TKWTL/IH01A-Compact_Induction_Heater/Images/README.md

# 图片档案

本目录保存 IH01A PCB/界面照片和实验截图。**图片仅记录具体拍摄与测试状态，不表示产品通过可靠性、效率或安全认证。**

## Product

- [PCB 正面](Product/正面.jpg)
- [PCB 背面](Product/背面.jpg)
- [OLED 关于页面](Product/关于页面.jpg)

## Testing

- **#001 移相驱动**：300 kHz 60°、120° 的实验波形。
- **#002 短脉冲检锅**：无锅、利乐牛奶包装、锅具贴合、1.6 mm 间距的原始截图，与 [检锅报告](../Docs/Experiments/PAN_DETECTION_PULSE_RINGDOWN_STUDY_2026-11-10.md) 对照。
- **#003 模拟信号链路**：300 kHz 空载和标称 71 W 测试工况下，电容电压与 CT、零电流检测、精密整流输出。
- **#004 半桥开关沿**：300 kHz 空载时上升沿与下降沿。
- **pan_*.svg**：从 #002 采样记录整理的描述性统计图，不得将 CCR2 相位计数图解释成精确时域余振包络。

照片命名沿用原试验序号，以便与测量笔记对应。历史文件路径保留在 Git 中；详见 [实验目录](../Docs/README.md)。当前 `Assembly/` 未提供装配照片，因此不提供装配图解。
