TKWTL/IH01A-Compact_Induction_Heater/Docs/Experiments/SWEEP_12V_UNLOADED_REPORT.md

# IH01A 12V 空载扫频/移相实测报告

| 项 | 值 |
|---|---|
| 电源 | **12V**（PD Fixed 12V/3A 合同，`bus≈12.0–12.1 V`） |
| 负载 | **空载（仅线圈，无锅/工件）** |
| 频率 | 160–400 kHz，10 kHz 步进（25 点，降序扫） |
| 移相 | 10–180°，10° 步进（18 点，升角扫） |
| 稳定时间 | 设定命令后 1.0 s 再读数 |
| 采点数 | 450（25×18），链路 0 坏帧，0 次重发 |
| 统计 | `ct_rms_a` max 1.687 A，min 0.000 A |
| 数据 | `Tools/sweep_12V_unloaded.csv`（长表）、`Tools/pivot_{ct,ic2,lag}.csv`（透视） |

## 每频率摘要（IC2 / LAG_DEG / CT_RMS_A）

| kHz | IC2@10° | IC2@180° | LAG@10° | LAG@90° | LAG@180° | CT@10° | CT@90° | CT@180° |
|---|---|---|---|---|---|---|---|---|
| 400 | NA | 301 | NA | +171.3 | +159.5 | 0.000 | 0.000 | 0.007 |
| 390 | NA | 307 | NA | +168.2 | +157.8 | 0.002 | 0.005 | 0.012 |
| 380 | NA | 315 | NA | +165.6 | +157.0 | 0.002 | 0.002 | 0.010 |
| 370 | NA | 320 | NA | +163.1 | +153.7 | 0.002 | 0.007 | 0.024 |
| 360 | NA | 327 | NA | +153.5 | +151.4 | 0.005 | 0.010 | 0.031 |
| 350 | NA | 334 | NA | +150.7 | +149.3 | 0.002 | 0.012 | 0.036 |
| 340 | NA | 341 | NA | +148.6 | +147.2 | 0.002 | 0.012 | 0.044 |
| 330 | NA | 350 | NA | +146.4 | +145.4 | 0.002 | 0.022 | 0.053 |
| 320 | NA | 358 | NA | +145.1 | +142.9 | 0.005 | 0.031 | 0.068 |
| 310 | NA | 368 | NA | +142.5 | +141.2 | 0.002 | 0.034 | 0.075 |
| 300 | NA | 377 | NA | +140.0 | +138.3 | 0.002 | 0.046 | 0.097 |
| 290 | NA | 387 | NA | +138.8 | +136.3 | 0.002 | 0.053 | 0.106 |
| 280 | NA | 398 | NA | +136.3 | +133.9 | 0.005 | 0.073 | 0.123 |
| 270 | NA | 410 | NA | +133.5 | +132.0 | 0.002 | 0.077 | 0.138 |
| 260 | NA | 422 | NA | +130.8 | +129.3 | 0.005 | 0.097 | 0.162 |
| 250 | NA | 435 | NA | +128.1 | +126.4 | 0.002 | 0.111 | 0.181 |
| 240 | NA | 449 | NA | +126.0 | +123.6 | 0.002 | 0.135 | 0.208 |
| 230 | 40 | 465 | -68.8 | +123.8 | +120.9 | 0.005 | 0.160 | 0.244 |
| 220 | 480 | 480 | -157.9 | +120.2 | +117.4 | 0.002 | 0.191 | 0.293 |
| 210 | 456 | 497 | +174.2 | +117.3 | +113.8 | 0.007 | 0.227 | 0.341 |
| 200 | 450 | 515 | +158.2 | +113.8 | +110.1 | 0.005 | 0.273 | 0.409 |
| 190 | 452 | 534 | +146.5 | +109.4 | +105.6 | 0.017 | 0.353 | 0.505 |
| 180 | 459 | 553 | +137.5 | +104.6 | +100.3 | 0.031 | 0.445 | 0.629 |
| 170 | 465 | 571 | +127.4 | +97.5 | +93.2 | 0.058 | 0.621 | 0.909 |
| 160 | 470 | 578 | +116.7 | +85.2 | +80.4 | 0.118 | 0.984 | 1.687 |

## `IC2=NA` 的分布（过零捕获失效区）

共 24 点，全部集中在**高频 + 低相角**（电流最小的角落），重读 2 次仍为 NA：

| kHz | NA 的相角 |
|---|---|
| 400 | 10°, 20° |
| 390 | 10°, 20° |
| 380 | 10°, 20° |
| 370 | 10°, 20° |
| 360 | 10°, 20° |
| 350 | 10°, 20° |
| 340 | 10°, 20° |
| 330 | 10° |
| 320 | 10° |
| 310 | 10° |
| 300 | 10° |
| 290 | 10° |
| 280 | 10° |
| 270 | 10° |
| 260 | 10° |
| 250 | 10° |
| 240 | 10° |

判定边界：`IC2` 可用所需的最小槽路电流约在 **CT_RMS ≈ 0.005–0.01 A**；
240 kHz 时 20° 已可用、10° 不可用，即边界由 频率×相角（等价于电流） 决定，不是固定相角。

## 主要趋势

1. **CT_RMS 随频率下降整体上升**：400 kHz/180° 为 0.007 A，160 kHz/180° 为 1.687 A（约 241 倍），
   符合接近空载谐振（~148.6 kHz）电流抬升的预期。中间 390→380 kHz 有 0.002 A 级回落，属零点/量化噪声量级。
2. **CT_RMS 随移相角单调上升**（每个频率内 10°→180° 递增），12V 空载下最大仅 1.687 A，远低于 10 A 保护门限。
3. **IC2 原始捕获随移相角递增**（如 160 kHz：470→578），随频率下降整体上移（同一个相角下）——捕获窗口跟着 ARR 变大。
4. **LAG_DEG 低频端整体下移**：400 kHz/180° 为 +159.5°，160 kHz/180° 为 +80.4°；低相角端在高频出现负值（-150°～-180° 附近），相角越高越趋于收敛。
5. LAG_DEG 为**未应用补偿表的原始计算角**（`ARR/4+D/2` 模周期），未做空载补偿，不可直接当作 ZVS 判据。

## 复现方式

```powershell
python Tools/heater_sweep.py --port COM19 --on --freqs 400-160:-10 --phases 10-180:10 `
       --settle 1.0 --preflight 6 --abort-ct 10 --supply-v 12 \
       --out Tools/sweep_12V_unloaded.csv
python Tools/heater_sweep_fill.py --csv Tools/sweep_12V_unloaded.csv   # 补测 NA 点
```

安全措施：每个频点先回到 10° 再改频率（不在 180° 下调频）；`CT_RMS_A ≥ 10 A`、ADC 饱和、`FAULT`、
`HEATER` 掉落 任一触发即中止；结束时必发 `heater off`。本次全程未触发，`heater` 状态 450/450 为 ON。
