TKWTL/IH01A-Compact_Induction_Heater/Images/Testing/#003 300K 71W 电容电压与精密整流器输出.png

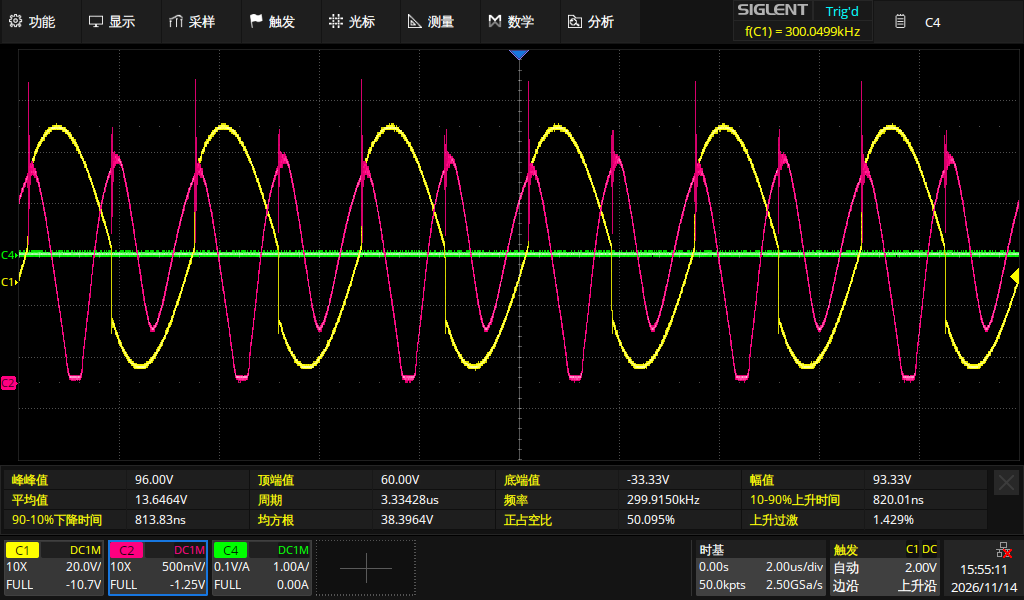
Images/Testing/#003 300K 71W 电容电压与精密整流器输出.png
