TKWTL/IH01A-Compact_Induction_Heater/Images/Testing/#003 300K空载电容电压与CT输出.png

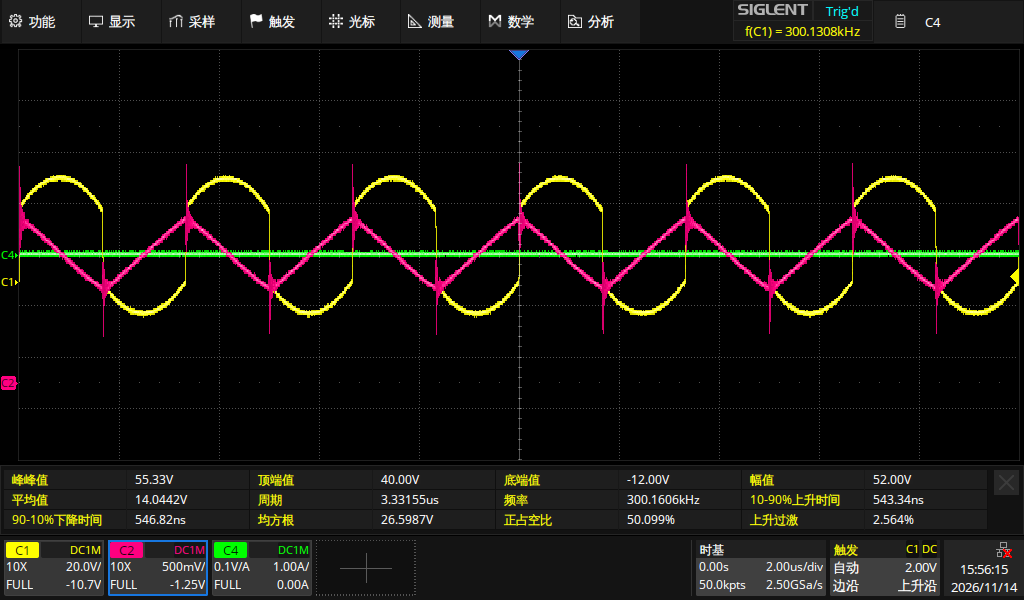
Images/Testing/#003 300K空载电容电压与CT输出.png
