TKWTL/IH01A-Compact_Induction_Heater/Images/Testing/#003 300K空载电容电压与电流过零检测.png

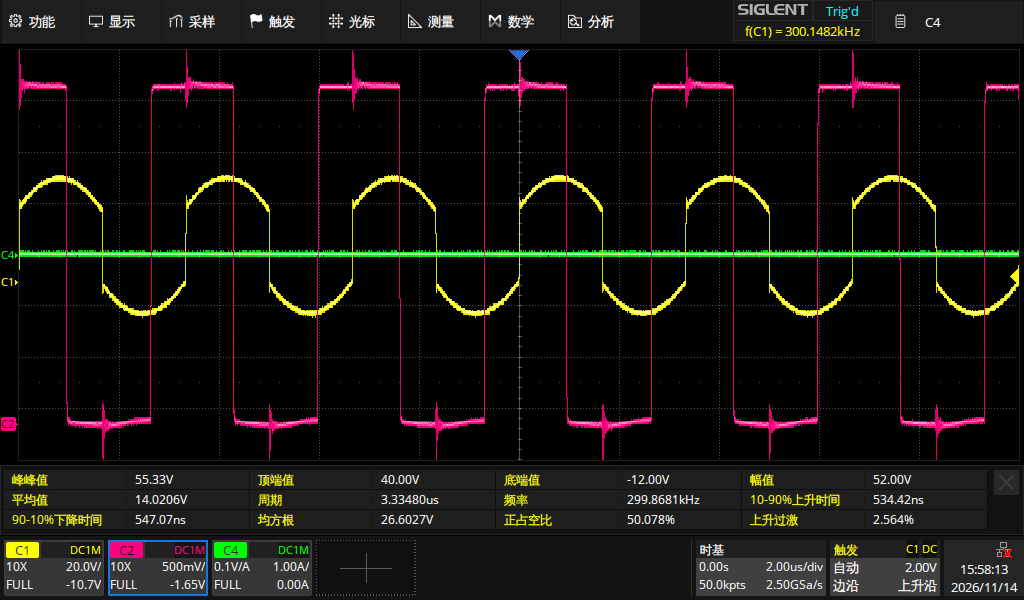
Images/Testing/#003 300K空载电容电压与电流过零检测.png
