TKWTL/IH01A-Compact_Induction_Heater/Images/Testing/#004 300K空载下半桥下降沿.png

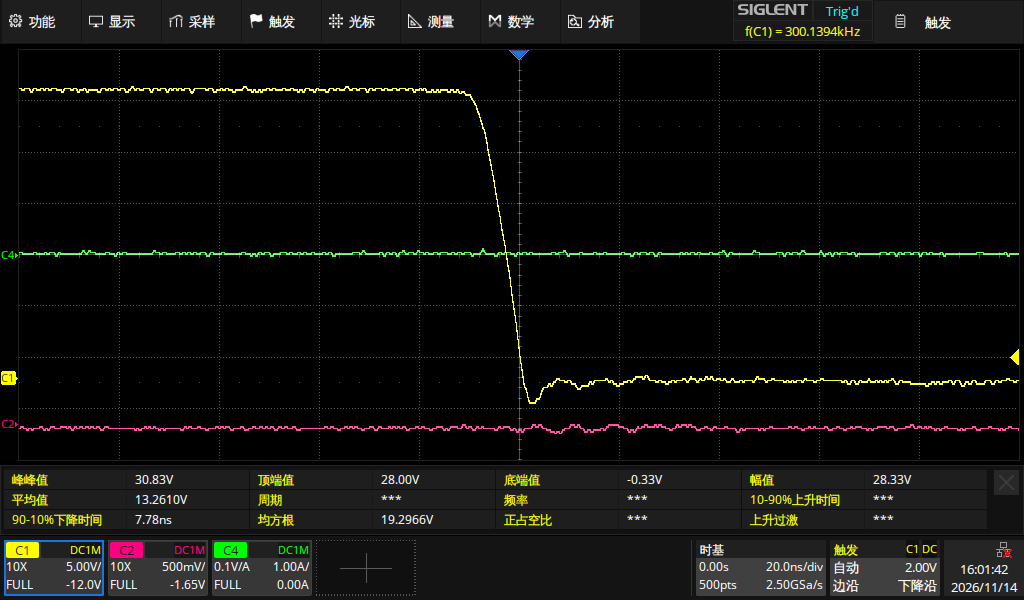
Images/Testing/#004 300K空载下半桥下降沿.png
