TKWTL/IH01A-Compact_Induction_Heater/Firmware/Core/Inc/main.h

#define EEP_WP_Pin LL_GPIO_PIN_13
#define EEP_WP_GPIO_Port GPIOC
#define BEEP_Pin LL_GPIO_PIN_0
#define BEEP_GPIO_Port GPIOF
#define ISR_TIME_Pin LL_GPIO_PIN_1
#define ISR_TIME_GPIO_Port GPIOF
#define ISR_LOAD_Pin LL_GPIO_PIN_0
#define ISR_LOAD_GPIO_Port GPIOA
#define NTC_POT_Pin LL_GPIO_PIN_1
#define NTC_POT_GPIO_Port GPIOA
#define NTC_SYS_Pin LL_GPIO_PIN_2
#define NTC_SYS_GPIO_Port GPIOA
#define CT_OCP_Pin LL_GPIO_PIN_3
#define CT_OCP_GPIO_Port GPIOA
#define VBIAS_Pin LL_GPIO_PIN_4
#define VBIAS_GPIO_Port GPIOA
#define IBUS_Pin LL_GPIO_PIN_5
#define IBUS_GPIO_Port GPIOA
#define VBUS_Pin LL_GPIO_PIN_2
#define VBUS_GPIO_Port GPIOB
#define CT_RMS_Pin LL_GPIO_PIN_10
#define CT_RMS_GPIO_Port GPIOB
#define CT_ZERO_Pin LL_GPIO_PIN_9
#define CT_ZERO_GPIO_Port GPIOA
#define PWM_EN_Pin LL_GPIO_PIN_6
#define PWM_EN_GPIO_Port GPIOC
#define ENTR_Pin LL_GPIO_PIN_7
#define ENTR_GPIO_Port GPIOC
#define R_Pin LL_GPIO_PIN_11
#define R_GPIO_Port GPIOA
#define L_Pin LL_GPIO_PIN_12
#define L_GPIO_Port GPIOA
#define EXIT_Pin LL_GPIO_PIN_3
#define EXIT_GPIO_Port GPIOD
#define D_C_Pin LL_GPIO_PIN_4
#define D_C_GPIO_Port GPIOB
