TKWTL/IH01A-Compact_Induction_Heater/Firmware/USBPD/App/usbpd_pdo_defs.h

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

#ifndef __USBPD_PDO_DEF_H_
#define __USBPD_PDO_DEF_H_

#ifdef __cplusplus
 extern "C" {
#endif

/* Includes ------------------------------------------------------------------*/
#include "usbpd_def.h"

/* Define   ------------------------------------------------------------------*/
#define PORT0_NB_SOURCEPDO         0U   /* Number of Source PDOs (applicable for port 0)   */
#define PORT0_NB_SINKPDO           5U   /* Number of Sink PDOs (applicable for port 0)     */
/* Exported typedef ----------------------------------------------------------*/
/* USER CODE BEGIN typedef */
/**
  * @brief  USBPD Port PDO Structure definition
  *
  */
/* USER CODE END typedef */

/* Exported define -----------------------------------------------------------*/
/* USER CODE BEGIN Exported_Define */

#define USBPD_CORE_PDO_SRC_FIXED_MAX_CURRENT 3
#define USBPD_CORE_PDO_SNK_FIXED_MAX_CURRENT 1500

/* USER CODE END Exported_Define */

/* Exported constants --------------------------------------------------------*/

/* Exported macro ------------------------------------------------------------*/

/* Exported variables --------------------------------------------------------*/
#ifndef __USBPD_PWR_IF_C
extern uint32_t PORT0_PDO_ListSRC[USBPD_MAX_NB_PDO];
extern uint32_t PORT0_PDO_ListSNK[USBPD_MAX_NB_PDO];
#else
/* Definition of Source PDO for Port 0 */
uint32_t PORT0_PDO_ListSRC[USBPD_MAX_NB_PDO] =
{
  /* PDO 1 */ (0x00000000U),
  /* PDO 2 */ (0x00000000U),
  /* PDO 3 */ (0x00000000U),
  /* PDO 4 */ (0x00000000U),
  /* PDO 5 */ (0x00000000U),
  /* PDO 6 */ (0x00000000U),
  /* PDO 7 */ (0x00000000U),
};

/* Definition of Sink PDO for Port 0 */
uint32_t PORT0_PDO_ListSNK[USBPD_MAX_NB_PDO] =
{
  /* PDO 1 */ ((100U << 10) | 300U), /* 5V 3A - SPR Fixed sink */
  /* PDO 2 */ ((180U << 10) | 300U), /* 9V 3A */
  /* PDO 3 */ ((240U << 10) | 300U), /* 12V 3A */
  /* PDO 4 */ ((300U << 10) | 300U), /* 15V 3A */
  /* PDO 5 */ ((400U << 10) | 500U), /* 20V 5A - EPR-capable baseline opening */
  /* PDO 6 */ (0x00000000U),
  /* PDO 7 */ (0x00000000U),
};

#endif

/* Exported functions --------------------------------------------------------*/

#ifdef __cplusplus
}
#endif

#endif /* __USBPD_PDO_DEF_H_ */
