TKWTL/IH01A-Compact_Induction_Heater/Firmware/APP/PowerControl/heater_budget.h

#ifndef IH01A_HEATER_BUDGET_H
#define IH01A_HEATER_BUDGET_H
#include <stdint.h>
#include "PowerControl/heater_control.h"
/* DPC27A-style source selection. Real PD contract outranks VBUS heuristics.
 * No power is available during PD negotiation, even at high VBUS.
 * Mode parameter maps to PD_InputKind without importing the ST PD stack. */
#define HEATER_DCIN_MIN_MV 8000u
#define HEATER_DCIN_CURRENT_MA 7000u
#define HEATER_BUDGET_MAX_MW 270000u
/* RDO current policy (mA): reserve a controller margin, then permit
 * an additional 150mA before the independent IBUS AWD2 watchdog trips.
 * Does not affect the separate CT/TIM1 Break peak-current protection. */
#define HEATER_RDO_HIGH_VOLTAGE_MV 20000u
#define HEATER_RDO_HIGH_MARGIN_MA 100u
#define HEATER_RDO_LOW_MARGIN_MA 200u
#define HEATER_IBUS_PROTECTION_HEADROOM_MA 150u
uint32_t Heater_InputControlLimitMa(uint32_t contract_mv,
                                    uint32_t contract_ma);
uint32_t Heater_InputProtectionLimitMa(uint32_t contract_mv,
                                       uint32_t contract_ma);
HeaterObservation Heater_BudgetClassify(uint32_t bus_mv,uint8_t pd_mode,
    uint8_t contract_valid,uint32_t contract_mv,uint32_t contract_ma);
#endif
