TKWTL/IH01A-Compact_Induction_Heater/Firmware/APP/PowerControl/conv_protection.c

/* IH01A protection bootstrap. Legacy G474 Protection_Init2 was empty;
 * its HRTIM FLT1 and ADC watchdog code are not binary-compatible with G071.
 *
 * CubeMX config: window comparator pair, COMP1 synthesized output to TIM1
 * BRK (active low), DAC1 CH1/CH2 as low/high thresholds.
 * The analog window is initialized AFTER zero capture and with PWM disabled.
 * TIM1 output enable is never granted by this module; real break response
 * and analog gain must still be validated with an oscilloscope.
 */
#include "conv_protection.h"
#include "conv_current.h"
#ifndef CONV_PROTECTION_HOST_TEST
#include "conv_controller.h"
#include "heater_control.h"
#include "main.h"
#include "tim.h"
#include "adc.h"
#include "dac.h"
#include "comp.h"
#include "framework/beep.h"
#include "framework/pm_api.h"
#include "display/dispDriver.h"
#include <stdio.h>
#define PROT_RAMFUNC __attribute__((section(".ih_ramfunc"),used,noinline))
#else
#define PROT_RAMFUNC
#endif
static volatile uint32_t s_fast_faults;
static volatile uint8_t s_zero_status;
static volatile uint16_t s_zero_samples,s_ct_zero,s_ibus_zero;
static volatile uint16_t s_ibus_trip_delta_raw;
static uint32_t s_ibus_limit_ma;
static uint16_t s_awd2_low,s_awd2_high;
/* Completed DMA samples BEFORE AWD2 IRQ: not the exact triggering sample. */
static volatile uint16_t s_ibus_run_last,s_ibus_run_min,s_ibus_run_max;
static volatile uint16_t s_awd2_pre_last,s_awd2_pre_min,s_awd2_pre_max;
static volatile uint8_t s_awd2_trip_valid;
static uint8_t s_comp_armed;
static uint8_t s_awd2_enabled;
static uint32_t s_ct_sum,s_ibus_sum;
static uint16_t s_settle,s_ct_min,s_ct_max,s_ib_min,s_ib_max;
static uint16_t s_dac1,s_dac2,s_low,s_high;
static uint8_t s_profile_ready,s_notified;
static uint32_t s_faults,s_fault_at;

void ConvProtection_Init(void)
{
    s_fast_faults=0u;
    s_zero_status=CONV_ZERO_WAIT;
    s_zero_samples=s_ct_zero=s_ibus_zero=0u;
    s_ibus_trip_delta_raw=0u;
    s_ibus_limit_ma=0u;
    s_awd2_low=0u;
    s_awd2_high=4095u;
    s_ibus_run_last=s_ibus_run_min=s_ibus_run_max=0u;
    s_awd2_pre_last=s_awd2_pre_min=s_awd2_pre_max=0u;
    s_awd2_trip_valid=0u;
    s_comp_armed=0u;
    s_awd2_enabled=0u;
    s_settle=0u;s_ct_sum=s_ibus_sum=0u;
    s_ct_min=s_ib_min=4095u;
    s_ct_max=s_ib_max=0u;
    s_dac1=s_dac2=0u;
    /* Nominal fixed hardware trip setting: +/-16 A peak at CT_OUT 75 mV/A.
     * Delta DAC code = round(16 A * 0.075 V/A * 4095 / 2.5 V) = 1966.
     * This configuration is NOT proof of safe current at any given VBUS,
     * resonance frequency or driver delay. Keep TIM1 hardware Break enabled;
     * verify comparator threshold and switching stress on real hardware.
     * No frequency-dependent capacitor-voltage limit is implemented. */
    s_low=s_high=(uint16_t)((CONV_CT_OUT_MV_PER_A*16u*4095u+1250u)/2500u);
    s_profile_ready=1u;
    s_notified=0u;
    s_faults=s_fault_at=0u;
}
static uint16_t clamp12(int32_t x)
{
    if(x<0)return 0u;
    if(x>4095)return 4095u;
    return (uint16_t)x;
}
void ConvProtection_CalcDacWindow(uint16_t vbias_raw,uint16_t arr,
                                  uint16_t low_delta,uint16_t high_delta,
                                  uint16_t *dac1,uint16_t *dac2)
{
    /* Revised CT_OCP amplifier is 0.075 V/A, independent of switching
     * frequency. ARR is retained only for source/API compatibility. */
    (void)arr;
    if(dac1)*dac1=clamp12((int32_t)vbias_raw-(int32_t)low_delta);
    if(dac2)*dac2=clamp12((int32_t)vbias_raw+(int32_t)high_delta);
}
void ConvProtection_SetDacProfile(uint16_t lo,uint16_t hi,uint8_t calibrated)
{
    s_low=lo;s_high=hi;
    s_profile_ready=(uint8_t)(calibrated && lo && hi);
}
/* Called from ADC1_COMP_IRQHandler before HAL_ADC_IRQHandler.
 * Latch the exact AWD source and make the interrupt one-shot; otherwise a
 * static overtemperature value would retrigger at the ADC scan rate. */
void ConvProtection_AnalogWatchdogISR(void)
{
#ifndef CONV_PROTECTION_HOST_TEST
    uint32_t pending=ADC1->ISR & ADC1->IER &
        (ADC_ISR_AWD1 | ADC_ISR_AWD2 | ADC_ISR_AWD3);
    if(!pending)return;
    if(pending&ADC_ISR_AWD1)s_fast_faults|=CONV_PROT_AWD_VBUS;
    if(pending&ADC_ISR_AWD2)
    {
        /* Source IRQ can precede completion of its DMA frame. */
        s_awd2_pre_last=s_ibus_run_last;
        s_awd2_pre_min=s_ibus_run_min;
        s_awd2_pre_max=s_ibus_run_max;
        s_awd2_trip_valid=1u;
        s_fast_faults|=CONV_PROT_AWD_IBUS;
    }
    if(pending&ADC_ISR_AWD3)s_fast_faults|=CONV_PROT_AWD_SYS;
    /* Disarm the asserted IRQ sources and clear their write-one flags;
     * the ADC scan and DMA remain active for diagnosis. */
    ADC1->IER &= ~pending;
    ADC1->ISR = pending;
    ConvController_TripISR();
#endif
}
PROT_RAMFUNC void ConvProtection_AutoFreqTripISR(void)
{
    s_fast_faults|=CONV_PROT_AUTO_FREQ;
#ifndef CONV_PROTECTION_HOST_TEST
    ConvController_TripISR();
#endif
}
PROT_RAMFUNC void ConvProtection_BreakISR(void)
{
#ifndef CONV_PROTECTION_HOST_TEST
    /* Do not clear BIF: it remains evidence of the first hardware trip.
     * Disable only the break interrupt to avoid a latched IRQ storm. */
    ConvController_TripISR();
    s_fast_faults|=CONV_PROT_TIM1_BREAK;
    TIM1->DIER &= ~TIM_DIER_BIE;
#endif
}
static void ibus_window_codes(uint16_t zero,uint32_t ma,
                              uint16_t *lower,uint16_t *upper)
{
    /* 0.2134 V/A; compute absolute current envelope around measured zero.
     * AWD2 checks only 8 MSBs: low rounds UP and high DOWN to avoid gaps
     * near nominal threshold; always retain 0..4095 legal bounds. */
    uint64_t raw=(uint64_t)ma*2134u*4095u+12500000u;
    uint32_t delta=(uint32_t)(raw/25000000u);
    uint32_t hi=(uint32_t)zero+delta;
    uint32_t lo=(delta>zero)?0u:(uint32_t)zero-delta;
    if(hi>4095u)hi=4095u;
    if(lower)*lower=(uint16_t)(((lo+15u)/16u)*16u);
    if(upper)*upper=(uint16_t)((hi/16u)*16u);
}
void ConvProtection_SetIbusLimitMa(uint32_t current_ma)
{
#ifndef CONV_PROTECTION_HOST_TEST
    uint16_t lower=0u,upper=4080u;
    uint8_t armed=(uint8_t)(ConvProtection_ZeroReady() && current_ma &&
                           !s_fast_faults && !s_faults);
    if(armed)ibus_window_codes(s_ibus_zero,current_ma,&lower,&upper);
    if(current_ma==s_ibus_limit_ma && lower==s_awd2_low &&
       upper==s_awd2_high && s_awd2_enabled==armed)return;
    if(armed && !s_awd2_enabled)
    {
        s_ibus_run_last=s_ibus_run_min=s_ibus_run_max=s_ibus_zero;
        s_awd2_trip_valid=0u;
    }
    s_awd2_enabled=armed;
    s_ibus_limit_ma=current_ma;
    s_awd2_low=lower;
    s_awd2_high=upper;
    ADC1->IER &= ~ADC_IER_AWD2IE;
    MODIFY_REG(ADC1->AWD2TR,ADC_AWD2TR_HT2|ADC_AWD2TR_LT2,
               ((uint32_t)upper<<ADC_AWD2TR_HT2_Pos) |
               ((uint32_t)lower<<ADC_AWD2TR_LT2_Pos));
    ADC1->ISR=ADC_ISR_AWD2;
    if(s_awd2_enabled)ADC1->IER |= ADC_IER_AWD2IE;
#else
    {
        uint8_t armed=(uint8_t)(ConvProtection_ZeroReady() && current_ma &&
                                !s_fast_faults && !s_faults);
        if(armed && !s_awd2_enabled)
        {
            s_ibus_run_last=s_ibus_run_min=s_ibus_run_max=s_ibus_zero;
            s_awd2_trip_valid=0u;
        }
        s_ibus_limit_ma=current_ma;
        s_awd2_low=0u;s_awd2_high=4080u;
        s_awd2_enabled=armed;
        if(s_awd2_enabled)
            ibus_window_codes(s_ibus_zero,current_ma,&s_awd2_low,&s_awd2_high);
    }
#endif
}

PROT_RAMFUNC void ConvProtection_FrameISR(const volatile uint16_t *frame)
{
    uint16_t ct,ibus;
    if(!frame)return;
    if(s_awd2_enabled && !s_awd2_trip_valid &&
       s_zero_status==CONV_ZERO_READY)
    {
        uint16_t sample=frame[CONV_ADC_IBUS];
        s_ibus_run_last=sample;
        if(sample<s_ibus_run_min)s_ibus_run_min=sample;
        if(sample>s_ibus_run_max)s_ibus_run_max=sample;
    }
    /* Raw watchdog equivalents run in the existing DMA IRQ; these detect
     * ADC rail/saturation, not accurately calibrated physical current. */
#ifndef CONV_PROTECTION_HOST_TEST
    /* Frame counter only; the old 10 s BENCH_TIMEOUT latch is gone, so a long
     * bench run no longer reports a spurious 0x00010000 fault. */
    (void)ConvController_BenchAdcFrameWatchdogISR();
#endif
    if(frame[CONV_ADC_VBUS]>=CONV_PROT_VBUS_RAIL_RAW)
    {
        s_fast_faults|=CONV_PROT_VBUS_RAIL;
#ifndef CONV_PROTECTION_HOST_TEST
        ConvController_TripISR();
#endif
    }
    if(frame[CONV_ADC_IBUS]>=CONV_PROT_IBUS_RAIL_RAW ||
       (s_zero_status==CONV_ZERO_READY && s_ibus_zero>=32u &&
        frame[CONV_ADC_IBUS]<=5u))
    {
        s_fast_faults|=CONV_PROT_IBUS_RAIL;
#ifndef CONV_PROTECTION_HOST_TEST
        ConvController_TripISR();
#endif
    }
    if(s_zero_status==CONV_ZERO_READY)
    {
        uint16_t current=frame[CONV_ADC_IBUS];
        uint16_t delta=(current>s_ibus_zero) ?
                       (uint16_t)(current-s_ibus_zero) :
                       (uint16_t)(s_ibus_zero-current);
        if(s_ibus_trip_delta_raw && delta>s_ibus_trip_delta_raw)
        {
            s_fast_faults|=CONV_PROT_IBUS_LIMIT;
#ifndef CONV_PROTECTION_HOST_TEST
            ConvController_TripISR();
#endif
        }
        return;
    }
    if(s_zero_status==CONV_ZERO_FAILED)return;
#ifndef CONV_PROTECTION_HOST_TEST
    /* Hard interlock: a zero window is invalid if the bridge was ever
     * enabled during settling or averaging. This check is independent
     * of the MiaoUI RUN request and scheduled start state. */
    if((TIM1->BDTR & TIM_BDTR_MOE)!=0u ||
       (PWM_EN_GPIO_Port->ODR & PWM_EN_Pin)!=0u)
    {
        s_zero_status=CONV_ZERO_FAILED;
        s_fast_faults|=CONV_PROT_ZERO_SWITCHING;
        ConvController_TripISR();
        return;
    }
#endif
    if(s_settle<CONV_ZERO_SETTLE_FRAMES){++s_settle;return;}
    s_zero_status=CONV_ZERO_COLLECT;
    ct=frame[CONV_ADC_CT_RMS];
    ibus=frame[CONV_ADC_IBUS];
    if(ct<s_ct_min)s_ct_min=ct;
    if(ct>s_ct_max)s_ct_max=ct;
    if(ibus<s_ib_min)s_ib_min=ibus;
    if(ibus>s_ib_max)s_ib_max=ibus;
    s_ct_sum+=ct;s_ibus_sum+=ibus;
    if(++s_zero_samples<CONV_ZERO_AVG_FRAMES)return;
    if((uint16_t)(s_ct_max-s_ct_min)>CONV_ZERO_MAX_SPAN_RAW ||
       (uint16_t)(s_ib_max-s_ib_min)>CONV_ZERO_MAX_SPAN_RAW ||
       s_ct_max>=4090u)
    {
        s_zero_status=CONV_ZERO_FAILED;
        s_fast_faults|=CONV_PROT_ZERO_UNSTABLE;
        return;
    }
    s_ct_zero=(uint16_t)((s_ct_sum+CONV_ZERO_AVG_FRAMES/2u)/
                          CONV_ZERO_AVG_FRAMES);
    s_ibus_zero=(uint16_t)((s_ibus_sum+CONV_ZERO_AVG_FRAMES/2u)/
                            CONV_ZERO_AVG_FRAMES);
    s_zero_status=CONV_ZERO_READY;
}
void ConvProtection_SetIbusTripDeltaRaw(uint16_t delta_raw)
{
    s_ibus_trip_delta_raw=delta_raw;
}
uint8_t ConvProtection_ZeroReady(void)
{
    return s_zero_status==CONV_ZERO_READY;
}
uint8_t ConvProtection_RequestZeroRecalibration(void)
{
#ifndef CONV_PROTECTION_HOST_TEST
    uint32_t irqmask=__get_PRIMASK();
    /* TIM6->ADC/DMA updates the zero averaging fields from its ISR; reset
     * all of them atomically while neither PC6 nor TIM1 MOE is enabled. */
    __disable_irq();
    if((PWM_EN_GPIO_Port->ODR&PWM_EN_Pin)!=0u ||
       (TIM1->BDTR&TIM_BDTR_MOE)!=0u ||
       s_zero_status!=CONV_ZERO_FAILED ||
       !ConvProtection_RearmableMask(ConvProtection_FaultMask()))
    {
        if((irqmask&1u)==0u)__enable_irq();
        return 0u;
    }
#else
    if(s_zero_status!=CONV_ZERO_FAILED ||
       !ConvProtection_RearmableMask(ConvProtection_FaultMask()))
        return 0u;
#endif
    /* This is a fresh calibration request only. Do NOT clear existing
     * evidence or turn on the bridge automatically after it completes. */
    s_zero_status=CONV_ZERO_WAIT;
    s_settle=0u;
    s_zero_samples=0u;
    s_ct_sum=s_ibus_sum=0u;
    s_ct_min=s_ib_min=4095u;
    s_ct_max=s_ib_max=0u;
    s_ct_zero=s_ibus_zero=0u;
#ifndef CONV_PROTECTION_HOST_TEST
    if((irqmask&1u)==0u)__enable_irq();
#endif
    return 1u;
}
uint32_t ConvProtection_FaultMask(void)
{
    return s_faults|s_fast_faults;
}

/* Only transient protection events are eligible for operator acknowledgment.
 * Failed zero calibration, comparator/DAC setup and auto-frequency validation
 * are NOT cleared by a manual start. */
#define CONV_REARMABLE_FAULTS ( \
    CONV_PROT_VBUS_RAIL | CONV_PROT_IBUS_RAIL | \
    CONV_PROT_ZERO_UNSTABLE | CONV_PROT_ZERO_SWITCHING | \
    CONV_PROT_NTC_POT | CONV_PROT_NTC_SYS | CONV_PROT_VBUS_LOW | \
    CONV_PROT_ADC_STALE | CONV_PROT_IBUS_LIMIT | \
    CONV_PROT_AWD_VBUS | CONV_PROT_AWD_IBUS | CONV_PROT_AWD_SYS | \
    CONV_PROT_TIM1_BREAK | CONV_PROT_BENCH_VBUS )
uint8_t ConvProtection_RearmableMask(uint32_t fault_mask)
{
    return (uint8_t)((fault_mask&~((uint32_t)CONV_REARMABLE_FAULTS))==0u);
}
uint8_t ConvProtection_AnalogInputsSafe(void)
{
#ifndef CONV_PROTECTION_HOST_TEST
    if(!s_comp_armed ||
       (COMP1->CSR&COMP_CSR_EN)==0u ||
       (COMP2->CSR&COMP_CSR_EN)==0u)
        return 0u;
    if(!ConvProtection_WithinWindow(
            (COMP1->CSR&COMP_CSR_VALUE)!=0u,
            (COMP2->CSR&COMP_CSR_VALUE)!=0u))
        return 0u;
    return (uint8_t)((GPIOA->IDR&LL_GPIO_PIN_6)!=0u);
#else
    return 0u;
#endif
}
/* Called only after a user RUN gesture with PC6 LOW.
 * Clearing the old diagnostic latch MUST also re-arm all one-shot
 * hardware ADC watchdog IRQs. Persistent electrical faults are rejected. */
uint8_t ConvProtection_VbusSamplesSafe(uint16_t raw,uint16_t filtered)
{
    /* Keep actual ~8V undervoltage and ADC rail monitoring; the previous
     * 1050..1400 ADC code range was 12V-only and rejected valid 20/28V.
     * The caller additionally verifies the active PD contract against VBUS. */
    return (uint8_t)(raw>=819u && filtered>=819u &&
                     raw<CONV_PROT_VBUS_RAIL_RAW &&
                     filtered<CONV_PROT_VBUS_RAIL_RAW);
}
uint8_t ConvProtection_ManualRearm(uint32_t now_ms)
{
#ifndef CONV_PROTECTION_HOST_TEST
    ConvADC_Snapshot adc;
    uint16_t lo,hi,raw,filtered,delta;
    uint32_t faults,primask;
    faults=ConvProtection_FaultMask();
    if(!faults)return 1u;
    if(!ConvProtection_RearmableMask(faults) ||
       s_zero_status!=CONV_ZERO_READY ||
       !s_profile_ready || !s_comp_armed ||
       s_ibus_limit_ma==0u ||
       (uint32_t)(now_ms-s_fault_at)<100u ||
       (PWM_EN_GPIO_Port->ODR&PWM_EN_Pin)!=0u ||
       !ConvProtection_AnalogInputsSafe())
        return 0u;
    ConvADC_CopySnapshot(&adc);
    if(!adc.frames ||
       adc.raw[CONV_ADC_IBUS]<=5u ||
       adc.raw[CONV_ADC_IBUS]>=CONV_PROT_IBUS_RAIL_RAW ||
       !ConvProtection_VbusSamplesSafe(
           adc.raw[CONV_ADC_VBUS],adc.filtered[CONV_ADC_VBUS]) ||
       adc.raw[CONV_ADC_NTC_SYS]<640u ||
       adc.filtered[CONV_ADC_NTC_SYS]<640u ||
       adc.raw[CONV_ADC_VBIAS]<s_low ||
       (uint32_t)adc.raw[CONV_ADC_VBIAS]+s_high>4095u)
        return 0u;
    ibus_window_codes(s_ibus_zero,s_ibus_limit_ma,&lo,&hi);
    raw=adc.raw[CONV_ADC_IBUS];
    filtered=adc.filtered[CONV_ADC_IBUS];
    /* AWD2 compares the 8 MSBs. Stay at least 16 ADC codes inside
     * its actual window to prevent immediate quantization-edge retrips. */
    if(hi<=lo+32u ||
       raw<=lo+16u || raw>=hi-16u ||
       filtered<=lo+16u || filtered>=hi-16u)
        return 0u;
    delta=(uint16_t)(raw>s_ibus_zero?raw-s_ibus_zero:s_ibus_zero-raw);
    if(s_ibus_trip_delta_raw && delta>=s_ibus_trip_delta_raw)
        return 0u;

    primask=__get_PRIMASK();
    __disable_irq();
    /* Do not clear an IRQ fault if any fresh interrupt appeared between
     * the ADC copy and this critical section. */
    if(ConvProtection_FaultMask()!=faults ||
       (PWM_EN_GPIO_Port->ODR&PWM_EN_Pin)!=0u ||
       !ConvProtection_AnalogInputsSafe())
    {
        if((primask&1u)==0u)__enable_irq();
        return 0u;
    }
    ADC1->IER &= ~(ADC_IER_AWD1IE|ADC_IER_AWD2IE|ADC_IER_AWD3IE);
    ADC1->ISR=ADC_ISR_AWD1|ADC_ISR_AWD2|ADC_ISR_AWD3;
    s_fast_faults=0u;
    s_faults=0u;
    s_notified=0u; /* allow a new alarm on a genuine second trip */
    s_fault_at=0u; /* remove the old fault overlay */
    s_awd2_enabled=0u;
    ConvProtection_SetIbusLimitMa(s_ibus_limit_ma);
    ADC1->IER |= ADC_IER_AWD1IE|ADC_IER_AWD3IE;
    if((primask&1u)==0u)__enable_irq();
    return (uint8_t)(ConvProtection_FaultMask()==0u && s_awd2_enabled);
#else
    (void)now_ms;
    return 0u;
#endif
}

uint8_t ConvProtection_WithinWindow(uint8_t above_low,uint8_t above_high)
{
    /* At positive comparator inputs shared from CT_OCP:
     * COMP1 compares signal > lower DAC, COMP2 compares signal > upper DAC.
     * Window synthesized on COMP1_OUT is (COMP1 xor COMP2).
     * HAL_COMP_GetOutputLevel() reads a comparator's individual CSR.VALUE
     * and therefore MUST NOT be used alone as the window output level. */
    return (uint8_t)((above_low!=0u) && (above_high==0u));
}
uint8_t ConvProtection_CompArmed(void)
{
#ifndef CONV_PROTECTION_HOST_TEST
    return (uint8_t)(s_comp_armed &&
                     (COMP1->CSR&COMP_CSR_EN)!=0u &&
                     (COMP2->CSR&COMP_CSR_EN)!=0u &&
                     ConvProtection_FaultMask()==0u);
#else
    return 0u;
#endif
}
uint8_t ConvProtection_WindowSafe(void)
{
#ifndef CONV_PROTECTION_HOST_TEST
    if(!ConvProtection_ZeroReady() ||
       ConvProtection_FaultMask()!=0u ||
       !ConvProtection_AnalogInputsSafe() ||
       (TIM1->SR&TIM_SR_BIF)!=0u)
        return 0u;
    return 1u;
#else
    return 0u; /* host has no COMP/GPIO hardware */
#endif
}
void ConvProtection_GetSnapshot(ConvProtectionSnapshot *out)
{
    if(!out)return;
    out->zero_status=(ConvZeroStatus)s_zero_status;
    out->ct_zero_raw=s_ct_zero;
    out->ibus_zero_raw=s_ibus_zero;
    out->zero_samples=s_zero_samples;
    out->dac1_code=s_dac1;out->dac2_code=s_dac2;
    out->dac_profile_ready=s_profile_ready;
    out->comp_armed=s_comp_armed;
    out->awd2_enabled=s_awd2_enabled;
    out->awd2_low_code=s_awd2_low;
    out->awd2_high_code=s_awd2_high;
    out->ibus_limit_ma=s_ibus_limit_ma;
    out->awd2_trip_valid=s_awd2_trip_valid;
    out->awd2_pre_last_raw=s_awd2_pre_last;
    out->awd2_pre_min_raw=s_awd2_pre_min;
    out->awd2_pre_max_raw=s_awd2_pre_max;
    out->ibus_run_last_raw=s_ibus_run_last;
    out->ibus_run_min_raw=s_ibus_run_min;
    out->ibus_run_max_raw=s_ibus_run_max;
    out->fault_mask=ConvProtection_FaultMask();
}
#ifndef CONV_PROTECTION_HOST_TEST
static uint8_t Protection_ApplyCompWindow(uint16_t lower,uint16_t upper)
{
    if(!s_comp_armed)
    {
        /* No switching while analog references and window mode initialize. */
        ConvController_TripISR();
        if(HAL_DAC_SetValue(&hdac1,DAC_CHANNEL_1,DAC_ALIGN_12B_R,lower)!=HAL_OK ||
           HAL_DAC_SetValue(&hdac1,DAC_CHANNEL_2,DAC_ALIGN_12B_R,upper)!=HAL_OK ||
           HAL_DAC_Start(&hdac1,DAC_CHANNEL_1)!=HAL_OK ||
           HAL_DAC_Start(&hdac1,DAC_CHANNEL_2)!=HAL_OK)
            return 0u;

        /* MX_COMP2_Init executes after MX_COMP1_Init and the HAL can clear
         * the shared WINMODE bits. Reapply the requested COMP1 window
         * configuration AFTER both handles are initialized. */
        if(HAL_COMP_Init(&hcomp1)!=HAL_OK)return 0u;
        if(HAL_COMP_Start(&hcomp1)!=HAL_OK ||
           HAL_COMP_Start(&hcomp2)!=HAL_OK)return 0u;
        /* COMP1 window output high=within thresholds, low=outside;
         * TIM1 Break polarity LOW. This must be oscilloscope-validated
         * before allowing a nonzero heater power target. */
        s_comp_armed=1u;
        return 1u;
    }
    if(lower!=s_dac1 || upper!=s_dac2)
    {
        if(HAL_DAC_SetValue(&hdac1,DAC_CHANNEL_1,DAC_ALIGN_12B_R,lower)!=HAL_OK ||
           HAL_DAC_SetValue(&hdac1,DAC_CHANNEL_2,DAC_ALIGN_12B_R,upper)!=HAL_OK)
            return 0u;
    }
    return 1u;
}
#endif

void ConvProtection_Service(uint32_t now,const ConvADC_Snapshot *adc,
                            const TempService_Snapshot *temp)
{
    uint32_t fresh=s_fast_faults;
    uint8_t heating=0u;
#ifndef CONV_PROTECTION_HOST_TEST
    HeaterSnapshot heater;
    Heater_GetSnapshot(&heater);
    heating=(uint8_t)(heater.state==HEATER_RUN_REQUESTED);
#endif
    if(adc && adc->frames)
    {
        /* For ±12A at revised 0.075V/A, both DAC codes must be legal.
         * An out-of-range VBIAS would invalidate the two-sided trip window. */
        if(s_profile_ready && ConvProtection_ZeroReady() &&
           (ConvProtection_FaultMask()==0u ||
            ConvProtection_RearmableMask(ConvProtection_FaultMask())))
        {
            uint16_t bias=adc->filtered[CONV_ADC_VBIAS];
            uint16_t lower,upper;
            if(bias<s_low || (uint32_t)bias+s_high>4095u)
                fresh|=CONV_PROT_DAC_RANGE;
            else
            {
                ConvProtection_CalcDacWindow(bias,0u,s_low,s_high,
                                              &lower,&upper);
#ifndef CONV_PROTECTION_HOST_TEST
                if(!Protection_ApplyCompWindow(lower,upper))
                    fresh|=CONV_PROT_COMP_SETUP;
                else
#endif
                {
                    s_dac1=lower;
                    s_dac2=upper;
                }
            }
        }
        /* VBUS ~8V lower bound: ADC 2.5V ref and external x16 divider. */
        if(heating && adc->filtered[CONV_ADC_VBUS]<819u)
            fresh|=CONV_PROT_VBUS_LOW;
    }
    if(heating && temp)
    {
        if(!(temp->valid&TEMP_VALID_POT) || temp->pot_deci_c>=1300)
            fresh|=CONV_PROT_NTC_POT;
        if(!(temp->valid&TEMP_VALID_SYS) || temp->sys_deci_c>=850)
            fresh|=CONV_PROT_NTC_SYS;
        if((uint32_t)(now-temp->updated_ms)>500u)
            fresh|=CONV_PROT_ADC_STALE;
    }
    fresh &= ~s_faults;
    if(!fresh)return;
#ifndef CONV_PROTECTION_HOST_TEST
    if(fresh&CONV_PROT_AWD_IBUS)
    {
        /* Logged once from foreground, NEVER from ADC IRQ.
         * PRE_* are prior completed DMA samples, not the tripping ADC DR. */
        printf("[AWD2_IBUS] TRIP_MA=%lu ZERO=%u LO=%u HI=%u "
               "PRE_LAST=%u PRE_MIN=%u PRE_MAX=%u VALID=%u\r\n",
               (unsigned long)s_ibus_limit_ma,(unsigned)s_ibus_zero,
               (unsigned)s_awd2_low,(unsigned)s_awd2_high,
               (unsigned)s_awd2_pre_last,(unsigned)s_awd2_pre_min,
               (unsigned)s_awd2_pre_max,(unsigned)s_awd2_trip_valid);
    }
#endif
    s_faults|=fresh;
    s_fault_at=now;
#ifndef CONV_PROTECTION_HOST_TEST
    ConvController_TripISR(); /* foreground faults also gate PWM immediately */
    Heater_LatchFault(s_faults);
    pm_api_refresh_idle();
    if(!s_notified)
    {
        static const beep_note_t alarm[]={
            {BEEP_A5,100u},{BEEP_REST,80u},{BEEP_A5,150u},BEEP_END
        };
        (void)beep_popup(alarm);
        s_notified=1u;
    }
#endif
}
#ifndef CONV_PROTECTION_HOST_TEST
void ConvProtection_DrawFaultOverlay(void)
{
    char line[25];
    uint32_t now=HAL_GetTick();
    if(!s_faults || (uint32_t)(now-s_fault_at)>=4000u)return;
    Disp_ClearBuffer();
    Disp_SetFont(UI_FONT);
    Disp_DrawFrame(0u,0u,128u,64u);
    Disp_DrawStr(8u,15u,"HEATER FAULT");
    (void)snprintf(line,sizeof(line),"CODE %08lX",(unsigned long)s_faults);
    Disp_DrawStr(8u,33u,line);
    Disp_DrawStr(8u,51u,"OUTPUT DISABLED");
    Disp_SendBuffer();
}
#endif
