TKWTL/IH01A-Compact_Induction_Heater/Firmware/APP/PowerControl/conv_current.c

#include "conv_current.h"
uint32_t ConvCurrent_CtRmsMilliAmp(uint16_t filtered_raw,uint16_t zero_raw)
{
    uint32_t delta,den;
    if(filtered_raw>4095u)filtered_raw=4095u;
    if(zero_raw>4095u)zero_raw=4095u;
    if(filtered_raw<=zero_raw)return 0u;
    delta=(uint32_t)(filtered_raw-zero_raw);
    /* CT_OUT 0.100 -> 0.075 V/A (3/4). Unchanged rectifier gain implies
     * CT_RMS 0.25253*3/4 = 0.1893975 V/A. Bench recalibration required.
     * I[mA] = delta * 1,000,000,000 / (4095 * 25253 * 3). */
    den=4095u*25253u*3u;
    return (uint32_t)(((uint64_t)delta*1000000000u+den/2u)/den);
}

int32_t ConvCurrent_IbusMilliAmp(uint16_t filtered_raw,uint16_t zero_raw)
{
    int32_t delta=(int32_t)filtered_raw-(int32_t)zero_raw;
    uint32_t magnitude,ma,den=4095u*2134u;
    if(filtered_raw>4095u || zero_raw>4095u)return 0;
    magnitude=(uint32_t)(delta<0?-delta:delta);
    /* 0.2134 V/A = 2134/10 mV/A; VREF 2500mV.
     * mA = |delta| * (2500*1000*10)/(4095*2134).
     * uint64_t prevents overflow with the full 12-bit ADC span. */
    ma=(uint32_t)(((uint64_t)magnitude*25000000u+den/2u)/den);
    return delta<0?-(int32_t)ma:(int32_t)ma;
}
