TKWTL/IH01A-Compact_Induction_Heater/Firmware/ST_USBPD_Library_v541/Devices/STM32G0XX/src/usbpd_phy_hw_if.c

/**
  ******************************************************************************
  * @file    usbpd_phy_hw_if.c
  * @author  MCD Application Team
  * @brief   This file contains phy interface control functions.
  ******************************************************************************
  * @attention
  *
  * Copyright (c) 2018 STMicroelectronics.
  * All rights reserved.
  *
  * This software is licensed under terms that can be found in the LICENSE file
  * in the root directory of this software component.
  * If no LICENSE file comes with this software, it is provided AS-IS.
  *
  ******************************************************************************
  */

/* Includes ------------------------------------------------------------------*/
#define USBPD_PHY_HW_IF_C

#include "usbpd_devices_conf.h"
#include "usbpd_hw.h"
#include "usbpd_core.h"
#include "usbpd_hw_if.h"
/* IH01A: EPR / hardware policy switches (IH01A_PD_FORCE_SINK_TXOK, ...).
 * Must be included before the IS_... helpers below use them. */
#include "algorithm/pd_epr_policy.h"
#if !defined(USBPDCORE_LIB_NO_PD)
#include "usbpd_timersserver.h"
#endif /* !USBPDCORE_LIB_NO_PD */
#if defined(_LOW_POWER)
#include "usbpd_lowpower.h"
#include "usbpd_cad_hw_if.h"
#endif /* _LOW_POWER */

/* Private typedef -----------------------------------------------------------*/
#define PHY_ENTER_CRITICAL_SECTION()  uint32_t primask = __get_PRIMASK(); \
  __disable_irq();

#define PHY_LEAVE_CRITICAL_SECTION()  __set_PRIMASK(primask);

/* Private function prototypes -----------------------------------------------*/
USBPD_PORT_HandleTypeDef Ports[USBPD_PORT_COUNT];


/* Private functions ---------------------------------------------------------*/


void USBPD_HW_IF_GlobalHwInit(void)
{
  /* PWR register access (for disabling dead battery feature) */
  LL_APB1_GRP1_EnableClock(LL_APB1_GRP1_PERIPH_PWR);
  LL_AHB1_GRP1_EnableClock(LL_AHB1_GRP1_PERIPH_CRC);

}

#if !defined(USBPDCORE_LIB_NO_PD)
void USBPD_HW_IF_StopBISTMode2(uint8_t PortNum)
{
  uint32_t  _cr = READ_REG(Ports[PortNum].husbpd->CR) & ~(UCPD_CR_TXMODE | UCPD_CR_TXSEND);

  LL_UCPD_Disable(Ports[PortNum].husbpd);
  LL_UCPD_Enable(Ports[PortNum].husbpd);

  Ports[PortNum].husbpd->CR = _cr;
}

USBPD_StatusTypeDef USBPD_HW_IF_SendBuffer(uint8_t PortNum, USBPD_SOPType_TypeDef Type, uint8_t *pBuffer, uint32_t Size)
{
  USBPD_StatusTypeDef _status = USBPD_OK;

  /* IH01A: record what actually reaches the wire (one record per message
   * type). App-level logs cannot tell "PE built nothing" from "PE built it
   * and the PHY dropped it"; this can. Queue only, no printing here. */
  if ((USBPD_SOPTYPE_HARD_RESET != Type) && (0U != Size))
  {
    extern void PD_TxTrace(uint32_t type, uint32_t hdr, uint32_t size,
                           uint32_t do1, uint32_t do2);
    {
      uint32_t _d1 = 0U, _d2 = 0U;
      if (Size >= 6U)
      {
        _d1 = (uint32_t)pBuffer[2] | ((uint32_t)pBuffer[3] << 8) |
              ((uint32_t)pBuffer[4] << 16) | ((uint32_t)pBuffer[5] << 24);
        if (Size >= 10U)
          _d2 = (uint32_t)pBuffer[6] | ((uint32_t)pBuffer[7] << 8) |
                ((uint32_t)pBuffer[8] << 16) | ((uint32_t)pBuffer[9] << 24);
      }
      PD_TxTrace((uint32_t)(pBuffer[0] & 0x1FU),
                 (uint32_t)pBuffer[0] | ((uint32_t)pBuffer[1] << 8), Size,
                 _d1, _d2);
    }
  }

  if (USBPD_SOPTYPE_HARD_RESET == Type)
  {
    LL_UCPD_SendHardReset(Ports[PortNum].husbpd);
  }
  else
  {
    PHY_ENTER_CRITICAL_SECTION()

    /* If RX is ongoing or if a DMA transfer is active then discard the buffer sending */
    if ((Ports[PortNum].RXStatus == USBPD_TRUE) || ((Ports[PortNum].hdmatx->CCR &  DMA_CCR_EN) == DMA_CCR_EN))
    {
      PHY_LEAVE_CRITICAL_SECTION()
      _status = USBPD_ERROR;
      /* IH01A: the PHY refused this message. A PE that does not retry would
       * look exactly like "request accepted, nothing ever happens". */
      if (0U != Size)
      {
        extern void PD_TxReject(uint32_t type, uint32_t status);
        PD_TxReject((uint32_t)(pBuffer[0] & 0x1FU), (uint32_t)_status);
      }
    }
    else
    {
      PHY_LEAVE_CRITICAL_SECTION()

      switch (Type)
      {
        case USBPD_SOPTYPE_SOP :
        {
          LL_UCPD_WriteTxOrderSet(Ports[PortNum].husbpd, LL_UCPD_ORDERED_SET_SOP);
          LL_UCPD_SetTxMode(Ports[PortNum].husbpd, LL_UCPD_TXMODE_NORMAL);
          break;
        }
        case USBPD_SOPTYPE_SOP1 :
        {
          LL_UCPD_WriteTxOrderSet(Ports[PortNum].husbpd, LL_UCPD_ORDERED_SET_SOP1);
          LL_UCPD_SetTxMode(Ports[PortNum].husbpd, LL_UCPD_TXMODE_NORMAL);
          break;
        }
        case USBPD_SOPTYPE_SOP2 :
        {
          LL_UCPD_WriteTxOrderSet(Ports[PortNum].husbpd, LL_UCPD_ORDERED_SET_SOP2);
          LL_UCPD_SetTxMode(Ports[PortNum].husbpd, LL_UCPD_TXMODE_NORMAL);
          break;
        }
        case USBPD_SOPTYPE_CABLE_RESET :
        {
          LL_UCPD_SetTxMode(Ports[PortNum].husbpd, LL_UCPD_TXMODE_CABLE_RESET);
          break;
        }
        case USBPD_SOPTYPE_BIST_MODE_2 :
        {
          LL_UCPD_SetTxMode(Ports[PortNum].husbpd, LL_UCPD_TXMODE_BIST_CARRIER2);
          break;
        }
        default :
          _status = USBPD_ERROR;
          break;
      }

      if (USBPD_OK == _status)
      {
#if defined(_LOW_POWER)
        UTIL_LPM_SetStopMode(0 == PortNum ? LPM_PE_0 : LPM_PE_1, UTIL_LPM_DISABLE);
#endif /* _LOW_POWER */
        CLEAR_BIT(Ports[PortNum].hdmatx->CCR, DMA_CCR_EN);
        while ((Ports[PortNum].hdmatx->CCR &  DMA_CCR_EN) == DMA_CCR_EN);

        WRITE_REG(Ports[PortNum].hdmatx->CMAR, (uint32_t)pBuffer);
        WRITE_REG(Ports[PortNum].hdmatx->CNDTR, Size);
        SET_BIT(Ports[PortNum].hdmatx->CCR, DMA_CCR_EN);

        LL_UCPD_WriteTxPaySize(Ports[PortNum].husbpd, Size);
        LL_UCPD_SendMessage(Ports[PortNum].husbpd);
      }
    }
  }
  return _status;
}

void USBPD_HW_IF_Send_BIST_Pattern(uint8_t PortNum)
{
  LL_UCPD_SetTxMode(Ports[PortNum].husbpd, LL_UCPD_TXMODE_BIST_CARRIER2);
  LL_UCPD_SendMessage(Ports[PortNum].husbpd);
}
#endif /* !USBPDCORE_LIB_NO_PD */

/**
  * @brief  Assert Rp resistors
  * @param  PortNum Port
  * @retval None
  */
void USBPDM1_AssertRp(uint8_t PortNum)
{
  LL_APB2_GRP1_EnableClock(LL_APB2_GRP1_PERIPH_SYSCFG);
  switch (Ports[PortNum].params->RpResistor)
  {
    case vRp_Default :
      LL_UCPD_SetRpResistor(Ports[PortNum].husbpd, LL_UCPD_RESISTOR_DEFAULT);
      break;
    case vRp_1_5A:
      LL_UCPD_SetRpResistor(Ports[PortNum].husbpd, LL_UCPD_RESISTOR_1_5A);
      break;
    case vRp_3_0A:
      LL_UCPD_SetRpResistor(Ports[PortNum].husbpd, LL_UCPD_RESISTOR_3_0A);
      break;
    default:
      break;
  }
  LL_UCPD_SetccEnable(Ports[PortNum].husbpd, LL_UCPD_CCENABLE_NONE);
  LL_UCPD_SetSRCRole(Ports[PortNum].husbpd);
  if (CCNONE == Ports[PortNum].CCx)
  {
    LL_UCPD_SetccEnable(Ports[PortNum].husbpd, LL_UCPD_CCENABLE_CC1CC2);
  }
  else
  {
    LL_UCPD_SetccEnable(Ports[PortNum].husbpd,
                        (Ports[PortNum].CCx == CC1) ? LL_UCPD_CCENABLE_CC1 : LL_UCPD_CCENABLE_CC2);
  }
  SET_BIT(SYSCFG->CFGR1, (Ports[PortNum].husbpd == UCPD1) ? SYSCFG_CFGR1_UCPD1_STROBE : SYSCFG_CFGR1_UCPD2_STROBE);

#if defined(TCPP0203_SUPPORT)
  BSP_USBPD_PWR_SetRole(PortNum, POWER_ROLE_SOURCE);
#endif /* TCPP0203_SUPPORT */
}
/**
  * @brief  De-assert Rp resistors
  * @param  PortNum Port
  * @retval None
  */
void USBPDM1_DeAssertRp(uint8_t PortNum)
{
  /* Not needed on STM32G0xx, so nothing to do, keep only for compatibility */
  UNUSED(PortNum);
}

/**
  * @brief  Assert Rd resistors
  * @param  PortNum Port
  * @retval None
  */
void USBPDM1_AssertRd(uint8_t PortNum)
{
  LL_UCPD_TypeCDetectionCC2Disable(Ports[PortNum].husbpd);
  LL_UCPD_TypeCDetectionCC1Disable(Ports[PortNum].husbpd);

  LL_APB2_GRP1_EnableClock(LL_APB2_GRP1_PERIPH_SYSCFG);
  LL_UCPD_SetccEnable(Ports[PortNum].husbpd, LL_UCPD_CCENABLE_NONE);
  LL_UCPD_SetSNKRole(Ports[PortNum].husbpd);
  if (CCNONE == Ports[PortNum].CCx)
  {
    LL_UCPD_SetccEnable(Ports[PortNum].husbpd, LL_UCPD_CCENABLE_CC1CC2);
  }
  else
  {
    LL_UCPD_SetccEnable(Ports[PortNum].husbpd,
                        (Ports[PortNum].CCx == CC1) ? LL_UCPD_CCENABLE_CC1 : LL_UCPD_CCENABLE_CC2);
  }

  SET_BIT(SYSCFG->CFGR1, (Ports[PortNum].husbpd == UCPD1) ? SYSCFG_CFGR1_UCPD1_STROBE : SYSCFG_CFGR1_UCPD2_STROBE);
  HAL_Delay(1);

#ifndef _LOW_POWER
  LL_UCPD_TypeCDetectionCC2Enable(Ports[PortNum].husbpd);
  LL_UCPD_TypeCDetectionCC1Enable(Ports[PortNum].husbpd);
#endif /* _LOW_POWER */

#if defined(TCPP0203_SUPPORT)
  BSP_USBPD_PWR_SetRole(PortNum, POWER_ROLE_SINK);
#endif /* TCPP0203_SUPPORT */
}

/**
  * @brief  Assert Rd resistors
  * @param  PortNum Port
  * @retval none
  */
void USBPDM1_DeAssertRd(uint8_t PortNum)
{
  /* Not needed on STM32G0xx, so nothing to do, keep only for compatibility */
  UNUSED(PortNum);
}

/**
  * @brief  Enter error recovery
  * @param  PortNum Port
  * @retval None
  */
void USBPDM1_EnterErrorRecovery(uint8_t PortNum)
{
  LL_APB2_GRP1_EnableClock(LL_APB2_GRP1_PERIPH_SYSCFG);
  LL_UCPD_SetSRCRole(Ports[PortNum].husbpd);
  LL_UCPD_SetRpResistor(Ports[PortNum].husbpd, LL_UCPD_RESISTOR_NONE);
  LL_UCPD_SetccEnable(Ports[PortNum].husbpd, LL_UCPD_CCENABLE_NONE);
  SET_BIT(SYSCFG->CFGR1, (Ports[PortNum].husbpd == UCPD1) ? SYSCFG_CFGR1_UCPD1_STROBE : SYSCFG_CFGR1_UCPD2_STROBE);
  LL_UCPD_RxDisable(Ports[PortNum].husbpd);

#if !defined(USBPDCORE_LIB_NO_PD)
  if (Ports[PortNum].settings->PE_PD3_Support.d.PE_FastRoleSwapSupport == USBPD_TRUE)
  {
    /* Set GPIO to disallow the FRS RX handling */
    LL_UCPD_FRSDetectionDisable(Ports[PortNum].husbpd);
  }
#endif /* USBPDCORE_LIB_NO_PD */
}

/**
  * @brief  Set the correct CC pin on the comparator
  * @param  PortNum Port
  * @param  cc CC pin based on @ref CCxPin_TypeDef
  * @retval None
  */
void USBPDM1_Set_CC(uint8_t PortNum, CCxPin_TypeDef cc)
{
  /* Set the correct pin on the comparator */
  Ports[PortNum].CCx = cc;
  LL_UCPD_SetCCPin(Ports[PortNum].husbpd, (cc == CC1) ? LL_UCPD_CCPIN_CC1 : LL_UCPD_CCPIN_CC2);
}

/**
  * @brief  Enable RX interrupt
  * @param  PortNum Port
  * @retval None
  */
void USBPDM1_RX_EnableInterrupt(uint8_t PortNum)
{
  /* Enable the RX interrupt process */
  MODIFY_REG(Ports[PortNum].husbpd->IMR,
             UCPD_IMR_RXORDDETIE | UCPD_IMR_RXHRSTDETIE | UCPD_IMR_RXOVRIE | UCPD_IMR_RXMSGENDIE,
             UCPD_IMR_RXORDDETIE | UCPD_IMR_RXHRSTDETIE | UCPD_IMR_RXOVRIE | UCPD_IMR_RXMSGENDIE);
  LL_UCPD_RxDMAEnable(Ports[PortNum].husbpd);
}

/**
  * @brief  Enable RX
  * @param  PortNum Port
  * @retval None
  */
void USBPD_HW_IF_EnableRX(uint8_t PortNum)
{
  LL_UCPD_RxEnable(Ports[PortNum].husbpd);
}

/**
  * @brief  Disable RX
  * @param  PortNum Port
  * @retval None
  */
void USBPD_HW_IF_DisableRX(uint8_t PortNum)
{
  LL_UCPD_RxDisable(Ports[PortNum].husbpd);
}

void HW_SignalAttachement(uint8_t PortNum, CCxPin_TypeDef cc)
{
#if !defined(USBPDCORE_LIB_NO_PD)
  uint32_t _temp;

  /* Init timer to detect the reception of goodCRC */
  USBPD_TIM_Init();

  /* Prepare ucpd to handle PD message
            RX message start listen
            TX prepare the DMA to be transfer ready
            Detection listen only the line corresponding CC=Rd for SRC/SNK */
  Ports[PortNum].hdmatx = USBPD_HW_Init_DMATxInstance(PortNum);
  Ports[PortNum].hdmarx = USBPD_HW_Init_DMARxInstance(PortNum);

  /* Set the RX dma to allow reception */
  _temp = (uint32_t)&Ports[PortNum].husbpd->RXDR;
  WRITE_REG(Ports[PortNum].hdmarx->CPAR, _temp);
  WRITE_REG(Ports[PortNum].hdmarx->CMAR, (uint32_t)Ports[PortNum].ptr_RxBuff);
  Ports[PortNum].hdmarx->CNDTR = SIZE_MAX_PD_TRANSACTION_UNCHUNK;
  Ports[PortNum].hdmarx->CCR |= DMA_CCR_EN;

  /* Set the TX dma only UCPD address */
  _temp = (uint32_t)&Ports[PortNum].husbpd->TXDR;
  Ports[PortNum].hdmatx->CPAR = _temp;

  /* Disabled non Rd line set CC line enable */
#define INTERRUPT_MASK  UCPD_IMR_TXMSGDISCIE | UCPD_IMR_TXMSGSENTIE | UCPD_IMR_HRSTDISCIE  | UCPD_IMR_HRSTSENTIE |  \
  UCPD_IMR_TXMSGABTIE  | UCPD_IMR_TXUNDIE     | UCPD_IMR_RXORDDETIE  | UCPD_IMR_RXHRSTDETIE | \
  UCPD_IMR_RXOVRIE     | UCPD_IMR_RXMSGENDIE

  MODIFY_REG(Ports[PortNum].husbpd->IMR, INTERRUPT_MASK, INTERRUPT_MASK);
#endif /* !USBPDCORE_LIB_NO_PD */

  /* Handle CC enable */
  Ports[PortNum].CCx = cc;

#if !defined(USBPDCORE_LIB_NO_PD)
  /* Set CC pin for PD message */
  LL_UCPD_SetCCPin(Ports[PortNum].husbpd, (Ports[PortNum].CCx == CC1) ? LL_UCPD_CCPIN_CC1 : LL_UCPD_CCPIN_CC2);


#if defined(_VCONN_SUPPORT)
  /* Initialize Vconn management */
  (void)BSP_USBPD_PWR_VCONNInit(PortNum, (Ports[PortNum].CCx == CC1) ? 1u : 2u);
#endif /* _VCONN_SUPPORT */

  if (Ports[PortNum].settings->PE_PD3_Support.d.PE_FastRoleSwapSupport == USBPD_TRUE)
  {
    /* Set GPIO to allow the FRS TX handling */
    USBPD_HW_SetFRSSignalling(PortNum, (Ports[PortNum].CCx == CC1) ? 1u : 2u);
    /* Enable FRS RX */
    LL_UCPD_FRSDetectionEnable(Ports[PortNum].husbpd);
    Ports[PortNum].husbpd->IMR |= UCPD_IMR_FRSEVTIE;
  }

  /* Disable the Resistor on Vconn PIN */
  if (Ports[PortNum].CCx == CC1)
  {
    LL_UCPD_SetccEnable(Ports[PortNum].husbpd, LL_UCPD_CCENABLE_CC1);
  }
  else
  {
    LL_UCPD_SetccEnable(Ports[PortNum].husbpd, LL_UCPD_CCENABLE_CC2);
  }

  /* Prepare the rx processing */
  LL_UCPD_SetRxMode(Ports[PortNum].husbpd, LL_UCPD_RXMODE_NORMAL);
  LL_UCPD_RxDMAEnable(Ports[PortNum].husbpd);
  LL_UCPD_TxDMAEnable(Ports[PortNum].husbpd);
#endif /* !USBPDCORE_LIB_NO_PD */
}


void HW_SignalDetachment(uint8_t PortNum)
{
#if !defined(USBPDCORE_LIB_NO_PD)
  /* Stop DMA RX/TX */
  LL_UCPD_RxDMADisable(Ports[PortNum].husbpd);
  LL_UCPD_TxDMADisable(Ports[PortNum].husbpd);
  LL_UCPD_RxDisable(Ports[PortNum].husbpd);

#if !defined(_LOW_POWER) && !defined(USBPDM1_VCC_FEATURE_ENABLED)
  /* Enable only detection interrupt */
  WRITE_REG(Ports[PortNum].husbpd->IMR, UCPD_IMR_TYPECEVT1IE | UCPD_IMR_TYPECEVT2IE);
#elif defined(_LOW_POWER)
#if !defined(_DRP)
  if (USBPD_PORTPOWERROLE_SRC == Ports[PortNum].params->PE_PowerRole)
  {
    /* Enable detection interrupt */
    WRITE_REG(Ports[PortNum].husbpd->IMR, UCPD_IMR_TYPECEVT1IE | UCPD_IMR_TYPECEVT2IE);
  }
#endif /* !_DRP */
#endif /* !_LOW_POWER && !USBPDM1_VCC_FEATURE_ENABLED */

  USBPD_HW_DeInit_DMATxInstance(PortNum);
  USBPD_HW_DeInit_DMARxInstance(PortNum);

  LL_UCPD_SetccEnable(Ports[PortNum].husbpd, LL_UCPD_CCENABLE_CC1CC2);

  if (USBPD_PORTPOWERROLE_SNK == Ports[PortNum].params->PE_PowerRole)
  {
#if defined(_VCONN_SUPPORT)
    /* DeInitialize Vconn management */
    (void)BSP_USBPD_PWR_VCONNDeInit(PortNum, (Ports[PortNum].CCx == CC1) ? 1u : 2u);
#endif /* _VCONN_SUPPORT */
    /* DeInitialise VBUS power */
    (void)BSP_USBPD_PWR_VBUSDeInit(PortNum);
  }

  if (Ports[PortNum].settings->PE_PD3_Support.d.PE_FastRoleSwapSupport == USBPD_TRUE)
  {
    /* Set GPIO to disallow the FRS RX handling */
    LL_UCPD_FRSDetectionDisable(Ports[PortNum].husbpd);
  }

#endif /* !USBPDCORE_LIB_NO_PD */
  Ports[PortNum].CCx = CCNONE;
#if !defined(USBPDCORE_LIB_NO_PD)
  /* DeInit timer to detect the reception of goodCRC */
  USBPD_TIM_DeInit();
#endif /* !USBPDCORE_LIB_NO_PD */
}

/**
  * @brief  Set resistors to SinkTxNG
  * @param  PortNum Port
  * @retval None
  */
void USBPD_HW_IF_SetResistor_SinkTxNG(uint8_t PortNum)
{
  /* Set the resistor SinkTxNG 1.5A5V */
  LL_UCPD_SetRpResistor(Ports[PortNum].husbpd, LL_UCPD_RESISTOR_1_5A);
}

/**
  * @brief  Set resistors to SinkTxOk
  * @param  PortNum Port
  * @retval None
  */
void USBPD_HW_IF_SetResistor_SinkTxOK(uint8_t PortNum)
{
  /* Set the resistor SinkTxNG 3.0A5V */
  LL_UCPD_SetRpResistor(Ports[PortNum].husbpd, LL_UCPD_RESISTOR_3_0A);
}

/**
  * @brief  Check if resistors are set to SinkTxOk
  * @param  PortNum Port
  * @retval USBPD_TRUE if resistor is set to SinkTxOk, else USBPD_FALSE
  */
uint8_t USBPD_HW_IF_IsResistor_SinkTxOk(uint8_t PortNum)
{
#if IH01A_PD_FORCE_SINK_TXOK
  /* IH01A: this board presents an external Rd and the UCPD CC detector does
   * not report the Rp-3.0 A vstate the stock test looks for, so the predicate
   * stays FALSE. ST's policy engine gates every DPM-initiated transmission
   * (Get_Source_Capability, EPR_Mode, re-Request) on this check and therefore
   * accepts the request and never transmits it, which is exactly what the
   * bench shows. Reactive messages (GoodCRC, Request inside the response
   * window) are unaffected, so SPR keeps working.
   * Returning TRUE keeps the original behaviour available through the macro. */
  extern void PD_SinkTxOkProbe(uint32_t ccx, uint32_t vstate);
  PD_SinkTxOkProbe((uint32_t)Ports[PortNum].CCx,
                   (uint32_t)(Ports[PortNum].husbpd->SR & UCPD_SR_TYPEC_VSTATE_CC1));
  (void)PortNum;
  return USBPD_TRUE;
#else
#if defined(_LOW_POWER)
  /* When in low power mode, the type C state machine is turned off.
     To retrieve any potential updates of the SR register, the state machine needs to be re-enabled briefly. */

  /* Enable type C state machine */
  CLEAR_BIT(Ports[PortNum].husbpd->CR, (UCPD_CR_CC1TCDIS | UCPD_CR_CC2TCDIS));

  /* Let time for internal state machine to refresh his state */
  for (uint32_t index = 0; index < CAD_DELAY_READ_CC_STATUS; index++)
  {
    __DSB();
  }

  /* Disable type C state machine */
  SET_BIT(Ports[PortNum].husbpd->CR, (UCPD_CR_CC1TCDIS | UCPD_CR_CC2TCDIS));
#endif /* _LOW_POWER */

  switch (Ports[PortNum].CCx)
  {
    case CC1 :
      if ((Ports[PortNum].husbpd->SR & UCPD_SR_TYPEC_VSTATE_CC1) == LL_UCPD_SNK_CC1_VRP30A)
      {
        return USBPD_TRUE;
      }
      break;
    case CC2 :
      if ((Ports[PortNum].husbpd->SR & UCPD_SR_TYPEC_VSTATE_CC2) == LL_UCPD_SNK_CC2_VRP30A)
      {
        return USBPD_TRUE;
      }
      break;
    default:
      break;
  }

  return USBPD_FALSE;
#endif /* IH01A_PD_FORCE_SINK_TXOK */
}

/**
  * @brief  Signal a Fast Role Swap
  * @param  PortNum Port
  * @retval None
  */
void USBPD_HW_IF_FastRoleSwapSignalling(uint8_t PortNum)
{
  LL_UCPD_SignalFRSTX(Ports[PortNum].husbpd);
}
