TKWTL/IH01A-Compact_Induction_Heater/Firmware/APP/algorithm/pd_epr_policy.h

#ifndef IH01A_PD_EPR_POLICY_H
#define IH01A_PD_EPR_POLICY_H
/* IMPORTANT: Enable ONLY after verifying complete 28V/5A input path,
 * independent OVP and a certified 240W EPR e-marked cable.
 * Setting this to 1 authorizes an actual 28V request; leave OFF until then.
 */
/* The hardware owner approved the 28V input path on 2026-11-02.
 * At boot: negotiate the highest legal SPR Fixed contract first, then enter
 * EPR once per attach if Source/cable eligibility permits. This power policy
 * NEVER starts the heater; power-stage safeguards remain independent.
 */
#define IH01A_EPR_28V5A_HARDWARE_APPROVED 1
/* Auto-enter EPR after an explicit SPR contract when Source and cable permit.
 * On unavailable/rejected EPR, retain the highest legal SPR Fixed contract
 * (typically <=20V). 'pd auto' may disable it for diagnostics. */
#define IH01A_EPR_28V5A_AUTO_ENTER 1
#define IH01A_PD_DEFAULT_FIXED_MAX_V 28u

/* 2026-11-02 analyzer: ST FULL v5.4.1 sends EPR KeepAlive at 500 ms.
 * A foreground AMS registered with USBPD_PE_Send_ExtendeControlMessage()
 * was accepted/rejected but did not add a frame on CC. Keep the stable
 * library-managed cadence. Set to 1 ONLY for a bounded diagnostic probe;
 * it never provides a production 375 ms KeepAlive pacer. */
#define IH01A_EPR_APP_KEEPALIVE_PROBE 0

/* EPR policy numbers. The three values must stay consistent: the Sink
 * advertises PDP = 28V x current and asks for exactly that current, so a
 * 84W PDP together with a 5A Sink PDO / 5A request would be a spec
 * mismatch that a Source is entitled to reject.
 *
 *   28 V x 5 A = 140 W  (current branch policy, 240W e-marked cable)
 *   28 V x 3 A =  84 W  (fallback policy if the cable/input path cannot
 *                        be certified for 5 A: also set the Sink PDO
 *                        current and the 28V/5A acceptance in pd_input.c)
 */
#define IH01A_EPR_SINK_PDP_W       140u
#define IH01A_EPR_SINK_CURRENT_MA  5000u

/* SPR hardware current ceiling. The request follows the Source Fixed PDO
 * up to 7 A; a 20V/7A capability is handled like any other Fixed object,
 * with no special identification or extra application approval steps. */
/* Board power path reviewed for 7 A SPR use. Source Fixed PDO provides the
 * offered current limit (including SW3538's 20V/7A non-standard PDO).
 * Clamp at the hardware ceiling; there is NO hardcoded 20V/7A profile and
 * no additional cable-confirmation application step. */
#define IH01A_PD_SPR_MAX_MA        7000u

/* USBPD_PE_Request_EPRModeEnter() only registers a generic machine and wakes
 * the PE (see its disassembly: it validates the last Request header, writes
 * 0xA8 into the PE "machine state" byte and calls the wake-up callback).
 * The machine itself is only executed from the PE_STATE_GENERIC branch of
 * USBPD_PE_StateMachine_SNK, so a request posted while the sink sits idle in
 * PE_SNK_Ready can stay pending for ever (second call then returns BUSY).
 * With this switch the app tries two fallbacks once the request has been
 * pending for 1 s:
 *   A) USBPD_PE_Request_DataMessage(USBPD_DATAMSG_EPR_MODE) directly;
 *   B) re-issue the current SPR Request so the PE processes a Request
 *      context, then register EPR entry from the POWER_EXPLICIT_CONTRACT
 *      notification (i.e. from PE callback context).
 */
#define IH01A_EPR_STALL_FALLBACK   1

/* Register the EPR entry only from PE callback context: re-issue the current
 * SPR Request first, then call USBPD_PE_Request_EPRModeEnter() from the
 * POWER_EXPLICIT_CONTRACT notification. Calling it from the idle main loop
 * leaves the library's EPR machine pending for ever (bench-proved: BUSY on
 * every later request, no PD_TX at all). */
#define IH01A_EPR_REENTER_ON_CONTRACT 1

/* ST's PE gates every DPM-initiated transmission on USBPD_PE_...SinkTxOK,
 * which is derived from the UCPD CC vstate (Rp 3.0 A). This board presents an
 * external Rd, so that predicate reads FALSE and every app-driven message
 * (Get_Source_Capability, EPR_Mode, re-Request) is accepted and then silently
 * dropped, while reactive messages still work (SPR is fine). Force the
 * predicate TRUE so the PE actually transmits. */
#define IH01A_PD_FORCE_SINK_TXOK   1

/* The verified CH32X035 sink delays EPR_Get_Source_Cap by 120 ms after
 * EPRMODE_SUCCEEDED; their notes record that sending it immediately caused
 * 'Enter Succeeded followed by Source Hard Reset'. ST's PE sends it after
 * 7 ms, so decline that early capability set and fetch it ourselves later. */
#define IH01A_EPR_DELAY_GETCAP     0
#define IH01A_EPR_GETCAP_DELAY_MS  120u

/* Requested current for the EPR contract. The source hard-resets our EPR_Request
 * even with a bit-exact RDO/CopyPDO, so 5 A is the next suspect: a Source that
 * cannot grant 5 A (cable e-marker rating) may answer with a Hard Reset. Drop to
 * 3 A to find out whether current is the discriminator. */
#define IH01A_EPR_REQUEST_MA       5000u

/* Object position convention proven on the bench with this source: the EPR
 * request must use the ABSOLUTE position (8..13, continuing the SPR list).
 * The 1-based index inside EPR_Source_Capabilities (1..6) is rejected with a
 * Hard Reset. 'pd epr1' still selects the local convention for experiments. */
#define IH01A_EPR_OPOS_ABSOLUTE_DEFAULT 1

/* Explicit EPR_Mode Exit (USBPD_PE_Request_EPRModeExit). OFF by default.
 * Bench (Lenovo C140, 28 V/5 A -> 'pd off'): the EPR_Mode Action=Exit message
 * reached the wire and was GoodCRC'd, then the whole cooperative superloop
 * stopped - no further diary line, no capability answer to the source's ~20
 * Source_Capabilities retransmissions, OLED frozen at its last frame, no
 * reboot. The PE API registers an AMS machine that wants to be completed from
 * the same loop that called it, so it must not be used from the idle main
 * loop (same failure class as calling EPRModeEnter from there).
 * With 0, 'pd off' from an EPR contract instead refreshes the SPR capability
 * set and requests the highest legal Fixed SPR PDO through the proven
 * Evaluate -> Request -> PS_RDY pipeline (implicit EPR exit). */
#define IH01A_EPR_EXIT_API_FALLBACK 0
#endif
