TKWTL/IH01A-Compact_Induction_Heater/Firmware/APP/PowerControl/conv_pwm.c

#include "conv_pwm.h"
#include <math.h>
#include <armdsp.h>

#define HRTIM_CMP_FLOOR_LIMIT   0x30U                                           //根据手册RM0440来确定指定倍频/分频数下的值

void Timer_Init(ui_t *ui){
    SetFrequency(ui);

    LL_HRTIM_TIM_SetCompare1(HRTIM1, LL_HRTIM_TIMER_MASTER, INITIAL_HRTIM_PERIOD/2);
    LL_HRTIM_TIM_SetCompare2(HRTIM1, LL_HRTIM_TIMER_MASTER, INITIAL_HRTIM_PERIOD/2);

    // ADC 采样延迟配置：使采样时刻精确配合三角波中点，需实测
    // Master CMP1 → 复位同步 ABC 从定时器
    LL_HRTIM_TIM_SetCompare4(HRTIM1, LL_HRTIM_TIMER_A, 3000);//A CMP4→ADC4: IA/VBC/VZS
    LL_HRTIM_TIM_SetCompare3(HRTIM1, LL_HRTIM_TIMER_B, 2000);//B CMP3→ADC3: IB/VAB
    LL_HRTIM_TIM_SetCompare4(HRTIM1, LL_HRTIM_TIMER_C, 3000);//C CMP4→ADC2: IC/VCM
    LL_HRTIM_TIM_SetCompare3(HRTIM1, LL_HRTIM_TIMER_D, 3000);//D CMP3→ADC1(触发MainLoop)
    LL_HRTIM_TIM_SetCompare3(HRTIM1, LL_HRTIM_TIMER_E, INITIAL_HRTIM_PERIOD - 3000);//E CMP3→ADC1(与D共同触发MainLoop)

	LL_HRTIM_TIM_CounterEnable(HRTIM1,  LL_HRTIM_TIMER_MASTER|
                                        LL_HRTIM_TIMER_A|
                                        LL_HRTIM_TIMER_B|
                                        LL_HRTIM_TIMER_C|
                                        LL_HRTIM_TIMER_D|
                                        LL_HRTIM_TIMER_E
    );
    // MainLoop 由 ADC1 EOS 中断触发，不需要 HRTIM 中断
}

//重装载值96~65503
//比较值0~65503
RAMVAR uint32_t g_Timer_Period;//周期值（未减去1）
RAMVAR uint32_t g_Timer_CompareMax;//比较器限幅值，由HRTIM的缺陷而产生

int SwitchingFrequency = DEFAULT_FSW_KHZ;

//设置开关频率，只保证两个很近频率间切换的稳定性
void SetFrequency(ui_t *ui){
    g_Timer_Period = 120000UL* 8UL/ SwitchingFrequency;
    if(g_Timer_Period > 65536U- HRTIM_CMP_FLOOR_LIMIT) g_Timer_Period = 65536U- HRTIM_CMP_FLOOR_LIMIT;
    else if(g_Timer_Period < HRTIM_CMP_FLOOR_LIMIT) g_Timer_Period = HRTIM_CMP_FLOOR_LIMIT;
    //更改重装载值
    LL_HRTIM_TIM_SetPeriod(HRTIM1, LL_HRTIM_TIMER_A, g_Timer_Period);
    LL_HRTIM_TIM_SetPeriod(HRTIM1, LL_HRTIM_TIMER_B, g_Timer_Period);
    LL_HRTIM_TIM_SetPeriod(HRTIM1, LL_HRTIM_TIMER_C, g_Timer_Period);
    LL_HRTIM_TIM_SetPeriod(HRTIM1, LL_HRTIM_TIMER_D, g_Timer_Period);
    LL_HRTIM_TIM_SetPeriod(HRTIM1, LL_HRTIM_TIMER_E, g_Timer_Period);
    //更改同步触发
    LL_HRTIM_TIM_SetPeriod(HRTIM1, LL_HRTIM_TIMER_MASTER, g_Timer_Period);
    LL_HRTIM_TIM_SetCompare1(HRTIM1, LL_HRTIM_TIMER_MASTER, g_Timer_Period / 2);//Master CMP1 复位同步 ABC（三相逆变载波同步）
    LL_HRTIM_TIM_SetCompare2(HRTIM1, LL_HRTIM_TIMER_MASTER, g_Timer_Period / 2);//Master CMP2 复位同步 DE（全桥PFC单极性倍频载波同步）
    //更改比较器限幅值
    g_Timer_CompareMax = g_Timer_Period - HRTIM_CMP_FLOOR_LIMIT;
}

//设置全桥占空比（Timer D+E），单极性倍频调制
// 输入 Dr = D_eff ∈ [-0.5, 0.5]，返回 1=钳位(二极管续流) 0=正常
inline int SetDuty_Rec(float Dr){
    uint32_t compare_a, compare_max = g_Timer_CompareMax;
    float Period = g_Timer_Period;
    float Da = 0.5f + Dr;
    
    compare_a = (uint32_t)(Period * Da);
    
    // 占空比饱和 → 关闭输出，二极管续流
    if(compare_a < HRTIM_CMP_FLOOR_LIMIT || Da < 0.0f ||
        compare_a > compare_max) {
        LL_HRTIM_DisableOutput(HRTIM1, LL_HRTIM_OUTPUT_TD1 | LL_HRTIM_OUTPUT_TD2 |
                                        LL_HRTIM_OUTPUT_TE1 | LL_HRTIM_OUTPUT_TE2);
        return 1;  // diode_clamp
    }
    
    uint32_t compare_b = g_Timer_Period - compare_a;
    LL_HRTIM_TIM_SetCompare1(HRTIM1, LL_HRTIM_TIMER_D, compare_a);
    LL_HRTIM_TIM_SetCompare1(HRTIM1, LL_HRTIM_TIMER_E, compare_b);
    return 0;
}
//设置三相逆变占空比（Timer A/B/C）
inline void SetDuty_Inv(float Du, float Dv, float Dw){
    uint32_t compare_u, compare_v, compare_w, compare_max = g_Timer_CompareMax;
    float Period = g_Timer_Period;
    
    compare_u = (uint32_t)(Period* Du);
    compare_v = (uint32_t)(Period* Dv);
    compare_w = (uint32_t)(Period* Dw);
    //由于HRTIM的缺陷，需要进行限幅
    if(compare_u < HRTIM_CMP_FLOOR_LIMIT || Du < 0) compare_u = 0;
    else if(compare_u > compare_max) compare_u = g_Timer_Period+ 1;
    if(compare_v < HRTIM_CMP_FLOOR_LIMIT || Dv < 0) compare_v = 0;
    else if(compare_v > compare_max) compare_v = g_Timer_Period+ 1;
    if(compare_w < HRTIM_CMP_FLOOR_LIMIT || Dw < 0) compare_w = 0;
    else if(compare_w > compare_max) compare_w = g_Timer_Period+ 1;
    //更改比较值	
    LL_HRTIM_TIM_SetCompare1(HRTIM1, LL_HRTIM_TIMER_A, compare_u);
    LL_HRTIM_TIM_SetCompare1(HRTIM1, LL_HRTIM_TIMER_B, compare_v);
    LL_HRTIM_TIM_SetCompare1(HRTIM1, LL_HRTIM_TIMER_C, compare_w);
}


//打开全桥 PFC PWM（Timer D/E）
inline void PWM_Start_Rec(void){
    LL_HRTIM_EnableOutput(HRTIM1, LL_HRTIM_OUTPUT_TD1 | LL_HRTIM_OUTPUT_TD2 |
                                  LL_HRTIM_OUTPUT_TE1 | LL_HRTIM_OUTPUT_TE2);
}
//打开三相逆变 PWM（Timer A/B/C）
inline void PWM_Start_Inv(void){
    LL_HRTIM_EnableOutput(HRTIM1, LL_HRTIM_OUTPUT_TA1 | LL_HRTIM_OUTPUT_TA2 |
                                  LL_HRTIM_OUTPUT_TB1 | LL_HRTIM_OUTPUT_TB2 |
                                  LL_HRTIM_OUTPUT_TC1 | LL_HRTIM_OUTPUT_TC2);
}
//关闭PWM
inline void PWM_Stop(void){
    LL_HRTIM_DisableOutput(HRTIM1, LL_HRTIM_OUTPUT_TA1 | LL_HRTIM_OUTPUT_TA2 |
                                   LL_HRTIM_OUTPUT_TB1 | LL_HRTIM_OUTPUT_TB2 |
                                   LL_HRTIM_OUTPUT_TC1 | LL_HRTIM_OUTPUT_TC2 |
                                   LL_HRTIM_OUTPUT_TD1 | LL_HRTIM_OUTPUT_TD2 |
                                   LL_HRTIM_OUTPUT_TE1 | LL_HRTIM_OUTPUT_TE2 |
                                   LL_HRTIM_OUTPUT_TF1 | LL_HRTIM_OUTPUT_TF2);
}
    
/***********************以下函数须在ui_conf.c中调用****************************/
ui_item_t Frequency_Item;
//创建PWM设置模块所需的参数
void Create_PWM_Parameters(ui_t *ui){
    static ui_data_t Frequency_data;
    Frequency_data.name = "Switch Frequency";
    Frequency_data.ptr = &SwitchingFrequency;
    Frequency_data.function = SetFrequency;
    Frequency_data.functionType = UI_DATA_FUNCTION_STEP_EXECUTE;
    Frequency_data.dataType = UI_DATA_INT;
    Frequency_data.actionType = UI_DATA_ACTION_RW;
    Frequency_data.max = 150;
    Frequency_data.min = 20;
    Frequency_data.step = 5;
    static ui_element_t Frequency_element;
    Frequency_element.data = &Frequency_data;
    Create_element(&Frequency_Item, &Frequency_element);
}
//将PWM设置模块的对象添加到菜单中
void Add_PWM_Items(ui_page_t *ParentPage){
    AddItem(" Switch Frequency", UI_ITEM_DATA, NULL, &Frequency_Item, ParentPage, NULL, NULL);
}
