TKWTL/IH01A-Compact_Induction_Heater/Firmware/APP/PowerControl/conv_phase.h

#ifndef IH01A_CONV_PHASE_H
#define IH01A_CONV_PHASE_H
#include <stdint.h>
/* Manual bench range; low-end 150kHz is near the unloaded tank resonance.
 * This is NOT a safety/ZVS permission by itself. TIM1 kernel clock must
 * remain 128MHz with PSC=0; 1kHz commands round to the nearest ARR tick.
 * Settings continues using 10kHz increments. */
#define CONV_TIM1_CLOCK_KHZ 128000u
#define CONV_FREQ_MIN_KHZ 150u
#define CONV_FREQ_MAX_KHZ 400u
#define CONV_FREQ_STEP_KHZ 10u
/* Pure mapping from user phase angle to TIM1 up-counting PWM registers.
 * CH1 PWM1: CCR1=ARR/2. CH3 Combined PWM2 AND CH4 PWM1:
 * logical CH3 pulse lies between CCR3=D and CCR4=D+ARR/2.
 * PA8(CH1) / PA10(CH3) are the two bridge-leg logic waveforms.
 * Current power-stage gate PC6 is NEVER manipulated by this math.
 */
typedef struct {
    uint16_t arr,ccr1,ccr3,ccr4;
    uint16_t angle_deg;
} ConvPhaseConfig;
/* 0<=angle<=180; clamps larger requests. Returns 0 only if invalid ARR. */
uint8_t ConvPhase_Calculate(uint16_t arr,uint16_t angle_deg,
                             ConvPhaseConfig *out);
/* Division-free exact fast path for ISR automatic ARR=426..752. */
uint8_t ConvPhase_CalculateAuto(uint16_t arr,uint16_t angle_deg,
                                ConvPhaseConfig *out);
uint8_t ConvPhase_ArrFromKHz(uint16_t requested_khz,uint16_t *arr);
uint16_t ConvPhase_KHzFromArr(uint16_t arr);
#endif
