TKWTL/IH01A-Compact_Induction_Heater/Firmware/Tests/host/test_heater_cli_commands.c

#include <assert.h>
#include <stdarg.h>
#include <stdio.h>
#include <string.h>
#include "heater_cli.h"
#include "heater_cli_mock.h"

static char s_reply[256];
static uint32_t s_now=1000u;
static uint16_t s_phase=90u;
static HeaterSnapshot s_heater;
static ConvADC_Snapshot s_adc;
static ConvProtectionSnapshot s_protection;
static ConvZcdSnapshot s_zcd;
static ConvAutoFreqSnapshot s_af;
static ConvState s_state=CONV_STATE_ADC_MONITOR;
static uint8_t s_enabled,s_on_allowed,s_block;
static uint8_t s_pan_step;
static uint32_t s_pan_seq;
static HeaterCliMockTim s_timer={639u};
HeaterCliMockTim *TIM1=&s_timer;

int HeaterCLI_MockPrintf(const char *fmt,...)
{
    va_list ap;
    int size;
    va_start(ap,fmt);
    size=vsnprintf(s_reply,sizeof(s_reply),fmt,ap);
    va_end(ap);
    return size;
}
uint32_t HAL_GetTick(void){return s_now;}
void pm_api_refresh_idle(void){}
void Heater_GetSnapshot(HeaterSnapshot *out){*out=s_heater;}
void Heater_SetPhaseDegrees(uint16_t value)
{
    s_heater.target_phase_deg=value;
}
void Heater_Stop(void)
{
    s_heater.state=HEATER_OFF;
}
void ConvADC_CopySnapshot(ConvADC_Snapshot *out){*out=s_adc;}
void ConvProtection_GetSnapshot(ConvProtectionSnapshot *out){*out=s_protection;}
void ConvZcd_Poll(uint32_t now){(void)now;}
void ConvZcd_GetSnapshot(ConvZcdSnapshot *out){*out=s_zcd;}
void ConvAutoFreq_GetSnapshot(ConvAutoFreqSnapshot *out){*out=s_af;}
const char *ConvAutoFreq_StateName(ConvAutoFreqState state)
{
    return state==CONV_AF_TRACK?"TRACK":
           state==CONV_AF_SAFE?"SAFE":"OFF";
}
uint8_t ConvAutoFreq_Enabled(void){return s_af.enabled;}
uint8_t ConvAutoFreq_SetEnabled(uint8_t enabled)
{
    s_af.enabled=(uint8_t)(enabled!=0u);
    s_af.state=s_af.enabled?CONV_AF_SAFE:CONV_AF_OFF;
    if(s_af.enabled)TIM1->ARR=CONV_AF_START_ARR;
    return 1u;
}
ConvZcdCalStatus ConvZcd_CorrectionStatus(const ConvZcdSnapshot *v,
                                           uint32_t ct_ma,uint8_t valid)
{
    if(!v || !v->valid)return CONV_ZCD_CAL_NO_CAPTURE;
    if(!v->correction_valid)return CONV_ZCD_CAL_FREQ_RANGE;
    if(v->phase_deg<120u || v->phase_deg>180u)
        return CONV_ZCD_CAL_PHASE_RANGE;
    if(!valid)return CONV_ZCD_CAL_ADC_INVALID;
    if(ct_ma<50u)return CONV_ZCD_CAL_LOW_CURRENT;
    return CONV_ZCD_CAL_RECAL_REQUIRED; /* revised CT not yet refitted */
}
uint8_t ConvController_OutputEnabled(void){return s_enabled;}
uint8_t ConvController_PanProbeState(void){return s_pan_step;}
uint32_t ConvController_PanProbeSequence(void){return s_pan_seq;}
uint8_t ConvController_OutputPinLevel(void){return s_enabled;}
uint16_t ConvController_GetPhaseDegrees(void){return s_phase;}
uint16_t ConvController_GetFrequencyKhz(void)
{
    return ConvPhase_KHzFromArr((uint16_t)TIM1->ARR);
}
void ConvController_SetPhaseDegrees(uint16_t value)
{
    s_phase=value;
}
uint8_t ConvController_SetFrequencyKhz(uint16_t khz)
{
    uint16_t arr;
    if(!ConvPhase_ArrFromKHz(khz,&arr))return 0u;
    TIM1->ARR=arr;
    return 1u;
}
uint8_t ConvController_RequestBenchRunNow(uint32_t now)
{
    (void)now;
    s_enabled=s_on_allowed;
    s_block=s_on_allowed?CONV_BENCH_OK:
            s_heater.pan_detect_enabled?CONV_BENCH_COUNTDOWN:
            CONV_BENCH_NOPD;
    if(s_enabled)s_heater.state=HEATER_RUN_REQUESTED;
    return s_enabled;
}
void ConvController_BenchPowerOff(void)
{
    s_enabled=0u;
}
uint8_t ConvController_BenchBlockReason(void){return s_block;}
ConvState ConvController_GetState(void){return s_state;}

static void send(const char *cmd,const char *expected)
{
    s_reply[0]='\0';
    assert(HeaterCLI_Dispatch(cmd)==1u);
    assert(strcmp(s_reply,expected)==0);
}

int main(void)
{
    s_heater.state=HEATER_OFF;
    s_heater.target_phase_deg=90u;
    s_protection.zero_status=CONV_ZERO_WAIT;
    s_adc.frames=0u;
    s_on_allowed=0u;
    assert(HeaterCLI_Dispatch("ping")==0u);
    send("heater phase 180","HCLI OK PHASE_DEG=180\r\n");
    send("heater phase 181","HCLI ERR RANGE\r\n");
    send("heater auto on","HCLI ERR CT_ZCD_RECAL_REQUIRED\r\n");
    send("heater auto off","HCLI OK AUTO_FREQ=OFF\r\n");
    send("heater freq 150","HCLI OK FREQ_KHZ=150\r\n");
    send("heater freq 400","HCLI OK FREQ_KHZ=400\r\n");
    send("heater freq 149","HCLI ERR RANGE\r\n");
    send("heater freq xyz","HCLI ERR SYNTAX\r\n");
    s_af.enabled=1u; /* simulate auto mode: manual tuning is prohibited */
    send("heater freq 200","HCLI ERR AUTO_FREQ_ENABLED\r\n");
    s_af.enabled=0u;
    send("heater auto 1","HCLI ERR SYNTAX\r\n");
    send("heater on","HCLI ERR HEATER_BLOCK=NO_PD\r\n");
    s_heater.pan_detect_enabled=1u; /* verify the previously hidden reason */
    send("heater on","HCLI ERR HEATER_BLOCK=COUNTDOWN\r\n");
    s_heater.pan_detect_enabled=0u;

    s_now=1100u;
    s_on_allowed=1u;
    send("heater on","HCLI OK HEATER=ON\r\n");
    send("heater freq 200","HCLI OK FREQ_KHZ=200\r\n");
    assert(TIM1->ARR==639u);
    s_af.state=CONV_AF_OFF;
    s_af.ibus_delta_raw=0u;
    s_zcd.valid=1u;
    s_zcd.last_ms=1090u;
    s_zcd.capture_raw=444u;
    s_zcd.lag_deci_deg=1149; /* raw */
    s_zcd.lag_corr_deci_deg=950; /* 95.0deg host-injected correction */
    s_zcd.correction_valid=1u;
    s_zcd.phase_deg=180u;
    s_adc.frames=1u;
    s_adc.raw[CONV_ADC_CT_RMS]=1389u;
    s_adc.filtered[CONV_ADC_CT_RMS]=1389u;
    s_protection.zero_status=CONV_ZERO_READY;
    s_protection.ct_zero_raw=1100u;
    s_reply[0]='\0';
    assert(HeaterCLI_Dispatch("heater get"));
    assert(strstr(s_reply,"HCLI OK HEATER=ON PHASE_DEG=180 FREQ_KHZ=200 FREQ_HZ=200000 ")==s_reply);
    assert(strstr(s_reply," AUTO_FREQ=OFF AF_STATE=OFF IBUS_DELTA=0 PAN=OFF OFF_MIN=0 LEFT_S=0 PAN_STEP=IDLE PAN_SEQ=0\r\n")!=0);
    assert(strstr(s_reply,"IC2=444 LAG_DEG=NA LAG_RAW_DEG=+114.9 LAG_QUAL=RECAL CT_RMS_A=0.932")!=0);
    s_zcd.last_ms=0u;
    s_reply[0]='\0';
    assert(HeaterCLI_Dispatch("heater get"));
    assert(strstr(s_reply,"IC2=NA LAG_DEG=NA LAG_RAW_DEG=NA LAG_QUAL=NO_IC2")!=0);
    s_adc.raw[CONV_ADC_CT_RMS]=4095u;
    s_zcd.last_ms=1090u; /* valid capture, but CT ADC is saturated */
    s_reply[0]='\0';
    assert(HeaterCLI_Dispatch("heater get"));
    assert(strstr(s_reply,"LAG_QUAL=ADC")!=0);
    assert(strstr(s_reply,"LAG_DEG=NA LAG_RAW_DEG=+114.9") != 0);
    assert(strstr(s_reply,"CT_RMS_A=SAT")!=0);
    /* With a valid capture, low CT level suppresses correction only.
     * Raw capture and raw phase must remain observable to the agent. */
    s_adc.raw[CONV_ADC_CT_RMS]=1110u;
    s_adc.filtered[CONV_ADC_CT_RMS]=1110u;
    s_reply[0]='\0';
    assert(HeaterCLI_Dispatch("heater get"));
    assert(strstr(s_reply,"LAG_DEG=NA LAG_RAW_DEG=+114.9 LAG_QUAL=LOW_CT")!=0);
    s_adc.raw[CONV_ADC_CT_RMS]=1389u;
    s_adc.filtered[CONV_ADC_CT_RMS]=1389u;
    s_zcd.correction_valid=0u; /* outside calibrated frequency band */
    s_reply[0]='\0';
    assert(HeaterCLI_Dispatch("heater get"));
    assert(strstr(s_reply,"LAG_QUAL=FREQ")!=0);
    send("heater off","HCLI OK HEATER=OFF\r\n");
    s_heater.pan_detect_enabled=1u;
    s_heater.off_minutes=5u;
    s_heater.off_remaining_s=280u;
    s_pan_step=2u;s_pan_seq=3u;
    s_enabled=0u;
    s_reply[0]='\0';
    assert(HeaterCLI_Dispatch("heater get"));
    assert(strstr(s_reply,
        " PAN=ON OFF_MIN=5 LEFT_S=280 PAN_STEP=ACTIVE PAN_SEQ=3\r\n")!=0);
    send("heater on","HCLI OK HEATER=PAN_REQUESTED\r\n");
    puts("heater CLI command: PASS");
    return 0;
}
