TKWTL/IH01A-Compact_Induction_Heater/(commit log)

2026-10-31 CubeMX update: ADC1 rank remap, add TIM14, drop TIM15 DMA
    - ADC1: regular ranks -> CH11/5/1/10/2/4/0, rank7 sampling time -> COMMON_1
    - DMA: remove TIM15_CH1 request (RequestsNb 7 -> 6)
    - main: add MX_TIM14_Init()
    - regenerate Core/Inc + Core/Src, refresh .ioc
    - Keil: re-saved uvprojx/uvoptx (empty per-file control blocks normalized)
    - remove Firmware/Project/{Core,Debug,obj}/.gitkeep placeholders
2026-10-31 feat(ih01a): basic coroOS MiaoUI SSD1315 framework and four-item menu
    Port PB02B/DPC27A UI_OFF PM, Q10 MiaoUI/u8g2 and cooperative scheduler to STM32G071. SSD1315 uses SPI, external VCC and disabled internal charge pump. Assume RES# shared with MCU PF2/NRST (reset input/output mode). Four top-level items: Main, Settings, Data, About; no heater control. Keil and board validation still pending.
    [app_tasks.c, buttons.c, buttons.h]
2026-10-31 fix(ih01a): omit unlinked u8g2 capture exporters and relocate coroOS
    Guard optional PBM/XBM buffer export functions and declarations behind
    U8G2_ENABLE_BUFFER_CAPTURE, keeping the SSD1315 rendering subset free of
    unlinked u8x8_capture_* references. Move coroOS.c/.h unchanged to
    Firmware/MDK-ARM/Scheduler and update the Keil project include/source paths.
    Document build issue and pending full Keil re-link verification.
2026-10-31 chore(ignore): untrack Keil build outputs and local state
    规则提取自 PB02B-Pocket_PowerBank 的 Keil Clean 段,去掉其中工程私有项(hardware/ docs/ Templates/ 等):
    - 构建产物: *.axf *.htm *.lnp *.dep *.crf *.iex *.scvd *.bak *.ini *.dbg* 及输出目录 /Firmware/MDK-ARM/Compact_Induction_Heater/
    - 随机器变化的本地状态: *.uvguix *.uvguix.* *.mxproject *.code-workspace
    - 补 !*.uvprojx !*.uvoptx !*.ioc !*.sct !*.c !*.h !*.s 防误伤
    - 删除指向已移除 Firmware/Project 的死规则
    取消跟踪 10 个文件(仅从索引移除,磁盘文件保留):
    .mxproject、uvguix、axf/htm/build_log.htm/lnp/dep、DebugConfig 与 RTE 下的 dbgconf
2026-10-31 fix(ih01a): retarget Armclang runtime away from semihosting and isolate PM Keil group
    Prevent ARM C runtime BKPT 0xAB by providing no-argv/no-semihosting markers, nonblocking debugger-readable tty output and safe fatal exit trap. Move seven PM sources to a dedicated IH01A/APP/framework Keil group without moving physical paths; document new debugging checks.
    [retarget.c]
2026-10-31 feat(ih01a): port PB02B mini_format printf and enable u8g2 Unicode BMP
    Copy PB02B integer formatter unmodified to BSP/Console; add printf/snprintf family adapters to the nonblocking RAM diagnostic ring; enable u8g2 BMP glyph lookup and route MiaoUI strings through UTF-8. Register sources in Keil, add host formatting tests and explain local CubeMX heap 0x1000 recommendation without editing .ioc.
2026-10-31 fix(ih01a): avoid ArmClang putchar macro expansion in mini_stdio
    Undefine stdio.h's putchar macro before providing the retarget function, add putc as an alias to the same RAM diagnostics sink for macro-based callers, and remove a null check on puts's nonnull argument.
    [mini_stdio.c]
2026-10-31 fix(ih01a): run coroOS from USBPD user callback in non-RTOS PD main loop
    ST USBPD_DPM_Run never returns in the no-RTOS configuration, so main's APP_Tasks_RunOnce was unreachable. Hook coroOS into CubeMX-preserved USBPD_DPM_UserExecute after each CAD/PE pass instead of changing the PD core; add Keil Watch probes for PD callbacks, scheduler steps, OLED init and UI frames. Document timing and bring-up checks.
    [app_tasks.c, main.c]
2026-10-31 chore(ih01a): remove temporary PD/UI debug probes and record bring-up baseline
    Drop temporary scheduling/watch counters while preserving CubeMX USB-PD user hook, coroOS, display/PM logic and printf runtime diagnostics. Document user-confirmed OLED/button/UI_OFF validation, keep user-corrected U8G2_R2 and 0x400 heap/stack unchanged, and add a prioritized next-stage plan covering resource/PD timing, measurements, hardware protection, heating state machine and i18n.
    [app_tasks.c]
2026-10-31 feat(ih01a): use SPI1 DMA for OLED runtime refresh and add display burn-in test
    Replace blocking OLED page/command transfer with cooperative DMA completion state machine, while keeping u8g2 init synchronous. Adapt DPC27A burn-in page to Settings/Display before Screen Flip with any-key exit. Double button debounce/typematic timing, fix long-hold counter rollover and map L/UP to decrement MiaoUI parameters. Document verification requirements and protect current orientation/heap settings.
    [buttons.c, ssd1315_display.c]
2026-11-01 feat(ih01a-ui): split Settings into Display/System, restore img_statistics
    - image: drop the three img_type_* port labels, keep img_statistics (30x30 XBM from Collar Radio pack, 120B)
    - ui: Settings -> -Display (contrast/background/burn-in/flip) + -System (sleep options)
    - ui: -Statistics keeps its PD in / System placeholder sub-pages
    - editorconfig: 4-space indent, Keil project files left as tab/8
    [ui_conf.c]
2026-11-01 chore(port): import PowerControl core from NUEDC_2026A for porting reference
    来源: NUEDC_PowerElectronics/Legacy_V2/NUEDC_2026A/Firmware_0/APP/PowerControl
    17 个源文件逐字节复制 + BACKGROUND.md(源项目背景/目标差异/移植顺序)
    未加入 .uvprojx, 不参与编译, 仅供移植参考
    源项目标注内部资料, 勿二次分发
2026-11-01 feat(ih01a): unify SSD1315 transfers on SPI DMA and display live PD Source PDOs
    Use HAL_SPI_Transmit_DMA for both u8g2 startup commands (bounded wait) and cooperative runtime refresh (nonblocking); remove HAL_SPI_Transmit from OLED. Capture received Source_Capabilities in a static seven-PDO snapshot via CubeMX USER CODE, clear on detach/reset, and format informational rows for Statistics/PD in PAGE_TEXT using fixed buffers, including a per-page wide-text mode. Add PD decode host regression, Keil source registration and document future USART DMA ring buffering and M24C32 interrupt-driven I2C design constraints.
    [app_tasks.c, pd_source_stats.c, pd_source_stats.h, ssd1315_display.c, test_pd_source_stats.c, ui_conf.c, ui_conf.h]
2026-11-01 docs(port): add NUEDC_2026A RAM-execution reference (stm32g4xx_it.c + .sct)
    stm32g4xx_it.c / stm32g474xx_flash.sct 仅作参考并在文件头标注:
    - RAMFUNC -> .ccm_text, 向量表 512B 进 CCM + VTOR 重定位, RAMVAR/RAMRO -> SRAM2
    - README_RAM_EXEC.md 说明动机/代价/G071 移植改法
    - 三个文件均不属于 PowerControl, 移植完成后删除(卸磨杀驴)
2026-11-01 docs(port): extract RAM-exec definitions from NUEDC_2026A main.h/main.c
    REF_main_h_main_c.md 摘录(带源行号):
    - main.h: RAMFUNC/RAMVAR/RAMRO 宏、ADC_VREF、SRAM2 常量池 extern、HRTIM 周期与死区常量
    - main.c: 常量池定义、VECT_TAB_START + RelocateVectorTable()、OverClock(不适用)、main() 启动顺序
    - 附源->本工程移植映射表与卸磨杀驴清单
2026-11-01 feat(ih01a): port ADC DMA control ISR to SRAM with fixed-point observer FSM
    Introduce G071-specific PowerControl v1 with TIM6-triggered ADC1 eight-rank circular dual frames, direct DMA1 CH2/3 HT/TC ISR and ISR_TIME profiling pulse, Q4 filtering and Q15 phase/frequency/burst command model. Keep TIM1 MOE/PWM_EN disabled and latch ADC/DMA faults. Move ISR out of generated interrupt module, relocate startup vector table to 256-aligned SRAM via VTOR, reserve RAM code and vector execution regions in Keil scatter, register native module, and document the reference, pin order and gated rollout; legacy G474 code remains uncompiled.
    [main.c]
2026-11-01 refactor(ih01a): organize PowerControl for ADC verification and live System stats
    Move VTOR SRAM vector relocation into Core/main.c. Replace former monolithic observer with conv_adc (TIM6 ADC DMA frames, calibrated integer pin voltage and factory MCU temperature), conv_controller (SRAM DMA ISR, ISR_TIME pulse and fail-closed state), and dashboard (100ms static PAGE_TEXT ADC readings). Add separate PowerControl group to Keil, preserve original G474 sources only as .legacy.* archives, keep heating PWM disabled, and document board validation.
    [conv_adc.c, conv_adc.h, conv_controller.c, conv_controller.h, dashboard.c, main.c, ui_conf.c]
2026-11-01 feat(ih01a): port system and RTC time services for uptime and reset UI
    Extract Collar-Radio system-operation, system-statistic and time concepts into lightweight framework/system and framework/time_service modules. Use LSE-backed RTC calendar as a relative reboot-reset clock; convert date to elapsed seconds with leap-year handling and field-wise HAL time/date reads. Show uptime days/hours/minutes/seconds at top of Statistics/System, add one-shot System Reset as final Settings/System item. Register Keil sources, add host RTC mock regression, document no backup battery and defer scheduled heater start.
    [main.c, system.c, system.h, test_time.c, time_service.c, time_service.h, ui_conf.c]
2026-11-01 fix(powercontrol): resolve CubeMX duplicate DMA1 CH2/3 ISR symbol
    Declare the generated stm32g0xx_it.c DMA1_Channel2_3_IRQHandler weak inside a CubeMX-preserved USER CODE block. This makes PowerControl's strong SRAM-resident ISR win during ARMClang linking and prevents L6200E after regeneration. Document map/VTOR verification.
2026-11-01 feat(ih01a): implement sink-only SPR PD selection and dual-input DCin status
    Complete USBPD sink DPM Source PDO/RDO selection, advertise 5/9/12/15/20V sink capabilities, prefer highest eligible Fixed SPR profile with 3A source-limited request. Cache one automatic choice per CC attach and expose manual GetSourceCapabilities in Settings/PD. Wire real VBUS ADC*16 into PWR IF and Statistics/System, initialize PWR IF successfully and track explicit contract vs DCin. Keep hardware CC untouched, flag possible external/internal Rd overlap, reject EPR/PPS with current minimal PD3 stack; add host tests and integration notes.
    [dashboard.c, pd_input.c, pd_input.h, pd_select.c, pd_select.h, test_pd_select.c, ui_conf.c, usbpd_pdo_defs.h]
2026-11-01 fix(pd): include STM32 HAL declarations and order USBPD headers
    [pd_input.c]
2026-11-01 feat(statistics): show ISR_LOAD ADC code as PWM duty percentage
2026-11-01 feat(pd): declare host-testable EPR fixed-PDO selector
    [pd_select.h]
2026-11-01 feat(pd): implement bounds-checked EPR fixed-PDO parsing and RDO builder
    [pd_select.c]
2026-11-01 test(pd): cover 28V EPR fixed selection and EPR-capable RDO
    [test_pd_select.c]
2026-11-01 docs(pd): record STM32G071 EPR migration and Lenovo C140 requirements
2026-11-01 refactor(pd): isolate Sink protocol policy under APP/algorithm and MiaoUI bridge
    - Move app PD selector, session policy and Source PDO cache out of framework
    - Add UI-only PD menu bridge; retain ST USBPD/Target and 20V SPR behavior
    - Update MDK project and host tests; correct EPR combined-caps slot indexing
    - Record C140 timing/reset lessons from DemoBoard and DPC27A
    [pd_input.c, pd_input.h, pd_select.c, pd_select.h, pd_source_stats.c, pd_source_stats.h, pd_ui.c]
2026-11-01 feat(uart): add nonblocking USART1 DMA 512B TX/RX rings, IDLE reception and deferred PD diagnostics
    - HAL circular RX DMA Ch4 with HT/TC/IDLE, TX normal DMA Ch5
    - 512-byte TX and RX software queues; no busy-wait on overflow
    - No-semi-hosting stdout mirror and bounded UART CLI
    - Record PD source caps, RDO, contract notifications and hard resets
    - Update CubeMX IOC, Keil sources and hardware/diagnostic notes
    [Compact_Induction_Heater.ioc, app_tasks.c, console_cli.c, main.c, pd_diag.c, pd_diag.h, pd_input.c]
2026-11-01 feat(temp): 10Hz integer NTC/MCU temperature service; debug USART1 boot TX
    - Add 39-point 5C NTC SYS/POT LUT and 0.1C integer interpolation
    - Snapshot filtered ADC at 10Hz outside DMA ISR; present all 3 temperatures
    - Flag out-of-range NTC/fault state instead of treating clamp as valid
    - Send a 6-byte UART probe before PD run, kick first TX DMA immediately
    - Expose boot stage and UART DMA diagnostics; retain nonblocking PD logs
    - Update Keil project, docs and host regression test sources
2026-11-01 refactor(core): own UART and SPI HAL DMA transfers in CubeMX user code
    - Move 512B UART TX/RX rings, RxToIdle DMA callbacks and boot UART into Core usart.c/h
    - Put SPI DMA start/status/completion/asynchronous abort in Core spi.c/h
    - Remove standalone debug_uart.c/h and Keil project entry
    - Replace blocking SSD1315/u8g2 startup with cooperative DMA state machine
    - Gate MiaoUI setup on display initialization READY/FAILED status
    - Preserve existing 5C NTC service, PD requests and disabled heater PWM
    - Document Core I/O ownership including future I2C and coroutine contracts
    [app_tasks.c, console_cli.c, main.c, retarget.c, spi.c, spi.h]
2026-11-01 fix(main): carry verified standalone startup and MicroLIB fixes from recovery
    - Retarget ArmClang sys I/O to prevent pre-main semihosting BKPT 0xAB
    - Enable MicroLIB and exclude conflicting mini_stdio.c from Keil build
    - Preserve mini_format.c and UART debug logging
    - Make uvoptx machine-local; fix Keil XML checkout LF line endings
    - Preserve main's PD, ADC, UART, OLED and power-control paths unchanged
    LSE RTC initialization is deliberately unchanged pending a separate bounded-startup fix.
    [retarget.c]
2026-11-01 chore(keil): adopt Keil's own uvprojx serialization as baseline
    Keil 每次保存/关闭工程都会重写整个 XML(空元素展开、standalone 声明、空行),
    语义不变却产生数百行 diff,反复阻塞分支切换与拉取。
    本提交直接采用 Keil 写出的规范格式作为基线,之后 Keil 再保存应不再产生 diff。
    语义核对:124 个源文件条目、useUlib=1、C/Asm Define、ScatterFile 均与前一版一致;
    唯一实质差异是 Flash2(Flash Download 驱动 DLL)由 BIN\\UL2V8M.DLL 变为 BIN\\UL2CM3.DLL,
    即 Keil 保存时按当前调试器选择改写的值,予以接受。
2026-11-01 chore(keil): update debug tab option RunUserProg2 to 0
    Keil 重新保存 debugger 配置时带来的唯一实质变化(调试前后不运行用户程序)。
2026-11-01 chore(keil): re-track uvoptx as baseline (debugger settings must travel with the repo)
    撤销 2026-11-01 的排除决定:调试器驱动选择(CMSIS-DAP/CMSIS_AGDI)、
    Flash 下载算法(STM32G0xx_128.FLM, 0x08000000/0x00020000)、断点会话只存在于 uvoptx,
    排除后换机器或重新 clone 必然丢失,实测已发生一次。
    - 采用 Keil 原生序列化(standalone=false, LF)作为基线,后续窗口/断点变化可直接提交
    - .gitignore 移除 *.uvoptx,并留下说明,避免以后又把它加回忽略
    - uvprojx 仍是源码列表/编译设置的唯一权威; uvoptx 只承载调试配置与工程会话状态
2026-11-01 feat(pd-epr): prepare safe 28V/5A fixed PDO selection without enabling EPR
    - Maintain MINSNK 20V/3A firmware behavior; separate EPR 5A current ceiling
    - Add opt-in SPR RDO EPR-capable bit helper for future FULL PE integration
    - Cover 28V/5A EPR position 8 and 5A current in host selector tests
    - Record matched FULL stack migration requirements and 140W hardware gates
    No production firmware high-voltage request until full EPR entry + 5A cable verification.
    [pd_select.c, pd_select.h, test_pd_select.c]
2026-11-01 test(host): fix run.sh for Windows hosts and make it fail-stop clean
    1) snprintf: mingw 默认是 MSVCRT 语义(不按 n 截断/不保证 NUL),导致 test_time
    的 size=1 应输出空串 断言假失败; 加 -D__USE_MINGW_ANSI_STDIO=1 后与 ARM 一致
    2) 第 25 行续行误写成双反斜杠, sh 会把它当成名为反斜杠的输入文件
    3) 输出目录改为 OUT/TMPDIR 可覆盖, 便于 Windows 原生环境指定
    4) 抽成 build_run 函数, 任一用例失败即整体退出(set -e 生效)
2026-11-01 feat(usbpd): vendor ST FULL EPR-capable middleware v5.4.1 (not yet linked)
    把 MINSNK -> FULL(PD3.1 EPR) 迁移所需的物料准备好, 但不改任何构建配置,
    当前镜像行为与 main 完全一致(20V/3A)。
    新增 Firmware/Middlewares/ST/STM32_USBPD_Library_v541/ (29 个文件, 592 KB):
    - Core v5.4.1 (aafa359): 10 个头文件 + USBPDCORE_PD3_FULL_CM0PLUS_Keil.lib(140,892 B) + usbpd_trace.c
    - Devices/STM32G0XX (527363f): 7 个 .c + 6 个 .h + usbpd_devices_conf_template.h
    - VERSION.md 记录仓库/提交/日期与"只取需要的部分"的取舍
    新增 Docs/USBPD_FULL_EPR_MIGRATION_IMPACT.md:
    - 现状实测(库/宏/头文件/工程源码/镜像尺寸)
    - .uvprojx 切换清单(7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
2026-11-01 docs(pd-epr): add handoff for the next agent (state, landmines, next 5 steps)
    一页交接文档 Docs/HANDOFF_PD_EPR_FULL.md:
    - 分支/HEAD/基点, 板端 20V 正常, 镜像与 main 行为一致
    - 本分支 4 个提交做了什么 + 实测数据(Code=59192/ZI=13840, EPR 助手被 gc 掉)
    - 关键事实: MINSNK vs FULL lib 尺寸, 现有头文件 0 处 EPR, 新版设备层强依赖
    usbpd_devices_conf.h, 应用层 180/382 符号落差
    - 纪律与坑: 改选项必须 Rebuild, MicroLIB 不需手写 __MICROLIB, 不要手写 RDO 位,
    新旧中间件不可混用, uvoptx 已重新跟踪, host 测试需 mingw ANSI stdio 宏
    - 下一步 5 步 + 每步验收标准, 硬件闸门, 文档索引(标注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
2026-11-01 fix(pd-epr): validate UCPD2 port0 DMA6/7 config for FULL stack
    - Confirm existing single-port hardware mapping, RX DMA1 CH6 and TX CH7
    - Assert single-port build in devices configuration
    - Correct handoff instructions that mistakenly targeted DMA2/4 (ADC/UART conflict)
    - Preserve TIM3 timing, passive sink/CC and all working 20V source files
2026-11-01 refactor(pd-epr): import ST 5.4.1 FULL-compatible DPM core and callback
    - Replace legacy non-RTOS DPM source with exact official aafa359 core source
    - Add required new EPR DPM action callback, conservative SPR-only default
    - Keep physical peripheral/sink policy and EPR high-voltage requests disabled
    This stage needs the paired include/lib switch before it can be compiled.
2026-11-01 build(pd-epr): switch Keil target to vendored ST FULL 5.4.1 stack
    - Select USBPDCORE_LIB_PD3_FULL with matching FULL CM0+ Keil archive
    - Replace all referenced core/trace/G0 device middleware paths with v541
    - Keep UCPD2 port0 DMA1 CH6/CH7 and TIM3, MicroLIB, and nonblocking UART
    - Do not mix old MINSNK source/headers with new FULL binary
    Build not run here: requires Keil Arm Compiler 6 Rebuild All and board-level SPR regression; do not enable EPR output before those checks.
2026-11-01 feat(pd-epr): implement gated 28V/5A sink negotiation state and typed RDO
    - Replace handwritten EPR request bits with ST USBPD_SNKRDO_TypeDef fields
    - Observe EPR mode notifications and extended source capabilities
    - Pick only valid EPR Fixed 28V/5A with matching CopyPDO
    - Defer one-shot EPR enter/exit to cooperative foreground, no automatic retry
    - Fail safely to SPR and keep heater PWM unchanged
    - Require explicit hardware-approved macro (OFF by default)
    Must pass Keil rebuild and 20V bench regression before authorizing high voltage.
    [pd_diag.c, pd_diag.h, pd_epr_policy.h, pd_input.c, pd_input.h]
2026-11-01 feat(pd-epr): connect FULL stack EPR capabilities and deferred policy
    - Advertise EPR sink support only behind hardware-approved 28V/5A gate
    - Provide 140W EPR operational PDP, sink PDO list and CopyPDO callback
    - Record extended EPR source PDOs and EPR mode notifications
    - Drive one-shot EPR enter/exit from foreground app loop
    - Keep current tested SPR request behavior and physical Rd setup intact
2026-11-01 refactor(pd-epr): remove unverified handwritten RDO builders and tests
    - Pure selector returns PDO parameters only
    - EPR and SPR request generation uses ST FULL USBPD_SNKRDO_TypeDef in policy
    - Retain host checks for EPR Fixed 28V/5A selection and 32V ceiling
    - Update migration docs to reflect active FULL integration and safety gate
    [pd_select.c, pd_select.h, test_pd_select.c]
2026-11-01 docs(pd-epr): record what CubeMX ships vs the EPR-capable middleware
    实测 CubeMX 6.17.0 + STM32Cube_FW_G0_V1.6.3:
    - USBPD 不在 Software Packs 列表, 而是随固件包以 Middleware 形式提供
    - 该包里有 USBPDCORE_PD3_FULL_CM0PLUS_Keil.lib(123,306 B), 但头文件
    usbpd_core.h/usbpd_def.h 与旧版同尺寸且 EPR 出现 0 次 -> 只有 PD3.0 FULL, 无 EPR
    - EPR 需要 core v5.4.1(49,794/188,382 B, 含 USBPD_PE_Request_EPRModeEnter),
    即本仓库 vendored 的 STM32_USBPD_Library_v541, CubeMX 不管理该路径
    并记录工程约束: LibraryCopy=1 时 CubeMX 重新生成会用旧版覆盖
    Firmware/Middlewares/ST/STM32_USBPD_Library 与 uvprojx 相关条目; 建议步骤 3 完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
2026-11-01 fix(pd-epr): preserve SPR state on EPR request rejection and exit
    Snapshot last SPR request and voltage before EPR selection; restore them on
    rejected EPR request or EPR exit. Attempt exit only once in foreground.
    Avoid misleading 28V status when source refuses EPR.
    [pd_input.c, pd_input.h, test_pd_select.c]
2026-11-01 test(pd-epr): constrain fixed EPR selection to 28V and expose EPR CLI status
    - Do not accidentally pick nonstandard 30V when 28V/5A also advertised
    - Add host selection regression for mixed 28V/30V advertised fixed PDOs
    - Report hardware permission gate and EPR mode on CLI pd command
    [console_cli.c, pd_select.c, test_pd_select.c]
2026-11-01 diag(pd-epr): expose FULL core initialization failure stage over UART/Watch
    Add explicit 0xE1/0xE2/0xE3 failure breadcrumbs and [PD_INIT] startup log,
    so version/stack mismatches are visible before PD nonreturning loop.
    No change to PD voltage/current requests.
2026-11-01 docs(pd-epr): record FULL migration checkpoints and unverified hardware gates
    Document completed code changes, corrected DMA mapping, precise Keil/board
    regression steps, explicit 28V hardware permission and pending validation.
    No change to PD runtime behavior.
2026-11-01 fix(pd-epr): include <string.h> in usbpd_dpm_user.c so FULL build links
    首次对 FULL 分支做 Keil Rebuild(-r) 时抓到唯一编译错误:
    usbpd_dpm_user.c(388): call to undeclared library function memcpy [-Wimplicit-function-declaration]
    根因: ST 原文件把 string.h 包在 #if defined(_TRACE) 里(第 31-35 行),
    本工程不定义 _TRACE, 于是 memcpy/memset 都没有声明;
    新加的 EPR 代码(PDO_EPR 分支里的 memcpy)正好落在这个条件块之外。
    修法: 在 USER CODE BEGIN Includes 里加 <string.h>(CubeMX 重新生成不会丢)。
    验证: Keil 批处理 Rebuild 通过, 0 Error / 0 Warning
    Code=76,204 RO=3,632 RW=464 ZI=13,848
    (MINSNK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
2026-11-01 diag(pd-epr): report which InitCore sub-step failed (LIB_ID/CAD/PE)
    板端现象: 20V 可用、UART 正常, 但停在 usbpd.c:55 的 while(1),
    即 USBPD_DPM_InitCore() != USBPD_OK, 且原提示 "library check FAILED" 会误导。
    从 vendored FULL 库反汇编得到 USBPD_PE_CheckLIB 期望的常量:
    LDR r1,=0xCFBF0000 ; ADDS r1,r0,r1 ; RSBS/ADCS => 仅当 LibId == 0x30410000 返回 1
    本工程 LIB_ID = LIB_PD3(3<<28) | LIB_CORE | LIB_STACK_VER(0x410<<12) | LIB_FULL
    = 0x30410000 => 理论上应通过, 故失败应发生在 CAD_Init / PE_Init。
    本次只加诊断, 不改行为:
    - usbpd_dpm_core.c: CHECK_*_FUNCTION_CALL 宏记录 g_pd_init_substep(1=CAD,2=PE)
    与 g_pd_ini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
2026-11-01 fix(pd-epr): enlarge microLIB heap to 8 KiB so USBPD_PE_Init can allocate
    板端定位(调试器读数):
    g_uart_boot_stage=3, g_usbpd_full_stage=0xE1, g_pd_init_substep=2 (PE_Init),
    g_pd_init_status=0x15=21 = USBPD_MALLOCERROR, PC 落在 MX_USBPD_Init+0x45 的 while(1)
    根因: FULL 栈用 malloc 创建 PE/PRL/CAD 句柄。反汇编 v5.4.1 库得到需求量
    USBPD_PRL_GetMemoryConsumption = 0x396 (918 B, 双口)
    USBPD_CAD_GetMemoryConsumption = 0x24 (36 B, 双口)
    USBPD_PE 常数 0x6F<<5 = 3552 B
    => USBPD_PE_GetMemoryConsumption() = 4506 B (双口口径)
    而 startup 的 Heap_Size 只有 0x400 = 1024 B, microLIB malloc 就从这里分配, 于是
    PE_Init 返回 MALLOCERRO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
2026-11-01 chore(cubemx): record 8 KiB heap in the .ioc so regeneration keeps it
    用户在 CubeMX 里把 heap 设为 0x2000(替代直接改 startup)。只保留这一处 .ioc 变化:
    - ProjectManager.HeapSize=0x400 -> 0x2000
    其余被 CubeMX 重新生成时改回去的内容已还原为仓库版本:
    - Core/Src/main.c(丢了 g_uart_boot_stage 三行与 DebugUART_Init 调用 -> 串口完全没有输出)
    - Core/Src/usart.c 与 .ioc 的 Dma.USART1_RX.2.Mode(CIRCULAR->NORMAL) 与 USART1_IRQn(1->2)
    - USBPD/App/usbpd.c(丢了 [PD_INIT] 诊断打印)
    - USBPD/App/usbpd_dpm_core.c(CubeMX 用旧模板覆盖, 924->480 行)
    - USBPD/Target/{usbpd_dpm_user.c,usbpd_dpm_user.h,usbpd_devices_conf.h,usbpd_dpm_conf.h}
    -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
2026-11-01 feat(tools): make CubeMX regeneration safe (USER CODE + guard + repair script)
    目标: 以后仍可用 CubeMX 改引脚/时钟/heap, 但不能再破坏 PD FULL 栈与串口。
    1) main.c 只改 USER CODE 区(重新生成不会丢):
    - DebugUART_Init() 与 g_uart_boot_stage 从 CubeMX 辖区搬到 USER CODE BEGIN 2
    - MX_USBPD_Init() 也移到 USER CODE BEGIN 2(USBPD 不再由 CubeMX 生成)
    - USER CODE BEGIN 0 增加生成护栏: 若 USBPDCORE_LIB_PD3_FULL 未定义则 #error,
    提示运行 Firmware/Tools/cubemx_post_generate.ps1 —— 忘记修复时编译直接失败,
    不会静默编出 MINSNK 版本
    2) Firmware/Tools/cubemx_post_generate.ps1 (新增, 幂等):
    - 把 uvp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
    [main.c]
2026-11-01 feat(tools): also restore Firmware/USBPD in cubemx_post_generate.ps1
    CubeMX 若仍勾选 USBPD 中间件, Generate 会用旧模板覆盖 Firmware/USBPD/*.c;
    脚本现在把该目录一并从 git 恢复(可用 -SkipUsbpdRestore 保护未提交的改动)。
    验证: 幂等运行无输出改动; 语法解析通过。
2026-11-01 chore(cubemx): USBPD unchecked in .ioc (TIM3 released) + restore PD plumbing
    用户在 CubeMX 里取消 USBPD 中间件并重新生成。CubeMX 因此:
    - 释放 TIM3(原由 USBPD 虚拟信号占用)
    - 删除 Firmware/USBPD 与整份 Middlewares/ST/STM32_USBPD_Library(v541 也被删)
    - 从 stm32g0xx_it.c 移除 #include "usbpd.h" 与 USBPD_DPM_TimerCounter()
    - 把 USART1 RX DMA 改成 NORMAL、IRQ 优先级改成 2
    本次修复:
    - main.c: USER CODE Includes 增加 #include "usbpd.h"(MX_USBPD_Init 用)
    - stm32g0xx_it.c: USER CODE 区补 #include "usbpd.h" 与 USBPD_DPM_TimerCounter()
    (PD 的 1ms 基准, 放 USER CODE 后重新生成也不会丢)
    - .ioc / usart.c: USART1 RX DMA 回到 DMA_CI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
    [Compact_Induction_Heater.ioc, main.c]
2026-11-01 fix(core): restore USBPD_DPM_Run() inside USER CODE (scheduler was dead)
    现象: 程序停在 main.c 的 while(1), UI/ADC/PD 全无反应。
    根因: USBPD_DPM_Run() 原来由 CubeMX 生成在 while(1) 里(USER CODE 之外);
    取消 USBPD 中间件后 CubeMX 把这一行删掉了, 于是调度链断掉:
    USBPD_DPM_Run -> USBPD_DPM_UserExecute -> APP_Tasks_RunOnce
    -> CoroOS_RunOnce + SSD1315_Display_Service
    没有 USBPD_DPM_Run(), coroOS 调度器一次都不会被调用。
    修复: 把 USBPD_DPM_Run() 放进 USER CODE BEGIN 3(重新生成也不会丢),
    并加注释说明整条调度链。
    顺带: cubemx_post_generate.ps1 增加 USER CODE 自检: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
    [main.c]
2026-11-01 fix(core): dispatch USBPD_PORT0_IRQHandler from the UCPD ISR (USER CODE)
    现象: 卡在 stm32g0xx_it.c 的 UCPD1_2_IRQHandler 里, 程序不再前进。
    根因: 勾选 USBPD 时 CubeMX 会在该 handler 里(USER CODE 之外)生成
    USBPD_PORT0_IRQHandler();
    取消 USBPD 后这一行被删, 但 ucpd.c 仍然 NVIC_EnableIRQ(UCPD1_2_IRQn),
    设备层也仍然使能 UCPD Type-C/TX/RX 中断 -> 中断标志无人清除 ->
    中断风暴, 表现就是"停在 ISR 里"。map 里也能看到链接器把
    .text.USBPD_PORT0_IRQHandler 当作未引用代码删掉了。
    修复: 把 USBPD_PORT0_IRQHandler(); 放进 USER CODE BEGIN UCPD1_2_IRQn 0
    (USBPD port0 = UCPD2), 并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
2026-11-01 fix(tools): real if/else for the UCPD ISR check in cubemx_post_generate.ps1
    The USBPD_PORT0_IRQHandler() check was inserted between the if and the else
    of the SysTick check, leaving a dangling 'else' that made the whole script
    abort with 'The term else is not recognized' (exit 1). Both checks are now
    self-contained if/else statements.
    File also normalized to LF + a single leading UTF-8 BOM.
2026-11-01 fix(pd-epr): decode separate 1..6 EPR PDOs and add manual 28V test gate
    - Correct EPR source callback length (4..24 bytes), shift into logical PDO positions 8..13
    - Log raw EPR payload size and first two objects for chunking diagnostics
    - Accept hardware review of 28V input path but keep automatic EPR entry disabled
    - Add explicit 'pd epr' CLI for one-shot entry after stable SPR contract
    - Preserve normal 20V boot, ST source/cable eligibility checks and no-auto-retry on failure
    [console_cli.c, pd_diag.c, pd_diag.h, pd_epr_policy.h, pd_input.c, pd_input.h]
2026-11-01 fix(pd-epr): return full 8-byte RDO + copied PDO to FULL EPR Request callback
    - Construct EPR_REQUEST payload as two matching 32-bit data objects
    - Return Size=8 to USBPD_CORE_DATATYPE_REQ_COPYPDO callback
    - Record selected EPR CopyPDO hex for protocol trace verification
    - Preserve 20V SPR default and explicit 'pd epr' bench authorization
    [pd_diag.c, pd_diag.h, pd_input.c, pd_input.h]
2026-11-01 fix(pd-epr): do not reuse SPR RDO when EPR capabilities are unavailable
    - Block invalid EPR_REQUEST with absent/malformed/no 28V/5A source PDO
    - Queue one-shot EPR mode exit and keep previous safe SPR selection
    - Exit EPR on extended capabilities timeout rather than remain indefinitely
    - Keep automatic entry disabled and heater PWM unchanged
    [pd_input.c]
2026-11-01 fix(pd-epr): bound EPR capability negotiation and align Sink 140W PDP metadata
    - Exit EPR if no valid fixed 28V/5A request was formed within 2.5s
    - Advertise matching 140W SinkOperationalPDP / SinkMaximumPDP when approved
    - Keep 20V default until explicit CLI or Settings manual EPR retry
    - Do not enable heater output
    [pd_input.c]
2026-11-01 docs(pd-epr): record successful FULL 20V bench regression and manual 28V EPR test plan
    - Record check=1, heap 8192/reqmem 4506, 20.048V input and separate boots
    - Document CubeMX USBPD removal, eventual main .ioc sync, Git ownership
    - Describe manual 'pd epr' testing, 8-byte request payload and error triage
    - Keep 140W hardware/cable check and Keil rebuild as required gates
2026-11-01 chore(mdk): uvoptx records the real CMSIS-DAP probe (SW-DP 0BC11477)
2026-11-01 fix(pd-epr): accept both EPR capability payload layouts
    PD_Input_EPRCaps() assumed the FULL PE always hands over 1..6 EPR-only
    objects (4..24 B). It now picks the layout from the payload size:
    <=24 B -> EPR-only, stored at slots 7..12 so the first EPR PDO is object
    position 8; >=28 B -> combined SPR+EPR, stored from index 0 (positions
    already match). Upper bound relaxed to (7+6)*4 = 52 B.
    Object positions can therefore never be shifted by the layout, and a
    4-byte payload cannot silently fail. EPR_CAPS 'b' now reports the first
    EPR PDO (position 8) in both layouts.
    Verified: Keil UV4 -r 0 Error / 0 Warning, Code=78,312 RO=3,916
    RW=464 ZI=21,120; host suite 7/7 (mingw gcc -Wall -Wextra -Werr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
    [pd_input.c]
2026-11-01 feat(pd-epr): raw EPR status + full EPR event/action tracing
    EPR entry gave 'EPR_ENTER a=1' and then nothing, because the app collapsed
    the PE return value into a boolean and never logged EPR notifications
    113/115/116/118/119. Every observation point is now explicit:
    - EPR_ENTER records the raw USBPD_StatusTypeDef (0 OK 1 NOTSUPPORTED
    2 ERROR 3 BUSY) instead of a success flag.
    - EPR_EVT records all EPR notifications (112..119) with a state bitmask
    and prints the decoded event name on the next line.
    - EPR_ACT records each PE question (USBPD_ACTION_*) and our exact reply,
    including the SNK_PDP_EPR / SNK_PDO_EPR size we hand over.
    - USBPD_DPM_Notification forwards ACK/INIT/SNKCAP/SRCCAP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
    [pd_diag.c, pd_diag.h, pd_epr_policy.h, pd_input.c]
2026-11-01 feat(pd): open the SPR contract at 20V/5A EPR-capable like the verified baseline
    The CH32X035 EPR sink in Desktop_PD_Power_Converter stabilises at 28V with a
    first Request of 20V/5A, PDO5, EPR-capable (RDO 0x5147D1F4). This project
    asked 20V/3A (0x5144B12C) because PD_INPUT_MAX_MA clamped at 3A.
    - IH01A_PD_SPR_MAX_MA = 5000 in pd_epr_policy.h, PD_INPUT_MAX_MA follows it.
    - Sink PDO5 is 20V/5A so the request never exceeds our own advertised PDO.
    - A 3A (non e-marked) cable makes the Source advertise 3A, so the request
    stays at 3A there: 5A only happens on a 5A e-marked cable.
    - test_pd_select asserts both cases (20V/5A -> 5A, 20V/3A -> 3A).
    - Docs record the bench logs where the PE accepts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
2026-11-01 fix(pd-epr): enable Unchunked + Source_Capabilities_Extended, the EPR gates
    Same adapter and cable reach 28V on the CH32X035 reference, so the source,
    cable and power path are fine and the fault is in the ST FULL integration.
    The vendored DPM core is byte-identical to ST's src/usbpd_dpm_core.c
    (aafa359) apart from our diagnostics, which leaves the PE runtime feature
    bits: PE_UnchunkSupport and Is_SrcCapaExt_Supported were FALSE.
    EPR_Mode is an extended control message and EPR_Source_Capabilities is an
    extended message; PD3.1 requires EPR ports to support unchunked extended
    messages. With UnchunkSupport = 0 the PE accepts
    USBPD_PE_Request_EPRModeEnter() (USBPD_OK) and then builds nothing, wh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
2026-11-01 feat(pd-diag): trace PHY TX and UCPD TX outcomes to split the EPR stall
    The PE accepts USBPD_PE_Request_EPRModeEnter() (USBPD_OK), then shows no
    EPR notification, no DPM data callback and no TX, and a second request
    returns BUSY. App-level logs cannot tell 'the PE built nothing' from 'the
    PE built EPR_Mode and the PHY dropped it', so the probe now sits in the
    ST device layer:
    - PD_TX <type> <bytes> at USBPD_HW_IF_SendBuffer() entry, once per type
    (type 10 = EPR_Mode, 2 = Request)
    - PD_TXREJ <type> <st> when the PHY refuses TX (RX busy / TX DMA busy)
    - PD_TXDONE 0/1/2 0 TXMSGSENT, 1 TXMSGDISC, 2 TXMSGABT
    The hooks only enqueue diag records, they never pri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
    [pd_diag.c, pd_diag.h]
2026-11-01 fix(pd-epr): register EPR entry from PE callback context, not the idle loop
    Bench result of the previous attempt: both fallbacks returned USBPD_BUSY,
    because the first USBPD_PE_Request_EPRModeEnter() had already written 0xA8
    into the PE machine-state byte; the machine never runs, so every later
    request is refused. The library locks itself.
    The API itself checks that the last message was a Request, which points at
    its intended usage: call it while the PE is processing a message. So:
    1. 'pd epr' re-issues the current SPR Request (same 20V/5A) to re-open a
    Request context -> EPR_ACT 0x2A2
    2. POWER_EXPLICIT_CONTRACT notification now calls
    USBPD_PE_Request_EPRMode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
    [pd_epr_policy.h, pd_input.c]
2026-11-01 fix(pd-epr): trigger a natural caps->request->PS_RDY cycle, trace every TX
    Bench log showed the re-request path returning OK while nothing appeared on
    the wire and every later API answered BUSY: USBPD_PE_Send_Request() wedges
    the sink PE (it leaves a pending Request that the sink state machine never
    emits), so the ordering was wrong.
    - 'pd epr' now sends Get_Source_Capability first (PE idle, control 0x07);
    the resulting Source_Capabilities -> Request -> PS_RDY cycle gives a real
    PE message context, and the EPR entry is registered from the
    POWER_EXPLICIT_CONTRACT notification. Send_Request stays as fallback.
    - PD_TX no longer dedupes: only GoodCRC is reported once, every other
    messag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
    [pd_diag.c, pd_input.c]
2026-11-01 fix(pd-epr): force the SinkTxOK predicate the PE gates DPM TX on
    Disassembly of the SNK ready handler shows every app-initiated transmission
    is gated: PE_StateMachine_SNK_ReadyWait calls USBPD_PRL_IsResistor_SinkTxOK()
    before starting a generic machine, and USBPD_PE_Request_CtrlMessage returns
    BUSY while a machine is pending. The G0 implementation derives that
    predicate from the UCPD CC vstate equal to Rp-3.0 A plus a valid CCx, which
    this board (external Rd, no internal CC detection) never reports. Reactive
    messages (GoodCRC, Request in the sender-response window) do not use the
    gate, which is why SPR works while Get_Source_Capability, EPR_Mode and the
    re-Request are all accepted and silent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
    [pd_diag.c, pd_epr_policy.h]
2026-11-01 fix(pd-epr): request the EPR PDO by its 1-based index inside EPR caps
    Bench log finally reached the EPR request: EPR_Mode sent and ACKed,
    EPRMODE_SUCCEEDED, EPR_Source_Capabilities received (28V/5A + one AVS),
    EPR_Request transmitted - and the Source answered with a Hard Reset that
    cut VBUS and rebooted the board.
    Cause: the sink asked for Object Position 8 (0x8147D1F4). EPR_Request
    positions are the 1-based index inside the EPR_Source_Capabilities payload;
    position 8 does not exist there, so the request is invalid. The verified
    CH32X035 sink does exactly this: PD_Select_EPR_Highest_Fixed() returns the
    1-based index of the received EPR array and PD_Send_EPR_Request_Fixed()
    puts it straight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
    [pd_input.c]
2026-11-01 feat(pd-epr): trace RX headers and delay the EPR capability fetch by 120 ms
    OPOS=1 and a bit-exact CopyPDO still end in a Source Hard Reset, so the
    request content now matches the verified reference ('0x1147D1F4' equals
    what PD_Send_EPR_Request_Fixed() builds). That points at sequencing.
    - PD_RX records every received message (type + raw header word); PD_TX now
    carries the raw header too, so revision/msg-id/NDO are visible.
    - IH01A_EPR_DELAY_GETCAP: decline the capability set the PE fetches 7 ms
    after EPRMODE_SUCCEEDED, then request EPR_Get_Source_Cap ourselves 120 ms
    later (the reference sink's PD_EPR_GET_CAP_DELAY_MS) and request from that
    fresh set. Their notes record exactly thi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
    [pd_diag.c, pd_diag.h, pd_epr_policy.h, pd_input.c]
2026-11-01 test(pd-epr): revert the delayed getcap, request 28V/3A to find the discriminator
    RX tracing showed my delay experiment broke the request: with the early
    capability set declined, s_epr_copy_valid stayed 0, the PE asked for
    REQ_COPYPDO (GETINFO 29) and got 0 bytes, so the EPR_Request carried an
    empty CopyPDO - worse than before. IH01A_EPR_DELAY_GETCAP is back to 0.
    The RX trace also proves the Source sends nothing before the Hard Reset: no
    Reject, no Not_Supported, just the ordered set 5 ms after our request. That
    is a protocol-error level reaction, so the next suspect after the now
    bit-exact RDO/CopyPDO is the requested current: a Source that cannot grant
    5 A (cable e-marker rating) may ans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
    [pd_epr_policy.h, pd_input.c]
2026-11-01 fix(pd-epr): set UnchunkedExtendedMessage in the Request RDO
    3A with a correct CopyPDO still hard-resets, so current is not the
    discriminator. The RX trace shows the Source never sends Reject or
    Not_Supported, it goes straight to Hard Reset: a protocol violation.
    USBPD_SNKFixedVariableRDO_TypeDef has UnchunkedExtendedMessage at bit 23;
    our requests (SPR and EPR) always left it 0 because PD_EncodeFixedRDO only
    set ObjectPosition/current/NoUSBSuspend/EPR_Capable. PD3.1 requires an
    EPR-capable Sink to declare Unchunked Extended Messages support in the
    Request RDO, so a Source that checks it treats our EPR_Request as invalid.
    The bit is now set whenever the port advertises unchunked support.
    E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
    [pd_input.c]
2026-11-01 fix(pd-epr): hand the PE only the copied PDO, not RDO+PDO
    The logic-analyser capture of our EPR_Request settled it:
    89 2C | 2C B1 C4 11 | 2C B1 C4 11 | CRC
    hdr | RDO 0x11C4B12C| CopyPDO 0x11C4B12C <- duplicate of the RDO
    The Source's EPR PDO was 0x0008C1F4, so DO2 was wrong and the Source
    answered with a Hard Reset. USBPD_CORE_DATATYPE_REQ_COPYPDO supplies ONLY
    the copied PDO (the PE adds the RDO); returning RDO+PDO made the engine copy
    our first four bytes. PD_Input_EPR_CopyPDO() now returns just s_copy_pdo and
    GetDataInfo hands back exactly 4 bytes.
    Capture also confirms: EPR_Mode DO = 0x018C0000 (action 1 = Enter,
    PDP 0x8C = 140 W), Source ACK = 0x02000000, SUCCESS = 0x03000000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
    [pd_epr_policy.h, pd_input.c, pd_input.h]
2026-11-01 feat(pd-diag): log the first two data objects of every transmitted message
    The CopyPDO is now 4 bytes (GETINFO 29 = 4) but the Source still hard-resets,
    and the header-only TX trace cannot show what the policy engine actually
    placed in DO1/DO2. PD_TXDO records the first two data objects of each data
    message, printed in hex:
    [PD n] PD_TXDO do1=0x11C7D1F4 do2=0x0008C1F4
    so the EPR_Request payload can be verified from the UART log without the
    logic analyser. Build: 0 error / 0 warning, Code=79,904.
    [pd_diag.c, pd_diag.h]
2026-11-01 feat(pd-epr): runtime switch for the EPR object-position convention
    The frame is now provably correct in the UART log
    (PD_TXDO do1=0x11C7D1F4 do2=0x0008C1F4) and the logic-analyser capture shows
    the Source GoodCRCs it (its last frame before the Hard Reset) yet never
    answers Accept/Reject/PS_RDY. That leaves the one untested combination:
    the object-position convention. Earlier OPOS=8 was tried while the CopyPDO
    was still broken, so it was never actually evaluated.
    'pd epr' -> position = 1-based index inside EPR_Source_Capabilities
    'pd epr8' -> position = absolute 8..13
    PD_Input_SetEPRObjectPosition() selects it at runtime; the EPR_CAPS slot is
    8..13 internally, so absolute needs no conversi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
    [console_cli.c, pd_input.c, pd_input.h]
2026-11-01 feat(pd-epr): make the absolute object position the default, throttle keepalive tracing
    28V/5A EPR contract now succeeds: EPR_REQUEST 0x81C7D1F4 (OPOS=8) is
    accepted, PS_RDY follows and the stack emits EPR KeepAlive every ~485 ms
    with the source answering each one.
    - IH01A_EPR_OPOS_ABSOLUTE_DEFAULT = 1; 'pd epr1' keeps the experimental
    1-based convention available.
    - PD_TX/PD_RX now skip a frame whose (type, first data object) repeats, so
    an EPR session no longer writes ~242 B/s of identical KeepAlive lines;
    the trace still shows every new or changed frame.
    - Docs record the four conditions that all had to be true (SinkTxOK,
    4-byte CopyPDO, Unchunked+EPR RDO bits, absolute object po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
    [pd_diag.c, pd_diag.h, pd_epr_policy.h, pd_input.c]
2026-11-02 feat(pd-epr): auto-enter EPR by default, with SPR fallback
    IH01A_EPR_28V5A_AUTO_ENTER is now 1: 250 ms after the SPR explicit contract
    the firmware triggers GET_SRC_CAP, registers the EPR entry from the
    POWER_EXPLICIT_CONTRACT notification and requests EPR_Mode, so a cold boot
    produces the complete SPR -> EPR sequence for a logic-analyser capture. A
    source whose PDO1 lacks the EPR Capable bit is never attempted and stays at
    20 V; EPRMODE_FAILED/INVALID or a 2.5 s capability timeout restores SPR and
    does not auto-retry (one attempt per attach).
    CLI: 'pd auto' toggles auto-enter at runtime, 'pd epr' forces a manual
    attempt with the absolute object position, 'pd epr1' keeps the 1-based
    convent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
2026-11-02 fix(pd-epr): keep EPR KeepAlive inside the PD3.1 250-500 ms window
    The logic-analyser capture of a successful 28V session shows the policy
    engine's own KeepAlive at 1.93 s intervals (1.95/1.93/1.92/1.93 s), four
    times the PD3.1 tEPRKeepAlive ceiling, even though the same source ACKed
    every one. The cadence comes from the PE state machine, whose pacing is
    stretched by the bare-metal loop (that capture was taken while the UART
    diagnostics ran at ~240 B/s).
    PD_TxTrace now stamps g_pd_last_keepalive_ms on every KeepAlive the stack
    transmits (before the repeat filter, otherwise only the first would be
    stamped), and PD_Input_EPR_Poll sends its own KeepAlive at a 375 ms cadence
    whenever a 28 V con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
    [pd_diag.c, pd_input.c]
2026-11-02 feat(pd-epr): retry the capability set once when the EPR bit is missing
    The capture shows the Source advertising PDO1's EPR-capable bit
    inconsistently between capability sets within one attach (eprCap=1 in the
    first set, 0 in the set it sends after our Get_Source_Capability), while the
    other attach did the opposite. Auto EPR gates on that bit, so such an attach
    would silently stay at 20 V.
    When auto/manual EPR is wanted, the contract exists and PDO1 lacks the bit,
    the app now requests one fresh capability set (EPR_ACT 0x2A9) before giving
    up for that attachment.
    Build: 0 error / 0 warning, Code=80,616.
    [pd_input.c]
2026-11-02 fix(pd-epr): keep the keepalive safety net off the normal path
    PulseView cursors on the same capture put the stack's EPR KeepAlive at
    500 ms, not the 1.93 s my parser derived: the decode file's timestamps are
    sample counts (~3.86 MHz), not microseconds, so every interval I quoted was
    3.86x too large. Re-scaled: Accept->PS_RDY 264 ms (SPR) / 164 ms (EPR),
    Source_Caps retry 181 ms, GoodCRC ~0.8 ms - all nominal, and the three
    'repeated' Source_Capabilities per MessageID are decoder duplicates of one
    frame, not 12 retransmissions.
    500 ms is inside tEPRKeepAlive (250-500 ms), so the app-side keepalive is
    demoted to a safety net that only fires when the stack's cadence exceeds
    800 ms. Docs corre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
    [pd_input.c]
2026-11-02 tools(sigrok): PD 3.1/3.2 (EPR) support in the PulseView usb_power_delivery decoder
    Patched the installed libsigrokdecode usb_power_delivery decoder (Python,
    loaded by PulseView at startup) so a capture of our EPR session decodes
    properly. Everything below is verified against the real capture:
    - DATA_TYPES 9/10 = EPR Request / EPR Mode; EXT_TYPES and EXT_CTRL_TYPES
    tables for PD3.0/3.1/3.2 extended messages and Extended_Control.
    - Extended message framing: chunked (26 B per chunk) and unchunked, with
    chunk reassembly by data size, Chunk Request annotation, and CRC over
    header + extended header + all wire bytes (incl. padding). 77/77 captured
    frames pass the CRC check.
    - APDO subtype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
2026-11-02 feat(pd-epr): pace EPR KeepAlive at 375 ms, hand the work off to the next agent
    KeepAlive: the policy engine's own cadence is 500 ms, i.e. exactly on the
    PD3.1 ceiling. The app now emits its own KeepAlive on a 375 ms slot (the
    cadence the verified CH32X035 reference sink uses), skipping the send when
    any KeepAlive - ours or the stack's - went out less than 250 ms ago so the
    spec's minimum gap is preserved. Whether the stack's own 500 ms frame still
    interleaves is the first thing to check on the analyser.
    Docs: add Docs/HANDOFF_EPR_NEXT.md, a self-contained handoff covering the
    four conditions that must all hold for EPR to work (SinkTxOK, 4-byte
    CopyPDO, Unchunked+EPR RDO bits, absolute obje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
    [pd_input.c]
2026-11-02 fix(pd-epr): report why the app-side KeepAlive never reaches the wire
    Analyser result (4 MSa/s): the minimum KeepAlive gap stays 500 ms with no
    375 ms frames and no interleaving, so the policy engine never transmitted
    the app request - the same AMS/context problem that blocked the EPR entry
    in the first place (a machine registered from the main loop is not run).
    - EPR_ACT 0x2AA logs the refusal code, 0x2AB logs the first accepted
    request (so a capture can tell 'queued' from 'transmitted').
    - Two consecutive refusals disable the pacer and keep the stack's own
    500 ms frame, which is inside the PD3.1 250-500 ms window.
    - Handoff records the measurement and the three possible routes to a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
    [pd_input.c]
2026-11-02 fix(pd-epr): default to stack KeepAlive and bound app AMS probe
    Disable the experimentally untransmitted 375 ms app KeepAlive request by default.
    When explicitly enabled, stop after one accepted probe or two refusals so
    'queued but not sent' cannot repeatedly register AMS in PE.
    Update handoff measurements and test status. Preserve 28V EPR flow and main.
    [pd_epr_policy.h, pd_input.c]
2026-11-02 feat(ui): show SPR and EPR capabilities under Source PDO
    Mirror up to 13 source PDO positions, decode EPR Fixed and AVS,
    rename Statistics/PD in to Source PDO, invalidate stale EPR metadata,
    and extend source-stat host regression coverage.
    [pd_source_stats.c, pd_source_stats.h, test_pd_source_stats.c, ui_conf.c]
2026-11-02 fix(pd-epr): restore highest SPR fixed voltage on fallback
    Clear stale negotiation attempts after Hard Reset, preserve one-shot EPR
    lockout per attachment, and reselect highest legal SPR when previous PDO
    vanishes. Extend host selector regression and handoff library-timing notes.
    [pd_input.c, test_pd_select.c]
2026-11-02 fix(ui): pack valid Source PDO rows and drop late EPR callback data
    Keep object numbers 1..13 but skip reserved/empty text rows while
    rendering; do not mirror EPR metadata after mode exit.
    [pd_source_stats.h, ui_conf.c]
2026-11-02 fix(pd-ui): allow EPR-only mirrored PDOs when SPR cache is empty
    Do not show the No PD Source placeholder if EPR capabilities are present.
    [pd_source_stats.c]
2026-11-02 feat(pd): add nonblocking Fixed voltage policy and confirmed contract API
    Keep Sink active in 5V-only mode, cap the highest Fixed PDO by whole volts,
    and expose a PE-notified active Fixed RDO for the heater power controller.
    Respect Source-advertised SPR current up to the board's 7A hardware limit,
    including SW3538 20V/7A without a special-case PDO.
    Do not change EPR KeepAlive or force MCU resets.
    [pd_epr_policy.h, pd_input.c, pd_input.h, pd_select.c, pd_select.h]
2026-11-02 test(pd): verify Source-driven 7A requests and add Fixed policy CLI
    Exercise 20V/7A Fixed decoding, 7A board limit, 5/15V caps and
    confirmed-contract status; re-evaluate new Source capabilities.
    [console_cli.c, pd_input.c, pd_select.h, test_pd_select.c]
2026-11-02 test(pd): keep 5A Source PDO expectation after raising board cap to 7A
    The hardware cap is 7A, but a Source offering 5A must still be requested
    at 5A; avoid incorrectly equating source current to maximum hardware cap.
    [test_pd_select.c]
2026-11-02 fix(pd): avoid redundant voltage-cap AMS and parallel EPR entry
    Do not renegotiate a confirmed Fixed PDO still admitted by a lowered cap.
    Suppress EPR entry during a pending SPR policy update. Document 7A policy.
    [pd_epr_policy.h, pd_input.c]
2026-11-02 fix(pd): time out an unresolved RDO candidate so the budget cannot wedge
    The new policy layer invalidates the confirmed contract as soon as an RDO
    candidate is built and only promotes it from the explicit-contract
    notification. If the policy engine accepts the Request but never delivers
    that notification - the same AMS/context trap that swallows app-originated
    requests - the candidate stays pending for ever, PD_Input_GetActiveContract()
    keeps reporting no power budget and EPR entry stays blocked, i.e. the heater
    would sit at 0 W until the cable is replugged.
    The candidate now expires after 1.5 s (EPR_ACT 0x2AE reports the voltage it
    carried); the next Evaluate or capability set rebuilds it.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
    [pd_input.c]
2026-11-02 feat(pd-diag): flush the diagnostic queue when the power contract changes
    C140 bench log: after 'pd off' (28 V EPR -> 5 V SPR) nothing at all appeared,
    not even the EPR_ACT 0x2AD record for the exit request - the queued evidence
    would only print on a later main-loop pass that may never happen if the
    Source interrupts VBUS (this board is powered from it).
    - PD_Diag_Flush() drains the queue immediately.
    - The EPR-exit path now records 'reached the exit decision' (0x2B0) and the
    API result (0x2AD) and flushes both, so the next run distinguishes
    'handshake started and the source cut VBUS' from 'the app never got here'.
    - The bounded capability-refresh request (0x2AC/0x2AF) flushes as well.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
2026-11-02 diag(pd): dump full policy state 2s after a policy change
    C140 bench: 'pd off' printed and then produced no EPR-exit record and no
    capability refresh, while the MCU stayed alive (OLED running, no reset).
    Neither the EPR-exit block nor the SPR refresh block was reached, so a
    precondition at the top of PD_Input_EPR_Poll() never became true.
    Add a one-shot 0x2B1 record 2 s after PD_PolicyChanged() that packs
    attached/contract/EPR-mode/candidate/exit-queued/tries/req_enabled/maxV,
    then flushes the queue. It sits before the 'if(!s_state.attached)return;'
    early exit so an unattached link is reported too.
    [pd_input.c]
2026-11-02 fix(pd): drop out of EPR with a plain SPR Request, not the PE exit API
    C140 bench, 'pd off' from a 28V/5A EPR contract: '[CLI] Fixed request OFF
    (5V); negotiating' printed, then no further UART line, no [BOOT] reboot, OLED
    frozen on its last frame. The MCU was not powered down - the cooperative
    superloop stopped. printf only appends to the 512-byte ring; the DMA start
    lives in DebugUART_Service() in that same loop, so a stalled loop means the
    queued evidence never reaches the wire (that is why 0x2B0/0x2AD, which were
    already recorded, never appeared).
    The old code called USBPD_PE_Request_EPRModeExit() from the idle main loop.
    That registers a PE AMS machine which only that loop can advance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
    [pd_diag.c, pd_epr_policy.h, pd_input.c]
2026-11-02 fix(pd): send the EPR-mode policy Request from the foreground
    Bench log with the previous build (Lenovo C140, 28V/5A EPR, 'pd off'):
    EPR_ACT a=690 b=1 (GetSrcCap submitted)
    PD_TX a=7 (Get_Source_Capabilities on the wire)
    NOTIFY a=13 (GETSRCCAP_ACCEPTED)
    SPR_CAPS a=6, SPR_CAPS a=6
    NOTIFY a=30 x2, HARD_RESET a=0/3, then a=6 (FAILED) every ~1 s
    Two facts fall out of that:
    1. The Source_Capabilities messages arrived but PD_Input_Evaluate() was never
    called - no 0x2B5, no 0xBAD0 and no REQUEST record at all - so the sink sent
    nothing back. Inside EPR Mode the FULL PE does not ask the app for an RDO.
    tSinkRequest then expires and the Source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
    [pd_input.c]
2026-11-02 fix(cli): report a deferred 'pd max' instead of claiming a negotiation
    'pd off' keeps the requested level at 5 V, so PD_Input_SetMaxFixedVoltage()
    only stores the new cap in that state. The CLI printed 'negotiating' anyway,
    which looked like a failed negotiation on the bench ('pd max 15' after
    'pd off', value applied only once 'pd on' was issued).
    - setter returns 0 invalid / 1 requested (or nothing needed) / 2 stored only;
    - CLI prints 'Max Fixed 15V stored; request is OFF (5V), applies after pd on';
    - 'pd off' also logs MANUAL a=3 b=<volts> so a deferred change is visible in
    the diary;
    - handoff doc: record the verified C140 sequence (5 V / 15 V / 20 V / 28 V both
    ways, no EPR Mode Ex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
    [console_cli.c, pd_input.c, pd_input.h]
2026-11-02 refactor(pd): keep human-readable PDO, RDO, hard-reset and policy logs
    Deduplicate source capability records; share PDO decoding with the
    Statistics UI, remove production raw PHY/PE trace output and shrink
    its RAM queue 128->32. Keep the proven in-EPR EPR_Request path and
    native KeepAlive intact. Drop verbose successful PD stack boot dumps.
    [pd_diag.c, pd_diag.h, pd_input.c, pd_source_stats.c, pd_source_stats.h, test_pd_source_stats.c]
2026-11-02 size(pd): compile out legacy raw diagnostics and trim UART boot banners
    Fold suppressed event logging at call sites so armclang can remove argument
    packing and unused debug branches. Keep hard-reset/PDO/RDO/API records,
    U1OK initial UART probe and the verified EPR PE behavior.
    [pd_diag.c, pd_diag.h, usart.c]
2026-11-02 docs(pd): capture map baseline and safe pre-merge validation matrix
    Keep flush bounded at 16 records to avoid delaying cooperative EPR PE;
    document Flash/RAM baseline, safe diagnostic removals and required
    Keil + source-specific EPR-in-mode regression tests.
    [pd_diag.c]
2026-11-02 docs(pd): document the slimmed diagnostic log and how to re-enable traces
    The pre-merge size work turned PD_Diag_Record() into a filter macro and
    dropped every raw trace from the queue, so the handoff dictionary listed
    records that can no longer appear. Split it into what the default build
    actually prints (PDO / RDO / HARD_RESET / MANUAL 3,4 - the pd off and pd on
    paths now show up as 'RDO #1 5.00V 3.00A EPR' and 'RDO #8 28.00V 5.00A EPR')
    and what needs the filter removed first, and note where the old renderer
    lives in git history.
2026-11-02 feat(ih01a): restore Toby Fox About tile and add ARR-based cooperative beep framework
    Restore original Collar-Radio 30x30 icon. Add TIM14_CH1 PWM driver,
    zero-allocation FIFO note sequencer with compile-time ARR musical pitch
    constants, key toggle/demo menu, optional dialog audio pointer and third
    coroOS thread. Add host tests and documentation; leave USBPD code intact.
2026-11-02 perf(beep): avoid TIM14 register writes on idle scheduler passes
    Output is already disabled on clip termination, so an empty audio queue
    requires no hardware writes on each cooperative PD superloop pass.
    Keep the beep type include with other UI header imports.
    [beep.c, ui_conf.h]
2026-11-02 feat(beep): add default-off click/mute menu and Canon in D music action
    Trigger click feedback alongside PM idle refresh on debounced physical press,
    leaving wake actions quiet. Global mute stops/clears clips; Play Music
    unmutes and queues Pachelbel's public-domain violin opening (bars 3-4),
    with System Reset still the final settings item. Extend host tests.
    [app_tasks.c, beep.c, beep.h, system.c, test_beep.c]
2026-11-02 feat(heater): persistent timer/PI supervisor and DPC-inspired power budget
    Keep reservation and shutoff timers independent of MiaoUI, require
    confirmation after scheduled start, and keep physical TIM1 target fixed to
    zero during bring-up. Classify validated PD contracts vs DCin VBUS*7A.
    Add final coroOS idle task running PM and interrupt-woken WFI.
    Include host tests for scheduling, cap, safety, and overflow.
    [app_tasks.c, heater_budget.c, heater_budget.h, heater_control.c, heater_control.h, test_heater_control.c]
2026-11-02 fix(heater): read confirmed PD contract before calculating budget arguments
    [app_tasks.c]
2026-11-02 feat(ui): replace IH01A placeholder with persistent HEATER control panel
    Bind Main to temperature, input and power-budget snapshots; use selectable
    mode, target, stop/start timer and start/stop controls without owning their
    lifetime. Preserve About product ID, add Keil registration and supervisor
    architecture/commissioning notes. Fix host PD-mode test enum values.
    [heater_ui.c, test_heater_control.c, ui_conf.c]
2026-11-02 fix(heater): initialize power-mode target from live input ceiling and test true tick wraparound
    [heater_control.c, test_heater_control.c]
2026-11-02 feat(heater): filtered integer PID and automatic full-input power-mode default
    Keep derivative on filtered pot measurement to prevent setpoint kicks. Track
    live budget until a manual power adjustment, preserving lower user limit.
    Include Cortex header explicitly for idle WFI and extend budget regression.
    [app_tasks.c, heater_control.c, test_heater_control.c]
2026-11-02 feat(heater): publish atomic proposed power target while keeping PWM disarmed
2026-11-02 fix(heater): clear ISR proposal mailbox on framework initialization
    [heater_control.c, test_heater_control.c]
2026-11-02 feat(ui): show actual reservation and shutoff countdowns on HEATER page
2026-11-02 feat(protection): add raw ADC fail-safe monitor, zero-offset capture and DAC candidate calculations
    Introduce startup CT_RMS/IBUS 2048-frame averaging (after settling),
    noise rejection, 12-bit ADC rail trip latching and parameterized
    ARR/VBIAS-to-DAC proposal codes. Hardware comparators/DAC outputs remain
    disabled pending PCB polarity/gain validation. Include host test.
    [conv_protection.c, conv_protection.h, test_conv_protection.c]
2026-11-02 feat(powercontrol): integrate zero calibration and protection with ADC/Heater startup
    Move one-time ConvController ADC start into TempService foreground poll,
    add zero/rail ADC checks to existing RAM DMA frame processing, and fast
    PWM-only trip without stopping telemetry. Latch fault in Heater state,
    publish sound and 4-second UI fault overlay from foreground, gate PID
    proposal on successful calibration. Register Keil source and host tests.
2026-11-02 docs(protection): document staged G071 port and expose calibration/fault diagnostics
    Add a hard interlock during the ADC zero capture window, show zero offsets,
    DAC proposals and fault mask in Statistics/System, and document comparator
    routing limits, DAC calibration assumptions and safe commissioning sequence.
2026-11-02 feat(protection): add zero-referenced IBUS fast trip with disabled-until-calibrated limit
    No guessed ADC-count-to-ampere threshold. A measured raw delta may be
    installed later; the DMA ISR immediately gates PWM on an excursion.
    Extend host regression and commissioning notes.
2026-11-02 test(protection): assert zero-calibration gate and clarify startup/IRQ limits
2026-11-02 build(cubemx): make regeneration safe and drop the post-generate repair tool
    CubeMX regenerate (6.17) deleted Firmware/Middlewares/ST/STM32_USBPD_Library_v541
    (30 files) and stm32g0xx_ll_tim.c, so the next Keil build failed with 25 errors
    ('usbpd_core.h' not found, 'no such file or directory' for every device-layer
    source). Everything else survived: the custom IncludePath/Define
    (USBPDCORE_LIB_PD3_FULL), the custom file groups, uvoptx, the startup file and
    every USER CODE block (DebugUART_Init, USBPD_DPM_Run/TimerCounter,
    USBPD_PORT0_IRQHandler, IH_FatalReport). That is the whole damage model: CubeMX
    only prunes files it does not recognise under Firmware/Middlewares and
    Firmware/Drivers, and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
    [Compact_Induction_Heater.ioc, main.c, usbpd_hw_if_it.c, usbpd_phy.c, usbpd_phy_hw_if.c]
2026-11-02 chore(cubemx): commit generated TIM1 period/pulse change and Keil session state
    - CubeMX: TIM1 Period 853 -> 426 (~150 kHz) and PWM CH1 Pulse 0 -> 213 (50%),
    i.e. the compare value now matches half the new period. TIM1 is still never
    started by the application (HAL_TIM_PWM_Start is only used for the TIM14
    beep); PWM_EN stays low in ConvController_Init/ConvProtection, so nothing
    drives the heater from this change alone.
    - uvoptx: Keil re-synced its file list from uvprojx after the CubeMX pass.
    This also re-validates the regeneration hardening: the moved
    Firmware/ST_USBPD_Library_v541 survived the generate untouched, no tracked file
    was deleted, and no Middlewares/stm32g0xx_ll_tim ref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
2026-11-02 feat(protection): configure 33V/90C AWD thresholds and one-shot IRQ shutdown
    Use G071 AWD1 full 12-bit threshold 3379, AWD3 conservatively quantized
    90C NTC_SYS low threshold 640, and defer AWD2 until the measured IBUS
    zero is ready. Update AWD2 by source current using 0.2134V/A and account
    for 8-bit watchdog granularity. Remove incorrect ARR scaling from DAC
    window math; map hardware watchdog IRQ to latched cause and fast PWM trip.
2026-11-02 feat(protection): enable calibrated ±12A DAC/COMP window while bridge remains disabled
    After zero calibration and validated VBIAS headroom, write DAC1 thresholds
    (0.1V/A, ±12A), restore COMP1 window configuration after COMP2 init,
    then start both comparator peripherals. Keep TIM1 PWM_EN/MOE disabled.
    Do not allow threshold clipping and guard AWD2 enable transition after zero.
    Extend host regression for ARR-independent DAC thresholds.
2026-11-02 fix(protection): bipolar IBUS watchdog window, one-shot guard and foreground hardware trip
    Quantize both IBUS bounds against calibrated zero, monitor lower ADC rail
    where meaningful, avoid comparator reconfiguration after faults, and gate
    TIM1 on any foreground fault as well as on AWD/DMA interrupts. Expose AWD2
    range in Statistics/System and strengthen host tests.
    [conv_protection.c, conv_protection.h, dashboard.c, test_conv_protection.c]
2026-11-02 docs(powercontrol): consolidate AWD/COMP threshold calculations and commissioning guide
    Replace outdated staged-only documentation with current G071 interrupt
    mappings, 33V/90C thresholds, 0.2134V/A dynamic current window and
    fixed ±12A comparator hardware. Show comparator armed state in statistics.
    [dashboard.c]
2026-11-02 feat(safety): make PC6 FD2204 gate primary, hard-reset fatal paths, and document resonant voltage limit
    Emergency path forces GPIOC PC6 low before NVIC_SystemReset from NMI,
    HardFault, Error_Handler, assertion or UI reset. Keep timer MOE off as an
    additional shutdown mechanism. Add a future commissioning-locked enable
    API gated on both COMP comparator states, synthesized PA6 window output,
    TIM1 break and nonzero authorized power. Document 0.564V IBUS zero and
    correct half-cycle capacitor voltage physics for future ARR-based limit.
    [conv_controller.c, conv_controller.h, conv_protection.c, conv_protection.h, main.c, main.h, system.c, test_conv_protection.c]
2026-11-02 feat(powercontrol): generate bench 0-180deg TIM1 CH1/CH3 phase PWM with PC6 held off
    Map phase degrees to CCR1=ARR/2, CCR3=D, CCR4=D+ARR/2 in a pure
    host-tested helper. Update compare preloads as a group and start CH1/CH3
    logic waveforms only after zero capture and comparator initialization.
    Do not treat momentary comparator lows as persistent faults; rely on TIM1
    hardware break. FD2204 gate PC6 remains LOW and no heating is enabled.
2026-11-02 feat(ui): default HEATER to manual 0..180deg PWM phase with 10deg steps
    Replace the uncalibrated watt setting in the POWER view with a direct
    phase-angle command and show CH3/CH4 register values and PWM/PC6 status.
    Apply scope changes immediately and reconcile in the background supervisor,
    starting logic PWM only after zero capture/COMP setup. Never enable PC6.
    Preserve temperature PI, timer scheduling and hardware shutdown gates.
    [app_tasks.c, conv_protection.c, conv_protection.h, heater_control.c, heater_control.h, heater_ui.c, test_heater_control.c]
2026-11-02 fix(ui): focus manual phase by default and fit TIM1/PC6 status in 128px OLED
    Keep scope PWM's forced PC6-low invariant exclusive to uncommissioned bench
    build so later power-stage commissioning can manage gate state separately.
    [conv_controller.c, heater_ui.c]
2026-11-02 fix(pwm): clear startup-only break latch once and never auto-rearm after an active break
    Preserve low PC6 gate, initialize timer outputs only after comparator/zero
    readiness, and avoid polling comparator window output for startup or future
    hardware trip handling. Hardware TIM1 BRK remains the fast protection path.
    [conv_controller.c, conv_controller.h]
2026-11-02 feat(bench): default PD to 12V/3A and TIM1 to 200kHz
    Set timer ARR=639, CCR1=319 for PLL 128MHz, retain unused CH2 DMA
    configuration, select <=12V fixed PD by default and disable auto EPR.
    Limit the initial low-voltage RDO to 3A. Keep manual PD diagnostics.
    [Compact_Induction_Heater.ioc, conv_phase.c, pd_epr_policy.h, pd_input.c, test_conv_phase.c]
2026-11-02 feat(zcd): add foreground TIM1 CH2 CCR capture reader and modular current lag math
    No DMA or 200kHz capture interrupt. Reuse existing rising edge PA9 capture,
    read CCR2 in foreground, normalize phase using ARR/4 + D/2 reference,
    mark 0-degree waveform undefined, and add host tests and Keil registration.
2026-11-02 feat(zcd): start TIM1 CH2 capture without DMA and display current lag on Main
    Enable CC2 capture alongside logic PWM, read the most recent CCR2 only
    in the foreground UI, and show signed degree lag. Correct host test sign
    for a capture near CNT=0 in the 180deg reference example.
    [conv_controller.c, heater_ui.c, test_conv_zcd.c]
2026-11-02 feat(bench): add explicit 12V low-power PC6 gate with TIM1 break ISR and 10s timeout
    Only RUN requested with a confirmed 12V <=3A PD contract, valid NTC/zero,
    COMP and 10..20deg phase may assert FD2204 PC6 for at most 10s. Any
    invalid condition aborts without automatic retry. Hardware TIM1 Break
    IRQ immediately drives PC6 low and latches a fault while retaining BIF.
    A raw ADC VBUS guard trips if the energized bus leaves its bench window.
2026-11-02 fix(bench): add ISR-side 10s PC6 watchdog independent of PD foreground scheduler
    After 200000 TIM6 ADC complete frames (~10s) with FD2204 EN asserted,
    trip from SRAM ADC frame processing and latch a timeout fault. Retain
    foreground wall-clock deadline. No automatic restart after timeout.
    [conv_controller.c, conv_controller.h, conv_protection.c, conv_protection.h]
2026-11-02 docs(bench): document 12V/200kHz manual heating limits and TP1941 CCR2 capture
    Expose the 10s bench timer on Main, remove obsolete unconditional PC6-off
    comments and record exact interlocks, 10deg/20deg scope steps, ISR trip
    paths, phase sign/wrap math and no-DMA capture caveats.
2026-11-02 fix(zcd): reject unpowered comparator noise and immediately disable PC6 on mode/schedule changes
    Current-zero phase is valid only while FD2204 is actually enabled.
    Changing Main control mode or reservation time pulls PC6 low in the same
    foreground UI action, rather than waiting up to 100ms for the supervisor.
    [conv_zcd.c, heater_ui.c]
2026-11-03 feat(heater): show why a bench RUN was refused instead of reverting silently
    '启动' in the HEATER page went REQ -> STOP within one 100 ms tick with no
    explanation: ConvController_BenchRunPoll() evaluates a long AND gate and calls
    Heater_Stop() as soon as any clause fails, so the UI only ever saw HEATER_OFF.
    Expand that AND into bench_block_reason() with the same clauses in the same
    order, latch the first failing one in s_bench_block, and render it on the
    status line as R:<code> (MOD ANG APP NOPD 12V CUR SRC BUS ZERO NTC HOT AGE PWM
    COMP FLT BRK 10S). The 10 s budget expiry is reported as R:10S. The code
    clears when a RUN is actually accepted, so it always describes the last
    attempt; the e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
    [conv_controller.c, conv_controller.h, heater_ui.c]
2026-11-03 feat(heater): allow any phase angle and drop the countdown start
    Bench feedback: 'RUN' only ever showed R:ANG, and the reservation countdown
    was unwanted.
    Angle:
    - remove the 10..20 deg clause from the bench gate: any 0..180 deg is allowed;
    - ConvController_SetPhaseDegrees() no longer aborts a running bench when the
    angle changes (including 0 deg) - the angle is a manual scope/observability
    setting, not a watt request, so it must not be a stop condition;
    - drop IH_BENCH_MAX_ANGLE_DEG, CONV_BENCH_ANGLE and the R:ANG code.
    Countdown start:
    - delete Heater_ScheduleMinutes(), the HEATER_WAIT_START/HEATER_WAIT_CONFIRM
    states, on_minutes/on_remaining_s and the reservation branch in
    Heate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
    [conv_controller.c, conv_controller.h, heater_control.c, heater_control.h, heater_ui.c, test_heater_control.c]
2026-11-03 feat(heater): remove the 10 s bench time budget
    '10s countdown still there' + 'startup reports 0x00010000': both were the same
    mechanism. CONV_PROT_BENCH_TIMEOUT = 1<<16 = 0x00010000 was latched by
    ConvController_BenchAdcFrameWatchdogISR() after 200000 TIM6 frames (~10 s), the
    supervisor latched it into Heater_FAULT and the dashboard printed it as
    'PROT: 0x00010000'.
    - ConvController_BenchRunPoll(): no IH_BENCH_MAX_RUNTIME_MS stop any more; a run
    now lasts until the user stops, a RUN gate clause fails, or protection trips;
    - the ADC-frame counter is kept but never trips (documented as diagnostic only),
    and conv_protection no longer sets CONV_PROT_BENCH_TIMEOUT (bit kept, marked
    obsole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
    [conv_controller.c, conv_controller.h, conv_protection.c, conv_protection.h, heater_ui.c]
2026-11-03 feat(heater): show commanded vs actual PC6 level on the status line
    'E:Y' only reports the ODR output latch, so it cannot distinguish 'firmware
    enabled it' from 'the pin really is high'. The second character now reads PC6
    back through IDR (valid for a push-pull output, where IDR mirrors the driven
    level) and shows '-' when MODER is no longer 'general purpose output':
    E:YY -> commanded high, pin reads high
    E:Yn -> commanded high, pin reads LOW: external load holds it down
    E:Y- -> commanded high, but MODER is not output (configuration lost)
    E:NN -> commanded low (idle)
    Rebuild: Code=92572 RO=4600 RW=468 ZI=23108, 0 Error / 0 Warning.
    [conv_controller.c, conv_controller.h, heater_ui.c]
2026-11-03 feat(heater): add pure frequency ARR mapping and zero-referenced CT_RMS current conversion
    Introduce 180-300kHz 10kHz-step TIM1 period math (128MHz kernel),
    allow 1-degree phase tuning without changing Main's 10-degree buttons,
    and convert CT_RMS ADC voltage relative to calibrated zero using
    0.25253V/A in integer mA. Register host regression and Keil source.
2026-11-03 feat(powercontrol): safely tune TIM1 frequency and inhibit sleep while PC6 heats
    Add 180..300kHz foreground ARR/CCR updates with timer stopped, PC6 gated
    LOW before any change and no automatic RUN restart. Prevent manual PM sleep,
    pause idle countdown, keep UI awake and skip idle WFI while FD2204 EN is
    asserted. Move CH2 capture polling to heater background for any UI page.
    [app_tasks.c, conv_controller.c, conv_controller.h, conv_zcd.c, pm_api.c, pm_api.h]
2026-11-03 feat(ui): add Settings/Heater with guarded PC6 switch, fine phase, frequency and live captures
    Use native MiaoUI switch and integer editing (1deg, 10kHz); show raw
    TIM1_CH2, signed lag, zero-corrected CT_RMS current at 0.25253V/A, and
    last gate status. All PC6 writes stay behind the existing Heater/Bench
    interlocks; current conversion is display-only. Register Keil UI module.
    [heater_settings.c, heater_settings.h, heater_ui.c, ui_conf.c]
2026-11-03 docs(heater): document Settings controls, CT_RMS calibration and sleep inhibition
    Mark ADC saturation instead of reporting falsely precise amperes, remove
    obsolete 10s bench claim, and provide commissioning steps for live PC6,
    1deg phase, 10kHz frequency and PM/Break behavior.
2026-11-03 fix(ui): show actual PC6 pin readback and suppress CT current on ADC fault
    Distinguish PC6 ODR-high from externally forced pin-low on the Heater
    settings screen, and avoid showing a stale ampere reading when the ADC
    controller leaves its monitoring state.
    [heater_settings.c]
2026-11-03 feat(heater): live atomic TIM1 ARR/CCR preload tuning with PC6 enabled
    With ARPE/OC1PE/OC3PE/OC4PE active, stage ARR and CCR1/3/4 under
    UDIS and commit together at the next natural overflow; no CEN stop,
    CNT reset, UG or PC6 power interruption while timer runs. Fail closed
    if preload configuration is missing. Set Settings phase step to 10deg
    and extend phase/frequency host regression coverage.
    [conv_controller.c, conv_controller.h, heater_settings.c, test_conv_phase.c]
2026-11-03 fix(heater): refuse timer UG on stopped TIM1 if PC6 still asserted
    Fail closed on an inconsistent CEN=0, PC6=HIGH state instead of
    allowing the startup-only UG/CNT preload load path while power is on.
    [conv_controller.c]
2026-11-04 feat(cli): prepare strict heater command parser and 150-400kHz timer range
    Allow 1kHz-frequency requests within 150-400kHz; UI remains 10kHz step.
    Parse heater get/on/off/phase/freq with full-token and numeric range checks,
    and add host regression for malformed commands and timer bounds.
2026-11-04 feat(heater): add synchronous protected start request for UART automation
    Cache last complete 100ms heater observation, reject stale/uninitialized
    snapshots, and perform the same PD/temperature/COMP/Break gate now.
    Return success only if actual PC6 readback is HIGH. Never bypass guard
    or auto-start on later PD attach.
2026-11-04 feat(uart): implement Heater CLI with strict one-line ACK/ERR and full GET telemetry
    Commands: heater phase 0..180, freq 150..400kHz, on/off, get.
    Apply phase/frequency via existing atomic TIM1 preloads, use synchronous
    protected bench gate for ON, and report real phase/frequency/IC2/Lag/CT_RMS.
    Support NA/SAT data markers. Register console modules in Keil project.
2026-11-04 docs(tools): specify Heater UART agent protocol and add one-command pyserial client
    Document exact ACK/ERR schema and GET fields, timing and protection rules.
    Provide local COM-port Python client that ignores asynchronous PD diagnostics
    and never starts the heater automatically.
2026-11-04 test(cli): host-mock full Heater command paths and machine-readable telemetry
    Exercise strict ACK/ERR responses, range failures, protected ON refusal,
    actual ON/OFF success, GET phase/frequency/IC2/lag/current, stale capture
    and saturated ADC without STM32 HAL or attached hardware.
    [heater_cli.c, heater_cli_mock.h, test_heater_cli_commands.c]
2026-11-04 docs(heater): synchronize live tuning ranges, console guide and host test scope
    Document 150..400kHz 1kHz CLI setpoints versus 10kHz UI step; link the
    machine-readable UART protocol from the Console documentation.
2026-11-04 fix(uart): discard entire overlong RX lines before command dispatch
    Prevent a long corrupt input fragment from becoming a valid heater command
    (e.g., unintended ON). Report a single line-too-long error on newline.
    Document 10Hz IC2 foreground sampling cadence for agent polling.
    [console_cli.c]
2026-11-04 feat(cli): refresh TIM1_CH2 input capture on each explicit heater get
    Allow agent-driven polling to read the latest CCR2 without waiting for the
    100ms heater task. Continue using foreground register capture (no DMA/IRQ)
    and retain NA on invalid/off data.
2026-11-04 test(cli): stub explicit CH2 poll in host command regression
    GET now refreshes capture at request time; mock the hardware poll to retain
    the deterministic injected CCR2 sample in host tests.
2026-11-04 docs(uart): correct garbled-frame root cause to host read pattern
    Blocking Serial.read() lets the WCH-Link receive buffer overflow, so every
    byte past roughly the 45th of a long reply arrives bit-slipped; the previous
    note blamed the bridge and EMI. Spin on in_waiting instead: 8/8 clean frames
    vs 8/8 corrupt with blocking reads on the same 94-byte heater reply.
2026-11-04 feat(tools): host serial CLI and heater freq/phase sweep tooling
    serial_cli.py drives the legacy CLI and the HCLI heater commands with
    grammar-validated replies and re-sends. heater_sweep.py runs the 2-D
    frequency x phase sweep with a link preflight gate, per-row low-phase entry,
    and abort on FAULT / ADC saturation / CT_RMS guard. heater_sweep_fill.py
    revisits points that reported IC2=NA.
2026-11-04 docs(heater): 12V unloaded frequency x phase sweep results
    450 points (160-400 kHz x 10-180 deg, 1 s settle) with IC2 raw capture,
    LAG_DEG and CT_RMS_A. 0 bad frames, 0 re-sends, heater ON for all points,
    CT_RMS peaks at 1.687 A at 160 kHz / 180 deg. 24 points report IC2=NA in the
    high-frequency low-phase corner, where the tank current is too small for a
    valid TIM1_CH2 capture.
    [pivot_ct.csv, pivot_ic2.csv, pivot_lag.csv, sweep_12V_unloaded.csv]
2026-11-04 chore(mdk): register heater_settings.c and conv_current.c in Keil project
    The Keil project file did not list these two sources while the CMake/repo
    state already referenced them. Project registration only; no code change.
2026-11-04 feat(zcd): implement latest piecewise IC2 phase delay correction from CT analysis
    Use 58-count anchor with 230/175kHz signed slopes in integer milli-ticks,
    calculated from actual ARR. Keep raw IC2/lag alongside corrected lag.
    Only accept fitted phase samples for 160..330kHz, phase 120..180deg and
    zero-referenced CT >=50mA; no loaded-ZVS/PLL authorization. Add host vectors.
    [conv_zcd.c, test_conv_zcd.c]
2026-11-04 feat(heater): display gated corrected Lag in Settings and UART telemetry
    Show corrected and original phase separately. GET retains raw IC2 and
    LAG_RAW_DEG while LAG_DEG becomes compensated; add LAG_QUAL model status
    (FIT/FREQ/PHASE/LOW_CT/ADC/NO_IC2) and NA for unqualified correction.
    CT_RMS >=50mA and valid ADC are mandatory to report a corrected angle.
    [heater_cli.c, heater_settings.c, test_heater_cli_commands.c]
2026-11-04 test(cli): cover corrected phase quality and low-CT/ADC/range rejection
    Mock the pure correction-eligibility policy in CLI unit tests; verify raw
    IC2/lag stay visible while calibrated Lag is NA for low current, missing
    ADC or unsupported frequency.
    [test_heater_cli_commands.c]
2026-11-04 docs(zcd): record latest CT zero-cross piecewise compensation and validity envelope
    Document 175/230kHz slopes, signed IC2 delay, 160..330kHz/120..180deg/
    50mA gating, raw-versus-corrected CLI fields and empty-load-only limits.
    Update Heater Settings manual and host test overview.
2026-11-04 test(zcd): guard signed delay, ±180deg wrapping and 160/330kHz fit boundaries
    Clear newly added calibration state on re-init. Cover negative 160kHz
    bias, signed phase wrapping, phase 119/120deg, low/high actual-ARR
    boundary acceptance, preventing silent extrapolation.
    [conv_zcd.c, test_conv_zcd.c]
2026-11-04 fix(zcd): subtract signed delay in IC2 count domain before one angle rounding
    Convert delta4 quarter-ticks to milli-ticks, subtract the fitted delay,
    wrap within the new PWM period and round to 0.1deg once. Avoid double
    rounding raw angle and delay. Verify numeric smoke examples and docs.
    [conv_zcd.c]
2026-11-04 feat(ui): use eligible compensated phase on Main heater dashboard
    Main row shows IC2 with C: corrected Lag for fitted empty-coil domain,
    otherwise R: raw Lag. Reuse CT_RMS validity/50mA and 120..180deg guards
    so Main, Settings and UART do not disagree about phase interpretation.
    [heater_ui.c]
2026-11-04 feat(heater): deterministic ISR automatic frequency tracking
    Squash 5ms / 100-frame ADC DMA auto-frequency control, fixed-point
    ZCD lag correction, exact timer preload updates, guarded output,
    Settings/CLI auto toggle, host tests, documentation and CI.
    Bench-only: loaded ZVS and ISR worst-case timing not yet validated.
    [app_tasks.c, conv_adc.c, conv_adc.h, conv_auto_freq.c, conv_auto_freq.h, conv_controller.c, conv_controller.h, conv_phase.c]
2026-11-05 feat(heater): prepare 2S2P coil and restore manual frequency with auto off
    - Revise CT_OUT gain to 0.075V/A and estimated CT_RMS scaling
    - Preserve approximately +/-12A CT_OCP peak trip with 1474-count DAC window
    - Keep IBUS calibration and watchdog unchanged
    - Invalidate old CT_ZERO fit and lock out auto tracking pending recalibration
    - Restore manual 150-400kHz GUI/CLI tuning when Auto Freq is OFF
    - Default phase to 180 degrees throughout policy, PWM and Settings
    - Update UART client, host tests and measurement documentation
    Hardware and Keil target validation required before loaded operation.
2026-11-05 fix(pm): honor manual UI_OFF despite paused automatic idle countdown
    - Make root MiaoUI BACK bypass fading and enter UI_OFF immediately
    - Keep block masks freezing automatic idle countdown only, not manual expiry
    - Ignore generic activity during user-requested UI_OFF to prevent OLED bounce
    - Distinguish physical-key wake from automatic refresh and preserve wake debounce
    - Override paused timer gate when forced, preserving No Auto Sleep semantics
    - Add end-to-end host regression for blocked timer, wake and auto sleep
    UI_OFF leaves power conversion, ADC protections and PD runtime active.
    [app_tasks.c, pm_api.c, pm_api.h, pm_controller.c, pm_sleep_timer.c, pm_sleep_timer.h, test_pm_manual.c, test_pm_timer.c]
2026-11-05 fix(heater): allow guarded manual restart after transient protection trips
    - Keep ISR trip immediate; separate operator acknowledgment from persistent hardware faults
    - On explicit RUN, preflight live 12V PD, VBUS, NTC and phase settings
    - Restore ADC AWD1/2/3 one-shot IRQ protection and validate raw/filtered IBUS
    - Re-arm TIM1 Break/MOE with PC6 LOW only after hardware comparator window is safe
    - Preserve hard startup calibration/setup faults as non-acknowledgeable
    - Route Settings PC6 switch and Main RUN through shared guarded enable
    - Display signed, zero-corrected 0.2134V/A IBUS in Heater and Settings/Heater
    - Remove IBUS voltage row from Statistics/System; keep calibration diagnostics
    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
    [conv_controller.c, conv_current.c, conv_current.h, conv_protection.c, conv_protection.h, dashboard.c, heater_control.c, heater_control.h]
2026-11-06 fix(heater): recover failed zero calibration and restore IBUS/LagC UI
    - Correct a prior missed display commit: show signed zero-referenced IBUS current on both Heater screens
    - Remove CT0 row from Heater and System diagnostics while keeping IB0
    - Display historical LagC numerical phase estimate whenever its model is computable; do not require new CT qualification for display
    - Keep calibrated ZCD/AUTO_FREQ gate unchanged: old fit is not safe for feedback
    - Distinguish CT_RMS ZERO WAIT, AVERAGING, FAILED and ADC unavailable states
    - On explicit manual RUN after zero failure, restart the ADC zero window atomically with PC6/MOE off; require a separate second RUN after success
    - Allow recovered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
    [conv_controller.c, conv_protection.c, conv_protection.h, dashboard.c, heater_settings.c, heater_ui.c, test_conv_protection.c]
2026-11-06 fix(heater): drop hard-coded 12V bench gates at run preflight
    The bench preflight rejected any contract other than 12000 mV / 1..3000 mA and
    any VBUS outside 10800..13200 mV, and the frame ISR tripped CONV_PROT_BENCH_VBUS
    on raw VBUS outside 1050..1400 counts while PWM was enabled. Both encode the
    previous single-12V-PD bench. Remaining gates (PD source, phase readback shift,
    zero calibration, NTC, COMP and TIM1 Break) are unchanged.
    [conv_controller.c, conv_protection.c]
2026-11-06 feat(pd): default to automatic 28V EPR, remove 12V-only rearm gate
    - Set default highest Fixed target to 28V and auto-attempt EPR once after valid SPR contract
    - Preserve the highest permitted SPR Fixed fallback and explicit-contract validation
    - Replace obsolete 12V-only ADC rearm window with generic physical VBUS/ADC bounds
    - Keep current, undervoltage/rail, comparator, TIM1 Break and ADC watchdog interlocks
    - Add host regressions for 12/20/28V recovery and EPR policy defaults
    - Clarify that PD negotiation never automatically starts the power stage
    [conv_controller.c, conv_protection.c, conv_protection.h, pd_epr_policy.h, pd_input.c, test_conv_protection.c, test_pd_select.c]
2026-11-06 feat(heater): apply RDO current control margin and AWD2 trip headroom
    - For valid PD contract >20V reserve 100mA for future controller; otherwise reserve 200mA
    - Set IBUS AWD2 trip 150mA above the control ceiling, independently of CT/TIM1 Break OCP
    - Base provisional power budget on reserved input control current, no new closed-loop heater enable
    - Preserve zero/undersized contract fail-closed behavior
    - Record distinct high-bit Heater policy fault reasons instead of FAULT:00000000
    - Extend host regressions for current margins, 20V boundary, and local faults
    - Document AWD2 quantization and unchanged hardware CT peak protection
    [conv_controller.c, heater_budget.c, heater_budget.h, heater_control.c, heater_control.h, test_heater_control.c]
2026-11-06 diag(reset): report STM32G071 reset flags and retained emergency origin
    - Keep early U1OK UART probe, then queue one nonblocking RCC CSR reset report
    - Decode PWR/PIN/SW/IWDG/WWDG/LPWR/OBL without falsely separating POR and BOR
    - Reserve a checked 16-byte UNINIT SRAM2 reset record in the existing guard gap
    - Attribute intentional software resets from HardFault, NMI, Error_Handler and assertions
    - Consume the record only for SFTRSTF without PWRRSTF, fail closed on unknown RAM
    - Preserve immediate PC6 shutdown before reset and avoid UART/printf in fault IRQs
    - Add no-HAL host regression for reset marker integrity and cold-boot rejection
    - Document high-power C140 reset capture procedure
    [ih_reset_diag.h, main.c, main.h, test_ih_reset_diag.c, usart.c, usart.h]
2026-11-09 diag(ibus): latch AWD2 pre-IRQ ADC history and watchdog window
    - Keep contract-based +150mA instantaneous AWD2 trip margin unchanged
    - Capture IBUS min/max/last processed DMA samples during an armed run
    - Latch that history on AWD2 IRQ before shutting down the bridge
    - Emit one foreground [AWD2_IBUS] line with the configured trip mA, calibrated zero and quantized ADC window
    - Explicitly distinguish prior completed DMA samples from the exact faulting conversion
    - Expose capture fields in ConvProtectionSnapshot for Keil Watch
    - Extend host coverage; document 28V 128W peak-vs-average diagnostic limitations
2026-11-09 feat(heater): opt-in six-cycle 150kHz pan probe with IC2 DMA capture
    - Add Pan Detect switch in Settings/Heater and Main, disabled by default
    - Require a nonzero Heater automatic-stop countdown and explicit RUN; never continuously energize PC6 in probe mode
    - Schedule six-period 150kHz/180deg bursts at two-second intervals, gate PC6 in TIM1 UPDATE IRQ and keep timer counting after pulse
    - Reuse configured TIM1_CH2 -> DMA1 Channel3 normal halfword capture, collect post-pulse decay and output only raw transferred valid CCR2 values
    - Partition on-pulse from post-pulse captures in compact [PAN] UART records; no pot classification yet
    - Preserve normal frequency and phase across probes, reject li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
2026-11-09 fix(pan-probe): atomically invalidate pending TIM1 pulse on STOP and faults
    - Mask interrupts around PC6 LOW and pan update IRQ disarm
    - Prevent a pending 150kHz UPDATE ISR from reasserting PC6 after explicit STOP
    - Apply identical atomicity to emergency TripISR before timer state invalidation
    - Keep DMA cleanup and preload restoration in foreground, outside masked region
    [app_tasks.c, conv_controller.c, conv_controller.h, heater_control.c, heater_control.h, heater_settings.c, heater_ui.c, test_heater_control.c]
2026-11-10 fix(pan): restore missing controller/UI wiring and unique ADC DMA IRQ owner
    - Add missing HeaterSnapshot.pan_detect_enabled, default-OFF setter and no-countdown fail-closed mode
    - Declare CONV_BENCH_COUNTDOWN and PanProbe controller entry points
    - Export CubeMX TIM1_CH2 DMA handle in tim.h USER CODE region
    - Expose Pan Detect toggle in Heater Settings/Main; enforce stop-only changes
    - Call PanProbeService in cooperative loop and preserve probe timer phase
    - Enable the six-cycle TIM1 UPDATE IRQ handler, preserving Break priority
    - Remove duplicate CubeMX DMA1 Channel2_3 handler; controller SRAM ISR remains sole owner
    - Restore negotiated IBUS AWD2 margin rather than overwriting with raw RDO
    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
    [app_tasks.c, conv_controller.h, heater_control.c, heater_control.h, heater_settings.c, heater_ui.c, test_heater_control.c]
2026-11-10 diag(pan): explain COUNTDOWN block and expose probe state in CLI
    - Translate missing CONV_BENCH_COUNTDOWN block to explicit COUNTDOWN response
    - Include PAN enable, OFF timer, remaining seconds, probe stage and sequence in heater get
    - Count every armed probe, including windows without IC2 captures, while preserving valid-captures-only UART output
    - Distinguish queued Pan RUN from continuously energized heater on response
    - Extend host CLI regression for countdown rejection and pan status reporting
    [conv_controller.c, conv_controller.h, heater_cli.c, test_heater_cli_commands.c]
2026-11-10 fix(ui): keep Main edit selector visible after rejected RUN and draw OFF countdown
    - Always show >MODE/>TARGET/>OFF/>PAN/>RUN in Main footer, including when R:TIME or another latched run block is active
    - Correct prior bug where formatted OFF countdown was overwritten by PAN/IC2 before DrawStr
    - Share row between visible OFF countdown and PAN status or concise IC2 raw capture
    - Preserve existing ENTER cycle and LEFT/RIGHT edit semantics; no change to power stage safety controls
    - Add HAL-free host regressions for selected field under R:TIME, countdown, pan mode, and IC2 display
    [heater_ui.c, heater_ui_format.h, test_heater_ui_format.c]
2026-11-10 fix(pan): change probe to 160kHz and shorten burst to two periods
    - After a 12 V 150kHz/6-period burst tripped TIM1 Break (0x00004000), reduce commanded gate duration from 40us to nominal 12.5us
    - Preserve manual authorization, 2s cadence, 180deg phase, post-gate IC2 DMA capture and all COMP/ADC/TIM1 Break protections
    - Centralize the pulse profile for host checks; format serial PAN frequency and cycle fields from current profile rather than stale literals
    - Verify TIM1 ARR=799 for exact 160kHz at 128MHz and nominal two-period timing
    - Document observed 158kHz resonant ringing and that changing frequency alone does not ensure safe operation
    [conv_controller.c, conv_controller.h, pan_probe_config.h, test_pan_probe_config.c]
2026-11-10 fix(heater): raise NTC hot block and CT overcurrent profile for 2S2P bench
    Bench preflight refused to start once the pot sensor reached 70.0 C or the
    system sensor 60.0 C; both thresholds are raised to 110.0 C / 80.0 C so a warm
    bench does not block RUN. The fixed CT overcurrent compare profile moves from
    12 A to 16 A. COMP/DAC hardware Break, TIM1 Break and the AWD current path are
    unchanged.
    [conv_controller.c, conv_protection.c]
2026-11-10 chore(git): pin Images/ contents as binary assets
    Treat everything under Images/ as binary: no EOL conversion, no text diff.
    Markdown and .gitkeep files inside the tree stay textual so documentation
    changes remain reviewable.
2026-11-10 docs(images): add #002 pan-probe bench captures
    Four probe waveforms for the second coil build: 1.6 mm wire with pan, no-pan
    probe, adhered to a Tetra Pak milk carton, and adhered with pan. Stored as
    binary per the Images/ attribute policy.
2026-11-10 docs(pan): visualize 12V probe records and embed existing scope screenshots
2026-11-10 fix(protection): restore 12A CT comparator window and revert incomplete font swap
    [conv_protection.c]
2026-11-10 fix(protection): retain nominal 16A DAC window; run host CI on demand
    [conv_protection.c, test_conv_protection.c]
2026-11-11 fix(ui): preserve translated menu hierarchy and adjust TEXT selection padding
    [i18n.c, ui_conf.h]
2026-11-14 perf(images): recompress #001/#002 bench captures to ~70 KB
    Same 1024x600 frames, re-encoded from 2457659 bytes each down to 68-75 KB
    (about 32x smaller), so the capture log no longer dominates repository size.
2026-11-14 docs(images): add #003/#004 bench captures and product photos
    #003: 300K at 71 W and 300K idle, each with capacitor voltage against CT
    output, zero-cross detection and precision-rectifier output.
    #004: 300K idle half-bridge rising and falling edges.
    Images/Product: front, back and about-page product photos.
