TKWTL/IH01A-Compact_Induction_Heater/(notices)

Notices in the files:
Firmware/USBPD/App/usbpd_pdo_defs.h:
Copyright (c) 2026 STMicroelectronics.
All rights reserved.
